Doom956/Robocup-Junior-Theseus/SIM_WORKLIST.md

# Simulator work list for the fast PC (written 2026-10-18)

**How to start:** on the fast PC, `git checkout main`, `git pull`, `git fetch`, open Claude Code in this folder and say
**"work through SIM_WORKLIST.md"** (or name one item). Work top to bottom unless I say otherwise. Tick items off in this
file (`[x]` plus a one-line result) and push, so both PCs see the progress.

## 2026-10-20: regression check, two sim fixes, avoidance in a corridor (P2 / P3, waiting for the user's decision)

All numbers on the current sim (9904879 + 71f1e4f), 600 comp fields, seeds 1-600 / 601-1200, +- = 95% interval.

- [x] **Sim fix: the BNO055 updates at 100 Hz** (9904879). Reads within 10 ms return the same sample; before, every read
  had fresh noise. robot-test score -0.7 +-3.3, home -1 +-4, bench/turn numbers the same.
- [x] **Sim fix: a run starts with the pause switch flipped** (71f1e4f, `startPauseS` 0.5).
  - The robot starts every run from PAUSE (white reference on the start tile, run clock, heading zero). The sim didn't, so
    the code's first PAUSE was a referee restart.
  - Since 68e0c47 that restarted the run clock mid-run. Main's home rate looked 5 pts worse for 68e0c47; with the fix it is
    +1 / +3. Also, the white reference had been taken on a checkpoint.
- [x] **Regression check: robot-test (fa2636b: ramp guard, blue wait, 2p) vs the known-good versions.**
  - vs `known-good-2026-10-19`: score +1.8 +-3.0 / -0.2 +-2.8 / +0.5 +-2.8 (third set: seeds 1201-1800), home -3 +-3 /
    -2 +-3 / 0 +-3, time lost 0 / +1 / -1. No measurable regression.
  - vs `known-good-2026-10-17`: +81.8 / +78.5, home +28 / +24, time lost -25 / -24.
- [x] **main vs its 2026-10-17 build (a04df32): home -6 +-5 / -6 +-5** (score -0.3 / +2.3, time lost -7 / -9). Step by step:
  - 6a9f87e (the 2026-10-17 robot fixes): home -4 +-5 / -8 +-5, time lost -10 / -8.
  - 357f049 (ramp guard): home -6 +-3 / -2 +-3.
  - Others within +-2 (68e0c47 neutral once the sim start was fixed).
  - Both were added after real failures and stay (user, 2026-10-20). Main is lost 56% of the time in the sim; the robot
    runs robot-test.
- [x] **When the ramp cap (3 tiles) fires** (300 runs each):
  - main 123 times, robot-test 37 times. Every time but one, a `climb timeout` happened in the same move: the sim robot was
    stuck on the slope and the wheels counted 13-25 "ramp tiles". The cap only changes which wrong count a stuck robot
    keeps.
  - Main gets stuck on ramps more (no 2l ramp fixes), so its home number moves.
  - The real robot has never logged a `climb timeout` (all logs 2026-10-17/19), and in the lift test the 35 deg check
    alone handled it. robot-test: no home drop on 3 seed sets.
- [x] **Obstacle avoidance in a 280-300 mm corridor (T1 tests 6 and 2): P2 + P3 applied (user yes, 2026-10-20).** P3 on
  main (9c6757f; main alone -0.6 +-3.3 / -0.3 +-3.4, no harm) and robot-test (d55e55d, 2q); P2 on robot-test only (09b5fe7,
  2r). ROBOT_TEST 2q/2r: robot test = TEST_PRIORITY 6, watch the 300 ms lurch. robot-test now has 5 unconfirmed changes:
  no more firmware changes until a maze session confirms some.
  - Why test 6 fails (traced, sim): the drive-around (`obstacleavoidanceSteps()` in Distance.cpp, the same on main and
    robot-test) is: turn away until the far front sensor is clear; full power for 300 ms; line up on the side sensors
    (PARALLEL); then FWD: `parallel()`, read the front sensor, `fwd(TILE_MM - (front before - front now))`.
    - **a. FWD reads the front sensor while the robot is still turned 10-15 deg.** In a corridor there's no room to
      straighten. That ray hits a side wall close by, so "front before - front now" comes out at a tile or more, the
      robot drives 0 mm, and the code counts the tile. From then on the map is one tile ahead (seeds 2 and 3: `[POS]
      20,22` with the robot still in tile 21).
    - **b. PARALLEL has no limit on rotation.** It lines up on whatever the side sensors see. Seed 3 turned 120 deg into
      the next tile before driving on.
    - c. The 300 ms full-power lurch throws the robot 100-200 mm. Not changed.
  - **P3** (logic fix, main and robot-test): in FWD, `absoluteturn(turnNeededDeg(currentDir))` before `parallel()` and
    the front reading. Why it's wrong on any robot: a distance sensor turned by an angle measures along its own ray, not
    along the tile. Even with no wall in the way, that's longer by 1/cos(angle), and in a corridor the ray reaches a side
    wall first. Subtracting two readings taken at different angles doesn't give the distance driven, whatever the motors,
    grip or sensors are like.
  - **P2** (PHYSICS-DEPENDENT, robot-test): in PARALLEL, if the gyro heading is more than 35 deg
    (`PARALLEL_MAX_OFF_DEG`) off the tile direction, `fullstop()`, `absoluteturn()` back to it, and go to FWD.
  - A/B on robot-test fa2636b (score / time lost / home):

    | | seeds 1-600 | seeds 601-1200 |
    |---|---|---|
    | P3 | +1.0 +-2.2 / -0 / +2 +-3 | +2.7 +-2.4 / -1 / -0 +-3 |
    | P2 | +2.7 +-2.1 / -1 / +2 +-3 (restarts 0.63 -> 0.58) | **+4.5 +-2.3** / -1 / +2 +-3 (0.62 -> 0.54) |
    | P2+P3 | **+3.1 +-1.9** / -1 / +3 +-3 (0.63 -> 0.57) | **+4.0 +-2.5** / -1 / +2 +-3 (0.62 -> 0.54) |
    | P2+P3 on main | +1.0 +-3.5 / -0 / +1 +-4 | +2.0 +-3.5 / -3 / -1 +-4 |

  - T1 passes (20 runs per case), before / P3 / P2 / P2+P3:
    - test 6 on 300 mm tiles, 6 cases: 51 / 53 / 65 / 71 of 120. By case (corridor near, open near, corridor middle,
      open middle, corridor far, open far): before 4 8 6 11 7 15, P2+P3 5 12 10 16 13 15.
    - test 6 on 320 mm tiles, 5 cases: 29 / 30 / 34 / 35 of 100. The open-side far-end case on 320 mm tiles is left out:
      it shows 0/20 every time, but the robot drives round through the open side and explores everything; the judging
      wants a "cleared blocked edges" that isn't needed there.
    - test 2: unchanged by all of them (300 mm: 19 / 17 / 14; 320 mm: 16 / 9 / 12, near / middle / far). Its fails are
      detection, not avoidance: the obstacle is at the robot's corner (B3; needs M4 with a box on the robot).
  - Read: P2 carries most of it (clear on both seed sets). P3 alone is not clear in the score (both intervals include
    zero) and adds little to test 6 (+2 / +1). It is still a geometry bug. Also tried: P1, hug the far wall during the
    closing drive: +0.3 / -0.9, nothing on top of P3 in test 6, dropped.
- [x] **Blue wait refinement** (wait only when the robot's middle is past the blue tile's edge): skipped (user, 2026-10-20).
  Test 7 passes 19/20 with the 6 s wait; an extra wait is cheaper than a wrong lack-of-progress call.

## NOW: rehearse the next robot tests in the sim (added 2026-10-19 evening, do these first, in order)

The ramp guard passed on the robot (logs/2026-10-19/lift.txt, robot-test 09fa442). The next maze session runs
TEST_PRIORITY.md tests 2-7: the obstacle strategy and relocalize have never been tested on purpose on the robot. Rehearse
them in the sim first, so robot time isn't spent on a test the code can't pass. Report only: no firmware changes without
telling me first. Scenario code is sim-only (separate commit).

- [ ] **T1. The TEST_PRIORITY tests as sim scenarios** (robot-test, 300 mm and 320 mm tiles, ~20 runs each with placement
  noise). Set up each one exactly as written in TEST_PRIORITY.md:
  - 2: obstacle (5-9 cm, touching a side wall, at most ~9 cm into the path) at the near end, middle and far end of the
    tile ahead;
  - 3: robot 40-50 mm off-centre toward an open side at a wall end, then also turned ~10 deg;
  - 4: after 3-4 tiles, carry the robot back one tile (same heading) and resume;
  - 5: on the way home, carry it one tile away from the start and resume;
  - 6: a dead end whose only way out passes an obstacle;
  - 7: an obstacle touching a side wall in the first half of the tile after a blue tile.
  For each, report: pass/fail by the TEST_PRIORITY criteria, the log lines it prints (so I know what to look for), and for
  any fail the cause from `--trace`.
- [x] **T1 result (2026-10-19, sim only, robot-test 09fa442, 20 runs per case).** Sim commit 917e302 adds
  `--scenario t2/t3/t6/t7` and the hand-carry events; see the README. Pass counts are for 300 / 320 mm tiles.
  **Two tests can't pass as written; the code itself causes this, not the sim:**
  - **Tests 4 and 5 use a pause.** On robot-test, resuming after a pause puts the code's position back on the last
    checkpoint and turns the robot to the gyro's zero (PAUSE state).
    - Test 4 as written (pause, carry back, resume): 0/20 and 0/20.
    - Test 5 as written: 0/17 and 0/19, because comp fields have silver tiles. The code thinks it is on the last checkpoint,
      not near the start.
    - Test 5 with no checkpoint visited (`testNoCheckpoints`): 9/17 and 12/16. Put next to the start on the south side, it
      passes every time (after resuming it faces north, so that tile is "behind"). On the other sides it passes ~60%; otherwise
      it stops on the wrong tile (referee restart).
    - **For the real test:** no silver tile visited yet, and carry it to the tile south of the start.
  - **Relocalize only checks tiles it has visited before** (`checkTileMismatch` skips unvisited tiles). Carried back one
    tile right after reaching a new tile, with no pause: 0/20 and 0/20. The old tile's walls get written onto the new tile.
    - The same carry on a revisited tile: 9/20 and 12/20.
    - The fails: the two tiles differ by fewer than 2 walls, or the correction picks another neighbour.
    - Holding the robot still through one move: no `position corrected`, but the position stays right in 15/20 and 15/20,
      because `[FWD] no progress` catches it.
    - **For the real test:** do it while it drives back through tiles it has already seen. Hold it still for one move (a
      hand on the robot) instead of a pause.
  **Test 2, obstacle touching a side wall of the walled tile ahead** (first approach only: the field lets the robot come back
  into that tile from the far side later, which isn't part of the test):
  - near end: 20/20 and 16/20 (half block at the move start with `obstacle left/right: fl=.. fr=..`, half stop mid-move);
  - middle: 14/20 and 8/20; far end: 14/20 and 11/20.
  - The fails drive past it (2-6 per case) or touch it for 0.1-1.8 s, the obstacle at the robot's corner where neither front
    beam sees it (B3); `[FWD] no progress` catches some.
  - Look for: `obstacle ahead during the move: fl=.. fr=.. at N mm` -> `[FWD] obstacle, backing up to start tile` ->
    `obstacle ahead: blocking edge`.
  **Test 3, wall end, no obstacle:**
  - 45 mm off-centre: 11/20 and 20/20.
  - Also turned 10 deg: 8/20 and 12/20 (`one-sided reading while not square: squaring up and looking again`, then still
    `obstacle left: fl=72-81 fr=600+` -> `blocking edge`).
  - Switched on turned, so the gyro thinks it is square: 3/20 and 6/20.
  - At 45 mm off on 300 mm tiles, the robot's side passes ~4 mm from the wall end, so the front-left sensor really sees it at
    70-80 mm. On the 320 mm practice tiles there is room, which is why that case passes there.
  **Test 6, dead end behind an obstacle:**
  - walled corridor: 0-4/20 per position; open on the obstacle's free side (`testWide`): 0-5/20.
  - It blocks the edge, clears it once nothing is left (`map looks finished early: cleared blocked edges`), then the
    avoidance steps (`obstacle avoidance`, `turn step`, ...).
  - It touches the obstacle and either never gets past it (4-13 per case) or gets past with the position wrong (1-9).
  - So the sim expects test 6 to fail: avoidance in a corridor 280-300 mm wide isn't reliable.
  **Test 7, obstacle on or after a blue tile:**
  - after the blue tile: 18/20 and 15/20 (`[FWD] on blue: waiting 5 s first` before backing up).
  - in the blue tile's first half: 8/20 and 9/20. 15 runs drew a referee call: "left a blue tile before 5 s".
  - Cause: the `[FWD] no progress` back-up path (movement.cpp, `noProgress` branch) has no blue wait; only the obstacle
    back-up path has it. Logic fix candidate, **not made** (needs your OK): the same `blueSeen` 5 s wait in the
    no-progress branch. Note: TEST_PRIORITY 7 says "after a blue tile", ROBOT_TEST 1e says "in its first half"; both were run.
  Per-run Serial lines: scratchpad `t1-out/` (not in the repo).
- [x] **T2 result (2026-10-19).** Sim, robot-test, 600 comp fields per seed set:
  - Seeds 1-600: `position corrected` fired 224 times in 148 runs (0.37 per run).
    - 147 fixed a wrong position, 60 left it wrong, 17 made a right position wrong.
    - Of the 147 fixed, 58 were still right on every tile read in the next 30 s, 28 went wrong again (the rest had no tile
      read in that time: run over, or driving home).
  - Seeds 601-1200: 163 firings in 123 runs (0.27 per run).
    - 103 fixed, 46 left it wrong, 13 broke a right position, 1 changed nothing.
    - Of the 104 fixed, 45 were still right after 30 s and 12 went wrong again.
  - So ~65% help, ~27% don't help, ~8% do harm.
  Real logs (the map rebuilt from the logged `[POS]` + wall reads; the firmware doesn't print mismatches):
  - 2026-10-19 run1 10:48:13 and run2 10:53:42: no later read disagrees with the map. Run1 was home 27 s later.
  - B8 15:21:34 and 15:44:51: no disagreements.
  - B7 15:15:10 and B8 15:32:58 / 15:35:57: 1-3 later reads at the start tile (20,20) disagree with its first record
    (2-3 walls). They came after a stop at the start and a restart, so it can't be told which record was wrong.
  - B2 / B5: that firmware printed no `[POS]` lines, so they can't be checked.
- [x] **T3 result (2026-10-19):** `pitch over 35 deg` fired 0 times on 1200 comp fields (robot-test, seeds 1-1200, ramps up
  to 25 deg).
- [x] **Open from T1/T2:** TEST_PRIORITY tests 4 and 5 changed to the setups above (user, 5471a1f).
- [x] **Blue wait (2026-10-19, robot-test, logic fix, pushed with a ROBOT_TEST entry).**
  - Before, the robot waited on blue only before the obstacle back-up, not before the no-progress back-up.
  - Also, the 5 s started at `fullstop()` while the robot was still braking, so it stood still only 4.9 s.
  - Now both back-ups wait 6 s.
  - Sim, test 7 (obstacle in the blue tile's first half): 300 mm tiles 8/20 -> 19/20; 320 mm tiles 9/20 -> 9/20. On 320 mm,
    the remaining calls are obstacle avoidance on the way home driving through the blue tile without stopping: open, not
    fixed.
  - Sim, 600 comp fields: -0.2 +-0.8 / +0.6 +-0.7. pio builds.
- [x] **Relocalize (2026-10-19, sim, robot-test, B9): nothing to change yet.** Every correction on seeds 1-600, sorted by
  what really happened:
  - fixed: 154 of 215 (72%);
  - was off by 2+ tiles: 24;
  - corrected a right position because a tile was mapped wrong earlier: 13;
  - on the wrong floor: 6;
  - off by one but picked the wrong neighbour: ~16;
  - walls misread: 4.
  Tried: when no neighbour matches, a unique match two moves away. Score +0.8 +-1.0 / +0.3 +-0.6, home +2 +-1 / +1 +-1,
  but it was right in only 31 of 204 of its own corrections (repeated wrong ones in a few runs). Dropped. The bigger gap is
  that mistakes on new tiles can't be seen (T1, test 4).

## NEXT: tasks after the 2026-10-19 maze session (do these first, in order)

The robot passed 2l-2o in the maze (ROBOT_TEST.md on robot-test, logs/2026-10-19); robot-test is now `d5ed8aa`, tagged
`known-good-2026-10-19`, and the "Not yet confirmed" list is empty (room for up to ~5 new robot-test changes).

- [x] **N1 result (2026-10-19, sim, 300 mm tiles):** 9205f12 -> d5ed8aa: +0.0 +-2.5 / -1.1 +-2.2, home -2 / -1 pts, time
  lost +0 / +0: no clear harm in the score. Stop after descents (at the next colour read): median -1/-1/+2 mm -> +1/+2/+10
  mm for 1/2/3-tile ramps, but more than 30 mm past 4/2/1 -> 17/21/26 per ~150-185 descents (1-2% -> 10-18%); climbs
  unchanged. The robot's 31-53 mm "short" was on 320 mm practice tiles (~20 mm of it is the longer tile): on 300 mm
  competition tiles that is ~11-33 mm, so 180 likely over-corrects there (the sim says so). **Corrected (user, 2026-10-19):**
  the robot measured climbs (-10 to -22 mm) and descents (-31 to -53) on the same practice tiles, so the ~25 mm up/down
  difference isn't the tile size; and the sim's slope speed is ~30% off (A4), so its descent stops aren't trustworthy.
  180 stays (ROBOT_TEST.md 2l). Re-check after fitting the sim's slope speed to the A4 timings (below).
  **Re-check with the slope speed fitted (2026-10-19):** `slopeDrag` 0.8 gives the robot's practice-ramp timing (sim 1.78 /
  1.70 s up / down, robot ~1.72 / 1.82). On 320 mm tiles at 14 deg, 1-tile ramps, the first centring from a wall ahead after
  a ramp: 155 mm both ways: up median -68, down -67 (robot: up -10 to -22, down -31 to -53); d5ed8aa (180 down): up -64, down
  -41. The sim still reads ~40 mm more "short" than the robot after ramps and shows no up/down difference: its ramp exit
  isn't modelled well enough to judge the descent setting. 180 stays (robot decides). slopeDrag added as a parameter,
  default 0 until the ramp exit matches (sim-only commit).
- [ ] **N1. Sim-check the down-ramp change** that went straight onto robot-test from the robot (`d5ed8aa`:
  `RAMP_END_TO_MIDDLE_DOWN_MM` 180, up stays 155). Real evidence: 5 descents stopped 31-53 mm short, 4 after the change
  -23 / -16 mm or no centring needed. A/B `9205f12` vs `d5ed8aa` (both seed sets) and the stop position after descents
  (stopcentre.py). Report only: it stays on robot-test unless the sim shows clear harm, and then tell me before changing it
  (real robot beats sim).
- [x] **N2 (2026-10-19):** sim option `--set tileMm=320` (tile pitch; robot still drives 300 mm), sim-only commit.
  robot-test (d5ed8aa) on 320 vs 300 mm tiles: +10.4 +-4.6 / +9.5 +-4.4, ever lost 48% -> 38-39%: the practice maze is
  easier (more room). Centring readings reproduce the robot: from a wall ahead median -40 mm on 320 mm tiles (robot
  2026-10-19: -37), -13 on 300; from a wall behind +25 (robot +22). So the "short" readings are the practice tiles; on
  competition tiles expect ~-13. 300 mm tiles unchanged by the option (default).
- [ ] **N2. Practice maze in the sim (A3).** The practice maze has 320 mm tiles, walls on the joints, ~300 mm path (CLAUDE.md;
  the robot's moves are 300 mm). Add it as a field option and run robot-test on it, so practice-maze logs can be compared
  with the sim: centring readings ("short" ~25-30 mm from a wall ahead), how often it gets lost, how it gets home.
  Also check robot-test on 300 mm tiles stays as before (the competition size).
- [ ] **N3 (in progress, 2026-10-19):** the robot logs: front-left 8190 (looking down the ramp), front-right 58 mm = about
  the distance to the tile edge on a 320 mm tile (160 - 98): it sees the end of the ramp's side wall, which needs the
  robot ~40+ mm off-centre sideways (it arrived going north on a 320 mm tile, ending short; after turning east that is
  sideways). In the sim this exact case is rare (19-43 per 200 runs), but one-sided obstacle alarms in general are false
  more often than real: 439 false vs 294 real per 200 runs on 300 mm tiles (false: 352 at move start, 73% with the robot
  30+ mm off-centre sideways, 62% with its true heading 3+ deg off while the gyro says square). Test: square up on the
  walls (parallel()) before deciding at move start: false at start 352 -> 285, real still caught (start 148 -> 139, mid
  146 -> 159); A/B on robot-test 703472e +1.4 +-2.6 / +0.8 +-2.7, home +2 / +1, time lost -1 / +1: no clear gain, held.
  The ramp-top case itself is mostly the practice maze (320 mm tiles): watch it on 300 mm tiles.
- [ ] **N3. False obstacle beside a ramp top.** Both runs on 2026-10-19 (logs/2026-10-19 run1.txt, run2.txt, run2b.txt):
  at the tile next to the top of a ramp (map 23,18 floor 2), facing the way down, the one-sided obstacle check fired:
  front-left out of range (8190, looking down the ramp), front-right 58 mm (mid-move, 17 mm in) / 84 mm (move start).
  The robot blocked that edge and turned around; it still explored everything and got home. It didn't happen on
  2026-10-17. Suspects: the robot ends that tile a bit south of its middle (it came north from the ramp top, 2m no longer
  centres on a wall one tile behind, the practice maze is 20 mm longer per tile), so the front-right sensor catches the
  end of the wall beside the ramp. Reproduce in the sim (ramp approached from the side; practice-maze tiles too), then
  try: on a one-sided reading at about the distance of the tile edge (40-90 mm), square up / re-centre along before
  deciding, as the start-of-move check already does for turns > 3 deg. Physics-dependent: robot-test with a ROBOT_TEST entry.
- [x] **N4 (2026-10-19):** logic fix on main (357f049) and robot-test (703472e): a pitch over 35 deg isn't a ramp (rules
  3.1.5: ramps <= 25 deg), at most 3 ramp tiles per climb. Sim: robot-test -1.3 +-2.9 / +0.8 +-2.7, main +0.9 +-2.4 /
  +0.8 +-2.3 (main home -4 +-3 on seeds 1-600 / +0 on 601-1200: main is lost in 99% of its sim runs). On the robot-test
  unconfirmed list (test: lift the robot mid-move).
- [ ] **N4. Lifted robot counts dozens of ramp tiles** (logs/2026-10-19 ramp.txt, 11:07:32-35: the robot was picked up
  while running, pitch up to 55 deg, ~60 "1 section of the ramp climbed" in 3 s, the map ran out). Rules 3.1.5: ramps
  are at most 25 deg. Logic fix candidate: in the climb loop, a pitch over ~35 deg is not a ramp (stop counting, or end
  the move), and/or cap the sections per ramp (B10's cap, held before because it changed nothing in the sim: real-robot
  evidence now). Logic bug -> main + robot-test if the A/B shows no harm.
- [x] **N5 (2026-10-19):** held as asked. Numbers (B8, sim): reading every 3rd loop cuts restarts 0.60 -> 0.44 per run, runs
  with a restart 45% -> 38% on both seed sets, score +2.6 / +2.0 (noise). The robot caught 3 of 3 starting from a tile
  middle; the sim's misses also start from tile middles at full speed. Revisit if a robot run ever goes half onto black.
- [ ] **N5. Black tile: colour read cadence (B8) — hold.** Real robot 3 of 3 caught black after 92-98 mm of the move (only
  a little onto the tile): the read every 10th loop lands just after the tile edge when moves start in the tile middle.
  Only test reading more often if the sim shows real cases starting off-centre (after avoidance / short moves) going half
  onto black. Report numbers, no change unless clear.
- [x] **N6 (2026-10-19, sim 3253949+, robot-test 703472e):** known-good-2026-10-19 -> robot-test (+ ramp guard): -1.3 +-2.9 /
  +0.8 +-2.7, home +0 / +0, time lost +1 / -1: no regression. main -> robot-test +91.1 +-4.9 / +93.0 +-5.3, home 28% -> 80%
  / 30% -> 80%. D2 now: score 159.9 of 227.7; blue revisits -28.1, unexplored -25.7, restarts -7.8 (0.67 per run), not
  home -6.2 per run; first wrong position: false obstacle alarm 23%, pushed obstacle 20%, real obstacle 20%, move 15%,
  ramp 11%, scraped wall 5%. Ended home 490, no path 86, time 24 (of 600). PORTFOLIO.md row updated.
  **Question (2026-10-19):** "pushed obstacle 20%": loose obstacles (`obstacleMovableFrac`) are off by default, so which
  settings did this lostcause run use, and what does "pushed" count (an obstacle that moved, or the robot driving into a
  fixed one)? Say so next to the number.
  **Answer:** default settings (`lostcause.py origin/robot-test --runs 600`, no `--set`), so every obstacle is fixed
  (`obstacleMovableFrac` 0). The name is misleading: "move: pushed obstacle" is an ordinary move during which the robot
  touched an obstacle the code hadn't seen (contact next to an obstacle, lostcause.py); the obstacle didn't move, the
  wheels slipped and the encoders counted distance the robot didn't drive. Read it as "drove into an unseen obstacle".
- [ ] **N6. Re-check robot-test vs `known-good-2026-10-19`** after N1-N4 (CLAUDE.md rule), and update D2 (what loses
  points now) and the PORTFOLIO.md results row.
- Still open further down, after N1-N6: A2 (largely explained by the 320 mm practice tiles), A4 (ramp climb timing: the
  new logs have millisecond timestamps), B2 (obstacles between the front beams), B3 (corner obstacles: needs the M4+box
  robot test first), B11 (speed-sensitive settings, only if A1/N2 change the motor model a lot).

---

## Rules for every item (from CLAUDE.md)

- A/B with `tools/sim/physics/ab.py` on **600 comp fields, both seed sets** (`--start 1` and `--start 601`). Report score,
  time lost and back home with their 95% intervals, plus restarts per run and the worst-10% line.
- Label each change. **Logic bug** (wrong on any robot): main, if the A/B shows no harm and `pio run` builds; also merge
  it into robot-test. **Physics-dependent** (gains, powers, thresholds, avoidance behaviour): robot-test only, with a
  ROBOT_TEST.md entry: what changed, why, the numbers, and a short real-robot test (what to run, what to watch in the log).
- **Strategy changes need my yes** after I've seen the 600-field numbers (e.g. when to drive around obstacles, when to
  go home, exploring order). Write them up and hold them.
- Simulator parameters only from CAD, datasheets, the 2026 rules or measurements on the robot; mark anything else
  "assumed" and test a range. Don't push a sim fit that isn't backed by a measurement.
- After any change to the simulator itself, re-run main vs robot-test (both seed sets) and note it in NEXT_STEPS.md.
- The robot runs **robot-test**. Never run main on the robot while the replacement left-back sensor is fitted.
- Rules: `RCJRescueMaze2026-final.pdf` (junior.robocup.org, last updated 2026-03-29). Key ones below are quoted by number.

---

## A. Make the simulator match the robot better (do first: every later result depends on it)

- [x] **A1 result (2026-10-18):** M7 can't be the motor speed fit: fitting it (166 RPM, friction 0.11) breaks M3 (1.4 s
  vs 1.1), M1 (1.7 s vs 0.8-1.0) and bench tests 2/3 (50 / 84 vs 25-30 / 92-97). Free wheels can't be slower than on the
  floor at full power. Correction (user): the first M7 (36-38) was with the battery OFF (USB only); the second had the
  battery on, voltage unknown, so "low battery" is a guess. fw(150) (66/67/89 RPM = 276-373 mm/s) is consistent with a
  1.1 s tile at PWM <= 150: check the fit against fw(150). Wheel spread: most of it is motor A (already modelled by
  motorAExtraFriction); B vs D 4-8% at full power. 12% stacked on top of motor A cost -15.3 +-6.3 but double-counts A:
  0.05 vs 0.03: -2.5 +-3.6 (no clear effect): default 0.05. Speed fit vs fw(150): matching M7 at 150 (145 RPM: 73-80 vs real
  66-89) makes a tile 1.31-1.36 s (real 1.08-1.13) and turns 1.33 s; with 170 RPM the tile matches but M7 at 150 reads
  88-94. One speed can't match both: the sim's fwd() dynamics differ somewhere (motor response, slow-down near the end).
  Kept the tile-time fit (that's what navigation timing depends on); open until M7 is repeated with the voltage. Next robot session: charged battery, note the voltage, redo M7, and swap
  motor A's plug with another motor's (if the weakness moves with the motor, it's the motor). Selftest prints M7.
- **A1 follow-up (2026-10-18, robot, battery 11.98 V measured, firmware 4800419):** M7 repeated with a full battery:
  fw(255) **119 / 140 / 145 RPM** (A/B/D), fw(150) **60 / 93 / 79**: the same as the first battery-on run (118/139/150,
  67/66/89). So it is not a low battery: the free-running wheels are ~10-20% slower than the sim's fit (158 / 90). The
  conflict with the tile time (1.1 s) is real and needs explaining (load model? encoder RPM maths? PWM-to-voltage?), not
  discarding. M8 with a loose (untaped) box: pushed it ~260 mm of a 300 mm move with no false stop (B14 data point).
  M3 move 1: 292 mm, 1.08 s. Log: logs/2026-10-18/move_tests6.txt.
  Checked on the fast PC (2026-10-18): 145 RPM (friction 0.05) matches M7 at both powers (sim 131/146/125 and 74/83/71)
  but makes a tile 1.35 s; a faster motor response (motorTau 0.02 / 0.01, assumed) doesn't help (1.36 / 1.42 s). The
  robot's ~275 mm/s average over a tile needs a cruise close to its free-running speed (~320 mm/s at PWM 150), so it
  loses much less time accelerating/slowing than the sim, or the timing reads differently: needs the speed profile within
  a move. serial_log.py now stamps every line to the millisecond: the next M3 (and maze) log gives it. Fit kept at
  170 RPM until then (it matches the moves the navigation depends on); the conflict is open, not explained away.
- [x] **A1 resolved for navigation (2026-10-19, ms-stamped maze logs run1/run2/run2b):** 84 normal one-tile moves on the
  robot vs the sim (robot-test, default fit 170 RPM): time 1.04 / 1.03 s, cruise (100-200 mm) 339 / 346 mm/s, loop 34 /
  33 ms, start->100 mm 0.42 / 0.41 s, last 50 mm 0.19 / 0.17 s. The fit matches the moves navigation depends on; 150 RPM
  (closer to M7) gives 1.16 s and 305 mm/s (too slow). The M7 numbers (wheels free at fixed PWM 150: 60/93/79 RPM, avg ~324
  mm/s) also agree with the robot's ~339 mm/s cruise; what differs is only the sim's free-wheel speed at a fixed PWM
  (88-94 RPM): the PWM-to-speed curve at constant PWM, which fwd() never runs at (steering varies the power). Left as is.
- [ ] **A1. Motor speed from M7.** Move test M7 (2026-10-18, logs/2026-10-18/move_tests2.txt), wheels in the air:
  fw(255) **118 / 139 / 150 RPM** (wheels A / B / D), fw(150) **67 / 66 / 89**. The sim's fit is ~158 / ~90. Refit the
  motor model to these (per wheel if the model allows: wheel A is the weak one, as in bench test 4), then re-check that
  M3 (one tile ~1.1 s, ~300 mm), M1 (90 deg in 0.75-1.0 s) and bench tests 2-4 still match (`--selftest`).
- [x] **A2 explained (2026-10-19):** the robot's "short" stops in the practice maze are its 320 mm tiles (moves are 300 mm):
  with tileMm=320 the sim reproduces the robot's centring readings (from a wall ahead -40 vs robot -37 mm median, from a wall
  behind +25 vs +22); on 300 mm competition tiles the sim reads -13. See N2. B11 not needed: A1 kept the motor model.
- [ ] **A2. Where moves stop.** The robot was seen stopping short of the tile middle (video 2026-10-17); robot-test 2m
  (back-wall centring only for this tile's wall) should have fixed most of it. When the next maze log comes in, run
  `tools/robot_log.py` ("stops along the tile") and compare with `stopcentre.py` on the sim. Fit if they differ.
- [ ] **A3. Practice maze size.** When I measure it (inner wall faces across a tile, wall thickness), add it as a field
  option and re-run robot-test on it. The robot_log centring numbers suggested walls ~25-30 mm further than RCJ's.
  **Measured 2026-10-19 (user): tiles 320 x 320 mm with the 20 mm walls on the joints: pitch 320 mm, path ~300 mm
  (measured 295 between wall faces)** (RCJ 2026 rule 3.1.2: exactly 30 x 30 cm, 28 cm path; the old
  +-10% tile size allowance was removed). So every 300 mm move comes up ~20 mm short on the practice maze: this is most of
  the "stops near the back of tiles" and the ~25-30 mm "short" centring readings. Not a competition problem. Run robot-test
  in the sim on 320 mm tiles too (practice maze), so practice-maze logs can be compared with the sim.
  **Measured 2026-10-19 (user):** wall thickness **20 mm** (as RCJ), inner wall faces across one tile **295 mm** (RCJ
  280: 15 mm wider, 7.5 mm per side). That explains only part of the ~25-30 mm "short" the centring reads from a wall ahead
  (front sensors also read ~6 mm long at the bench). Model the practice maze (295 mm path) as a field option, check where
  the remaining ~10-20 mm comes from, and confirm robot-test is fine on both 280 and 295 (the competition uses 280).
- [x] **A4 measured (2026-10-19, ms-stamped logs ramp.txt, ramp_down.txt, run1, run2):** practice ramp (13-15 deg, one
  320 mm tile): 17 crossings 1.62-1.91 s on the slope (median ~1.75), 36-43 climb loops (~46 ms each), up (PWM 180) = down
  (PWM 120); one climb 4.73 s / 131 loops (held back?). Sim with tileMm=320, 14 deg: 1.22 s, 20-21 loops (~58 ms each), up
  = down. So the torque fit (up = down) holds, but on the slope the robot is ~30% slower (~190 vs ~270 mm/s) and loops
  faster. Not explained (candidates, none measured: the climb loop's side-wall steering slowing one side, the BNO055 pitch
  lagging/smoothing the start and end of the tilt, rolling resistance on the slope): no fit made. Matters little for
  navigation (crossing time; 2l's stop distances were confirmed on the robot).
- [ ] **A4. Ramp climb timing.** Real ramp climbs take ~38 fwd() loops, the sim's ~23 (NEXT_STEPS 1c). Find out why
  (motor torque on the slope, grip, loop timing) once a log with millisecond timestamps exists.
- [x] **A5 result (2026-10-18):** bumps are modelled (comp fields ~6 bump tiles, 10 mm = the 3.4.1 maximum, never on
  ramps or stairs, 5 points per tile). A 1 cm bump under the 116 mm wheelbase tilts the robot <= ~5 deg in the sim (robot
  ~7 deg measured), under RAMP_PITCH_DEG 12; no bump-caused losses in today's lostcause runs. Dangerous-zone bumps (2 cm,
  also on ramps, 3.5.4/3.5.7) not simulated (dangerous zone left out on purpose). Found while reading 3.4: obstacles "may
  be any shape", "large, heavy items", >= 15 cm tall, NO size limit (3.4.3); the sim's 5-9 cm cylinders are an assumption
  and the hardest case for the front sensors: test a range of sizes under B2.
- [ ] **A5. Speed bumps** (rules 3.4, 5.6.8: 5 points per tile crossed). Model them (height from the rules) and check the
  robot doesn't mistake one for a ramp (RAMP_PITCH_DEG 12; a bump tilts this robot ~7 deg) or lose its position on one.
- [x] **A6 result (2026-10-18, rules PDF of 2026-03-29):** 5.6.6 blue 30, -10 per revisit, never below 0 per tile; 5.6.7
  reliability non-negative, 10 x SBV - 15 x LoP; 5.6.8 bumps 5 per tile; 5.6.9 ramps 10 once per ramp; 5.6.11 checkpoints
  10; 5.6.12 exit +10 per SBV, +5 per ramp; 5.6.13 no duplicates; total never below 0: all as the sim scores them
  (victims, stairs, misidentification not simulated). Exit bonus needs >= 10 s blinking 1 s on / 1 s off with the
  victim LED: the code blinks LEDPIN (51, the victim LED) 1 s on/off at home until paused. 5.5.2: after a LoP the
  robot may be put down facing any direction: the code turns to gyro 0 (the gyro tracks while carried); the sim now
  does that (lopAnyDirection 1, was always the start direction). 5.3.1: the 8 min include calibration, but the code's
  clock starts at power-on (RUN_TIME_S 480) and the sim's at the run start: if the team spends time on the field before
  powering on, lower RUN_TIME_S (team procedure, not changed).
- [ ] **A6. Scoring check against the 2026 rules:** blue tile revisits -10 each (5.6.6), reliability bonus with -15 per
  LoP (5.6.7), exit bonus (5.6.12: +10 per victim and blue tile, +5 per ramp), no duplicate rewards (5.6.13), the 8 min
  including calibration (5.3). Make sure the sim's score does all of these.

## B. Navigation: points still being lost (biggest first)

- [x] **B1 assessed (2026-10-18/19):** on the fitted sim, ~3 blue re-entries per run; only ~0.2 per run had another known
  route (blueavoid.py: EXEC avoidable 0.16, RETURN 0.05 per run): at most ~2 points from routing around visited blue
  tiles. The rest pass back out of areas behind a blue tile (the only way in/out). Earlier tries: routing around all blue
  +0.6 +-0.6, planner weighting 3/6/10 tiles no effect. Not worth a strategy change now; exploring order (B7) is the only
  lever left.
- [ ] **B1. Blue tile revisits.** Rule 5.6.6: every revisit of the same blue tile costs 10 points, and each entry is a
  5 s stop. Real run 2026-10-17: 5 blue stops with 2 blue tiles. Measure how often the sim re-enters blue (scoregap.py)
  and try: (a) the planner prefers routes that avoid visited blue tiles when another way exists (the earlier try routed
  around *all* blue: +0.6; try only visited ones, and on the way home); (b) when exploring, visit a blue dead end last.
  Strategy-ish: report before keeping.
- [x] **B2 (part, 2026-10-18): obstacle size and repeated tries.** Rules 3.4.3 give no obstacle size; the sim's 5-9 cm
  is assumed (now `obstacleRMinMm/RMaxMm`). [Withdrawn, see B13: the big sizes were placed against walls, against rule 3.4.4b.] robot-test with 10-15 cm obstacles -17.1 +-5.2, 15-20 cm -22.6 +-6.2 (ever
  lost 56% -> 74-79%); no obstacles +22.5 +-4.9. Big obstacles: the robot stops (no-progress) correctly, "map looks
  finished early" clears the block at once (B4), and on the 3rd try the 2k guard had switched the check off: it drove in.
  Fixed on robot-test (2o): the check stays on: -0.6 / -0.5, ever lost 55% -> 47%. Tried and dropped: a late one-sided
  stop (front <= 45 mm, other >= 100, after 250 mm): +0.0 / -0.5; driving around on every second try even when the
  obstacle isn't seen at the start: -18.6 / -11.8 (the avoidance manoeuvre gets lost).
- [ ] **B2. Obstacles between the front beams** (lostcause 2026-10-18: obstacles cause ~75% of lost runs; most are
  obstacles in the gap between the two front sensors, pushed by the robot). Ideas to test, in this order:
  (a) the BNO055's accelerometer: a sharp deceleration when the bumper hits something (does the sim model it? needs a
  real measurement first: add a move test that logs acceleration while hitting the box); (b) heading disturbance: a
  robot pushing an off-centre obstacle gets turned (gyro yaw rate while the encoders say straight); (c) encoder speed
  dropping while PWM is unchanged; (d) side sensors' change vs encoders. Each as a no-progress-style check; count false
  stops per 100 runs as well as the score.
- [ ] **B3. Obstacles at the robot's corner.** The simple side-front < 30 mm rule fired at every wall start/end
  (-77, dropped). Needs real readings: move test M4 + box against the wall (robot test, see NEXT_STEPS section 3).
  Then: only when the map says there is no wall on that side at that point along the tile.
- [x] **B4 (2026-10-18):** keep an obstacle block for good once the no-progress check stopped the robot twice at that edge
  (after 2o): -0.3 +-0.5 / -1.2 +-1.1, big obstacles +0.0 +-0.9: no effect, held. (Earlier: keep blocks < 60 s old -20,
  keep while something else is open -1.0 / +2.3.) The case that motivated it is now handled by 2o.
- [ ] **B4. Obstacle blocks cleared too early** ("map looks finished early" clears a block made seconds before). Tried:
  keep blocks made in the last 60 s (-20, explores less) and keep while something else is open (-1.0 / +2.3). Try:
  keep a block until the robot has explored N more tiles, or clear only blocks made more than 2 min ago. **Strategy:
  report, don't keep without my yes.**
- [x] **B5 (2026-10-19):** the loop was mostly the sim's captain: after "no path found" it called a LoP, the robot's turn
  after the restart counted as "carrying on", and it claimed "no path" again from the same spot (~17 restarts per such run,
  2.6 per run overall). A real captain ends the run after one useless restart: sim now does that (captainGivesUp 1,
  assumed; sim-only commit). robot-test +0.9 +-0.3 / +1.1 +-0.3, restarts 2.57 -> 0.60 per run. The 74 of 600 runs that end
  "no path" are lost runs (position wrong); the fix is not getting lost (B2, 2l-2o), not the loop.
- [ ] **B5. "no path found" loop** in badly-lost runs (robot-test: 2.6 restarts per run at one point; worst 10% of
  runs). Tried: drop guard walls when no path (-0.6/-0.7), write the wall only when the tile matches (no effect). Try:
  after "no path found", relocalize from the last checkpoint's map, or head for the last checkpoint and ask for a LoP
  restart deliberately (rules 5.5) instead of sitting still.
- [x] **B6 (2026-10-18):** real way home (logs 2026-10-17 partB8, the one clean trip): 7 tiles in 26 s = 3.7 s per tile,
  cameras off; sim runs home at 3.1 s per tile; the code plans RETURN_SEC_PER_TILE 5.0 + 30 s margin. With the cameras on,
  each move next to a wall can wait up to ~4 s more (victim code, not changed), so 5.0 is about right for a real run:
  kept. Lowering it only makes sense if the camera wait is fixed. 5.3.1 (8 min include calibration): see A6.
- [ ] **B6. Time management.** The 8 minutes include calibration; the exit bonus pays +10 per victim and per blue tile
  and +5 per ramp only if the robot gets home (5.6.12). Re-check `timeToReturn()` on the fitted (faster) sim:
  RETURN_SEC_PER_TILE and the margin were set on the slow sim. Measure real seconds per tile on the way home.
- [x] **B7 (2026-10-19, fitted sim, numbers only):** neighbour order left before right: -0.8 +-3.8 / +3.1 +-3.8; right
  before straight (right-hand wall follower): +1.0 +-3.6 / -2.5 +-3.6. No clear gain on the faster robot either (as on the
  slow sim): exploring order isn't a lever. Nothing to decide.
- [ ] **B7. Exploring order** (which open edge first) on the fitted sim. Earlier tries (left/straight/right,
  side-openings first, time-aware planner) gained nothing on the slow sim; the faster robot changes the trade-offs.
  **Strategy: report first.**
- [x] **B8 (2026-10-19, sim, robot-test 9205f12):** LoPs over 600 comp fields after the captain fix (B5): home on the wrong
  tile 123, drove onto a black tile 87, left a blue tile early 62, stuck 41. The black ones are normal moves with no black
  seen: fwd() reads the colour sensor only every 10th loop (~400 ms, ~120 mm at the robot's ~300 mm/s), and the sensor is
  93 mm ahead of the middle, so a read can come too late (seed 15: sensor over black from 16.92 s, next read 17.14 s).
  Reading every 5th / 3rd loop: +4.1 +-3.9 / +0.1 +-3.7 and +2.6 +-3.6 / +2.0 +-3.8; restarts per run 0.60 -> 0.44-0.54,
  runs with a restart 45% -> 36-38% (3rd: both seed sets, 46% -> 38%). **Candidate for robot-test after the next maze
  session** (frozen now; PHYSICS-DEPENDENT: speed and read time): `(_fwd_tick % 10)` -> `% 3` in fwd(). Robot test: from
  two tiles away, drive straight at a black tile 3-4 times: every time `black` and a stop before half the robot is on it.
  The real logs so far (2026-10-17) show black seen and backed off 8 times in B8, none missed (not counted how close).
- [ ] **B8. Lack of progress costs:** each LoP is -15 in the reliability bonus (5.6.7) plus the restart time. Count LoP
  causes (lostcause) and see which are avoidable: e.g. stopping 5 s on blue before backing off, black tile handling,
  stuck on ramps.
- [x] **B9 measured (2026-10-18, robot-test, 200 comp fields):** relocalize corrected 42 times, 38 right (90%), 4 wrong
  -> wrong. A wall mismatch is a strong "lost" signal: 283 times the position really was wrong, 25 times it was right
  (sensor misread), so 92% precision, but only ~1 in 7 lost moments gets corrected. Where the code was then: 1 tile
  sideways 104, 1 tile ahead/behind 64, diagonal 23, 2 tiles 21, more than 2 tiles 69. The rule only moves one tile and
  only when exactly one neighbour fits. Earlier tries (last 4 tiles, probability-based) gained nothing: needs a careful
  design (e.g. track the few most likely positions over several tiles), not a quick patch.
- [x] **B9 diagnosed (2026-10-18, before designing it):** at 426 wall mismatches with the position really wrong, the true
  tile was a visited tile (within 3) whose recorded walls match what is seen in only 102 (89 of them the unique nearest
  match); in 324 it wasn't among the matches at all (191 had no match): the robot is on an unmapped tile or the map
  around it is already wrong. So any wall-matching relocalize can fix at most ~1 in 4 lost moments, and a looser rule
  would move the robot wrongly at least as often (why the earlier tries failed). A multi-hypothesis tracker from the first
  doubtful move is the only real fix: big, uncertain. Not started; avoiding getting lost (obstacles ~75% of first losses:
  2l-2o) is worth more. Diagnostic patch and script: scratch pdiag_reloc.py / relocdiag.py (session of 2026-10-18).
- [ ] **B9. Relocalize** (robot-test 2): measure how often it fires in the sim and how often it's right; tune or extend
  (e.g. check two tiles back) only if it's often wrong or often missing a real one-tile error.
- [x] **B10 (2026-10-18, sim):** 2l holds for both directions and all lengths (robot-test, 300 comp fields, stop at the next
  colour read): up 1/2/3 tiles median +1/+2/+3 mm, down -1/-1/+2 mm; more than 30 mm off in 1-8% per case, worst coming
  down a 1-tile ramp (12 of 173 more than 30 mm short): that's the practice-maze ramp, watch it in the 2l robot test.
  The stuck-on-the-slope over-count (13-21 ramp tiles, 1.8% of crossings) stays held (those runs are lost already).
- [ ] **B10. Ramps:** a robot stuck tilted on the slope added 13-21 ramp tiles (12 of 674 crossings); the cap was held
  because those runs were lost anyway. Look for what gets it stuck (A4) and whether 2l (drive 155 mm after the ramp)
  holds for both ramp directions and lengths.
- [x] **B11 (partly, 2026-10-18):** steering gain 2 vs 1 on the 5%-spread sim: +3.1 +-3.8 / +1.4 +-4.0, keep 1. Turn
  settings, min PWM 55 were checked on the 2026-10-18 fit (keep); A1 didn't change the motor model.
- [ ] **B11. Speed-sensitive settings** after A1: turn power 45 / gain 8, steering gain 1, minimum drive PWM 55,
  MAX_STEER_DEG 10, the no-progress thresholds (2j/2n): a quick sweep of each on the refitted sim. Keep only clear gains;
  these were checked once on the 2026-10-18 fit (keep all), redo only if A1 changes the motor model a lot.
- [x] **B12 assessed (2026-10-19, no sim change):** rules 3.4.6-3.4.9: stairs as wide as the path, each step at most 2 cm,
  top at least 15 cm long, incline under 25 deg, between walls, may change the floor level like a ramp; 10 points up or
  down (5.6.10), +5 exit bonus each (5.6.12). Modelling them needs how this robot's wheels climb a 2 cm edge, which isn't
  measured (CLAUDE.md 2026-10-16: the angled colour sensor limits front clearance, it can't climb stairs forward; the
  team pushed it up a competition-like step by hand). A sim model now would be a guess. What the code would do: the front
  sensors (106 mm up) don't see a 2 cm step, so fwd() drives into it; if the wheels can't climb, the no-progress check
  (2n/2o) should stop it and block the edge (treated like a wall: no points, no harm). **Robot test first** (bench, no
  maze): a 2 cm board across the path 15 cm ahead (M8 setup, board instead of box): does it stop with `[FWD] no progress`
  and back up cleanly, or climb, or get stuck? Then decide whether stairs are worth a routine (strategy).
  **Robot (user, 2026-10-19): it climbs 2 cm steps.** Put on the floor in front of the stairs, it drove up them by itself.
  Not recorded yet:
  - the firmware;
  - the Serial log: does the code count the stairs as a ramp and change floor?
  - whether the map position stayed right afterwards;
  - going down.
  Next: a run through the stairs with a log, up and down.
- [ ] **B12. Stairs** (rules 3.4 and 5.6.10: 10 points up or down; not simulated). The real robot can be pushed up the competition-like
  step backwards and forwards (2026-10-17). Add stairs to the sim (dimensions from the rules) and see whether the current
  code climbs them, treats them as a wall, or gets lost. Only then think about a stair-climbing routine (strategy).

## B+. Obstacle placement and pushable obstacles (rules 3.4, added 2026-10-18)

- [x] **B13 (2026-10-18):** the generator's "against a wall" branch didn't check the 10 cm reach of rule 3.4.4b (fixed,
  sim-only commit). With the rule enforced, comp fields have no room for obstacles over ~9 cm: 10-15 and 15-20 cm sizes
  give 0 obstacles per field (no open area 20 cm from every wall; against a wall at most 9 cm). So the earlier "bigger
  obstacles -17 / -23" (B2 note) came from placements the rules don't allow: withdrawn. 2o stands (it was confirmed on
  the default 5-9 cm fields). Default fields unchanged by the fix. In corridors, competition obstacles are small and touch
  a wall: the corner-clipping case (B3).
- [ ] **B13. Obstacles as the rules place them.** Rule 3.4.4: an obstacle is either at least 20 cm from every wall, or
  touches a wall and is at least 20 cm from the opposite edge of the tile. In a corridor (28 cm path) that means it touches
  a wall and sticks out at most ~10 cm: the corner-clipping case (B3), not the middle-of-the-path box (M8 setup). Check the
  sim's obstacle generator follows 3.4.4 and re-weight B2/B3 by what the rules actually allow. Obstacles are at least
  15 cm tall (3.4.3a), any shape, may or may not be fixed.
- [x] **B14 (2026-10-18):** first run showed loose = fixed in every run: the push grip was wheelMu, which had become the
  turning drag (0.071) in the fit; split into pushGripMu 0.8 (assumed, sim-only commit). With that, robot-test vs the same
  with loose obstacles (600 comp, seeds 1-600 / 601-1200): half loose +0.7 +-0.9 / +2.5 +-2.0, all loose +2.5 +-1.6 /
  +4.6 +-2.4, ever lost 49% -> 44% / 47% -> 44%: no worse (it pushes some out of the way); no sign of pushing causing
  losses the no-progress checks miss. Sim says, not the robot: pushGripMu is assumed; the robot's M8 with a loose box
  (pushed ~260 mm, no false stop) agrees so far.
- [ ] **B14. Pushable obstacles** (3.4.3c "may be fixed", 3.4.5 moved obstacles stay where they end up). Run robot-test
  with `--set obstacleMovableFrac=0.5` and `=1.0` (both seed sets): does pushing an obstacle cause partial wheel slip that
  the no-progress checks (2n) miss, and does the robot lose position? Real-robot check: M8 with the box NOT taped down.

## C. Victims: not simulated (decided 2026-10-18)

Simulating victims would rest on guesses (camera range, angle, miss rate, false circles), none of them measured. The
code-level facts don't need a sim (a second victim on the same tile is ignored; each `c` with no letter costs up to 4 s).
Instead, measure on the robot in the cameras-on maze runs, from the Serial log: victim stops with no victim (the `c`
waits) per run, victims driven past without a stop, and seconds spent in victim stops per run. Those go to Baichen.

## D. Robustness and reporting

- [x] **D1 (2026-10-19, robot-test 9205f12, sim c139143, 300 comp fields each, vs default 161.2):**

  | Changed | Score | Home | Time lost |
  |---|---|---|---|
  | sensor noise x2 | +1.2 +-5.3 | 82 -> 83% | 10 -> 10% |
  | floor reflection x2 | +0.7 +-5.5 | 82 -> 77% | 10 -> 11% |
  | wheel spread 12% (worst case, double-counts motor A) | -7.7 +-6.4 | 82 -> 76% | 10 -> 13% |
  | gyro drift 0.5 deg/min | +2.1 +-5.0 | 82 -> 84% | 10 -> 9% |
  | walls 6 mm (wider path, like the practice maze) | +12.8 +-6.1 | 82 -> 88% | 10 -> 7% |
  | walls 30 mm (27 cm path: narrower than rule 3.3.3's 28 cm) | -15.9 +-6.1 | 82 -> 78% | 10 -> 11% |
  | all obstacles loose | +2.2 +-2.2 | 82 -> 82% | 10 -> 10% |

  Robust to noise, floor, gyro drift and loose obstacles (2n fixed the noise/floor sensitivity of 2026-10-18). Sensitive to
  uneven wheels (only the worst case tested) and to corridors narrower than the rules allow (not a competition case).
- [x] **D1 result (2026-10-19, sim, robot-test 09fa442+blue fix, 600 comp, seeds 1-600, each paired with the defaults).**
  Fine (within the noise, +-4): distance noise x2, floor reflection x2, turning drag x2 or /2, weak motor A x2, battery
  11.0 / 12.4 V, gyro drift 0.5 deg/min, gyro noise 1 deg, colour noise x2, sloppy placement, half the obstacles loose,
  pitch noise 1 deg (normal ramps).
  Hurts:
  - sensor offset spread x2: **-34.3 +-4.9**. By sensor, +-10 mm on one sensor:
    - right-front (2): -23 both ways; left-front (6) -10 mm: -20; right-back (3): -8 / -10;
    - left-back (5), front (1, 7) and back (4): within +-6.
    - parallel() squares up on the difference within a side pair, the right pair (2, 3) first. A mismatch inside a pair
      leaves the robot crooked after every squaring. The robot's right pair was within 1-4 mm (2026-10-17).
    - So: re-check the side pairs with bench test 11 every session and after a sensor is knocked or replaced. The pair
      difference matters, not the absolute offset.
  - obstacles 2x as common: -23.5; walls 30 mm thick: -16.6 (the rules say 20).
  - sensors all reading true (0 mm long): -9.1 (the code is tuned to the ~8-10 mm long readings); traction 0.9: -7.6;
    motor spread x2: -6.3.
  - **pitch noise 2 deg: home -15 +-4, time lost +8.** Ramp losses go from 11% to 38% of the lost runs: one reading under
    12 deg ends a climb early.
  - **ramps 13-15 deg (like the practice ramp): home -24 +-5, time lost +20**; with pitch noise 1 deg: home -46.
  - **ramps 10-12 deg: time lost +39.** They are under the 12 deg trigger, so the floor never changes.
  Robot logs: the tilt when a climb starts is 13-15 deg on the practice ramp (whole degrees, 1-3 over the trigger), and no
  climb ended early. The robot is fine on that ramp today, but with little margin. Ramp fix candidates: next item.
- [x] **Ramp detection under noise / shallow ramps (2026-10-19, sim, robot-test, PHYSICS-DEPENDENT).** Score / home per
  ramp condition, 600 comp fields, seeds 1-600:

  | Option | normal | 13-15 deg | 10-12 deg | 13-15 deg + 1 deg noise |
  |---|---|---|---|---|
  | A: flat reference averaged over 3 readings; the climb ends only after 3 readings in a row under 12; distance driven since the first of them credited back | +1.7 / +2 | +15.8 / +19 | -0.5 / -3 | +28.4 / +35 |
  | B: trigger 9 deg | -0.6 / 0 | +22.5 / +26 | **-11.7 / -21** | +40.1 / +48 |
  | C: A + B | +3.1 / +3 | +22.6 / +29 | +3.0 / -4 | +42.1 / +51 |
  | **D: like C, but where the ramp ended is still measured from the last drop under 12 deg** | +3.5 / +3 | +22.3 / +30 | -0.4 / -8 | +39.7 / +50 |

  - Why D: C moved the first centring after a ramp 15-30 mm further on, because the 9 deg crossing comes later than 12.
    That would undo 2l, tuned on the robot. D keeps it: 13-15 deg ramps up -40 -> -39 mm, down -19 -> -20.
  - D on seeds 601-1200: normal -1.3 +-3.6, 13-15 deg +17.5 / home +23, with noise +37.0 / +48, 10-12 deg -4.0 / home -7.
  - On 10-12 deg ramps the floor is now right (time lost 51% -> 20%), but home -7 / -8: the pitch hovers 1-3 deg over the
    9 deg trigger (the same thin margin 13-15 deg ramps have with 12), so climbs there sometimes count extra sections or
    time out.
  - D was pushed to robot-test (2p, 39acc1f), then **reworked on 2026-10-20 (fa2636b)**: the climb starts over 12 deg
    again and only the end changed (3 readings in a row under 12, distance since credited back).
    - The 9 deg start made 2 cm bumps start climbs: 100 flat fields with 2 cm bumps, 959 climbs started and 7 false ramp
      tiles, vs 59 and 1 at 12 deg (the same as before 2p).
    - The 3-reading flat reference was dropped: `pitch_heading()` returns 0 under 5 deg, and back-to-back reads get the
      same 100 Hz BNO055 sample.
    - The robot never showed the problem 2p guards against: 0 `short tilt` in ~70 real ramp crossings.
    - fa2636b vs robot-test before 2p (d390f9c), 600 comp, seeds 1-600 / 601-1200: normal ramps +0.8 / +1.9; 13-15 deg
      +14.4 / +16.5, home +16 / +20; 13-15 deg with 1 deg pitch noise +26.2 / +26.2, home +26 / +35; 10-12 deg +0.3 / +0.3.
      pio builds.
    - Robot test (ROBOT_TEST 2p): practice ramp up and down 3x, stops as in 2l; a 2 cm step and a speed bump: no
      `climbing`, nothing added to the map.
- [x] **D2 (2026-10-19, robot-test 9205f12, sim 264ff9c, 600 comp):** score 160.3 of 227.7; losses per run: blue revisits
  -27.9, unexplored -26.3, restarts -8.2 (mostly the captain loop, B5: now ~-2), not home -5.0. First wrong position (289
  of 600 runs): false obstacle alarm 21%, pushed obstacle 19%, real obstacle 18%, move 14%, ramp 12%, scraped wall 7%.
  Ended: home 499, no path 74, time 27.
- [ ] **D2.** `lostcause.py` and `scoregap.py` on robot-test after each kept change: what loses most points now.
- [x] **D3 (2026-10-19):** PORTFOLIO.md section 5: 19 Oct row (main 67.8 -> robot-test 161.2, +93.3 +-5.0), the +10 note
  marked resolved, and what the robot has confirmed vs what's simulator-only.
- [ ] **D3.** Update `docs/PORTFOLIO.md` section 5 (results table) with the newest main vs robot-test numbers.

## Not on this list (decided)

- Camera 4 s wait as a sim option, and victims in the sim: not wanted (user, 2026-10-18): measure on the robot instead (section C).
- A third, middle front distance sensor: no free mux port (user, 2026-10-18).
- Changing ROBOT_WIDTH_MM / the 80 mm one-wall gap: keep as is (CLAUDE.md rule).
