Doom956/Robocup-Junior-Theseus/camera_backups/right_2026-10-21/sample.jpg

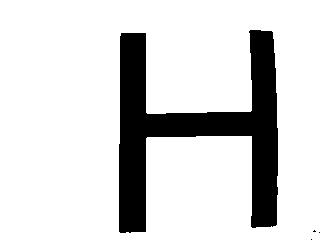
camera_backups/right_2026-10-21/sample.jpg
