Doom956/Robocup-Junior-Theseus/tools/sim/physics/fields/event_check.png

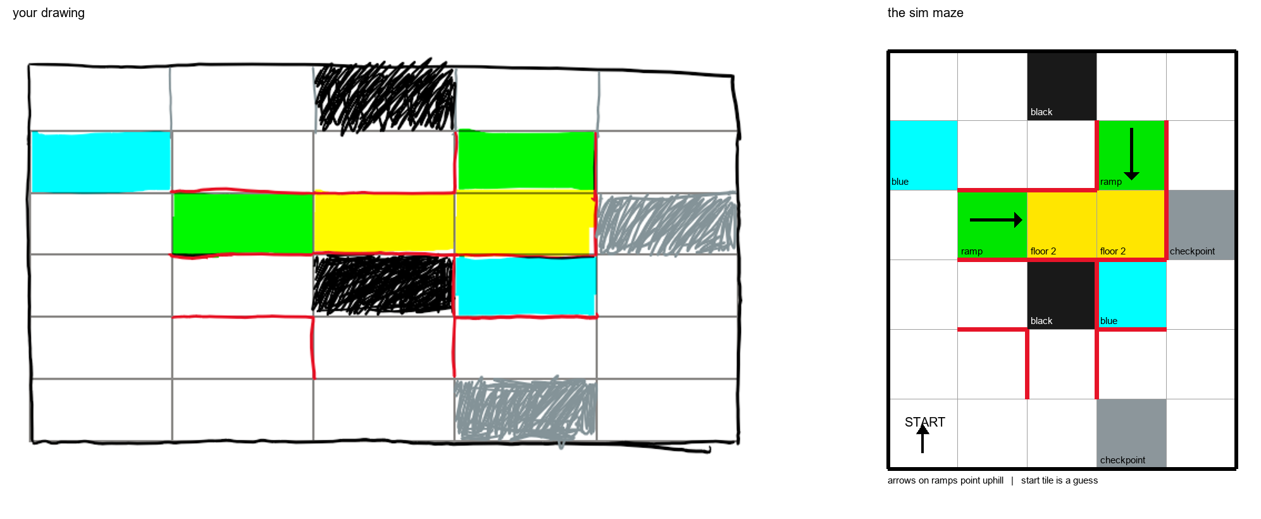
tools/sim/physics/fields/event_check.png
