Doom956/Robocup-Junior-Theseus/cad/display_stand/DisplayStand_flat_sides.stl

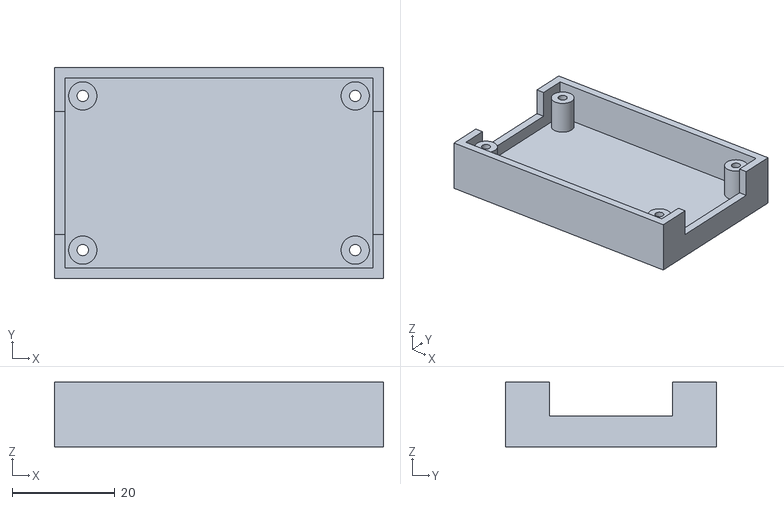
[picture p3: CAD file, 2026-10-21]
cad/display_stand/DisplayStand_flat_sides.stl
64.0 x 41.0 x 12.6
