Doom956/Robocup-Junior-Theseus/cad/rescue_kit/KitCase.stl

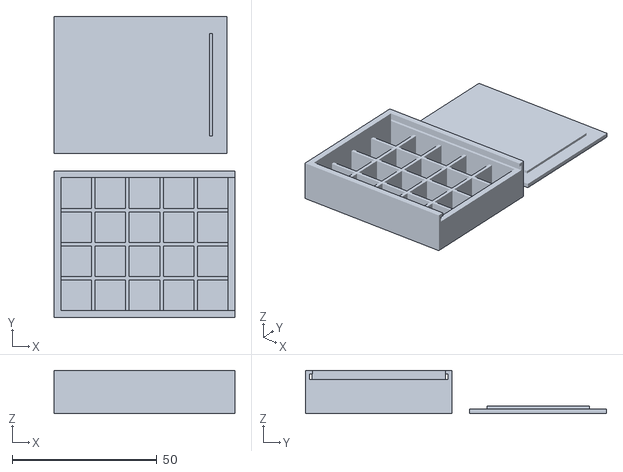
[picture p4: CAD file, 2026-10-21]
cad/rescue_kit/KitCase.stl
62.6 x 104.2 x 15.0
