Doom956/Robocup-Junior-Theseus/cad/rescue_kit/KitCase_lid.stl

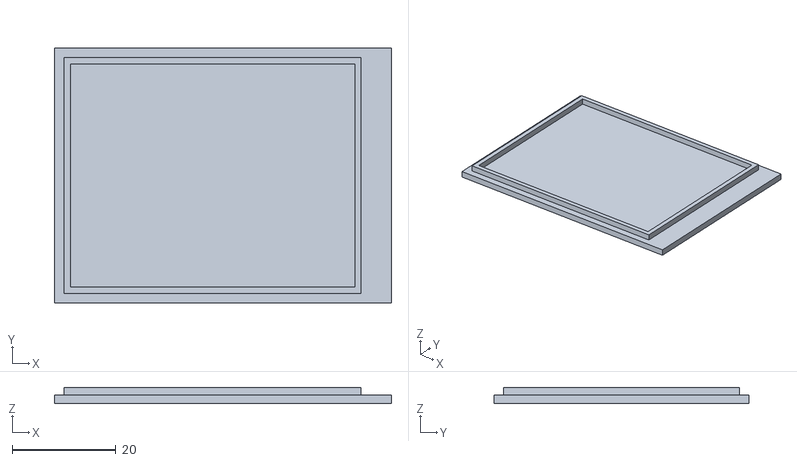
[picture p5: CAD file, 2026-10-21]
cad/rescue_kit/KitCase_lid.stl
65.0 x 49.2 x 3.10
