Doom956/Robocup-Junior-Theseus/cad/display_stand/DisplayStand_tilted.stl

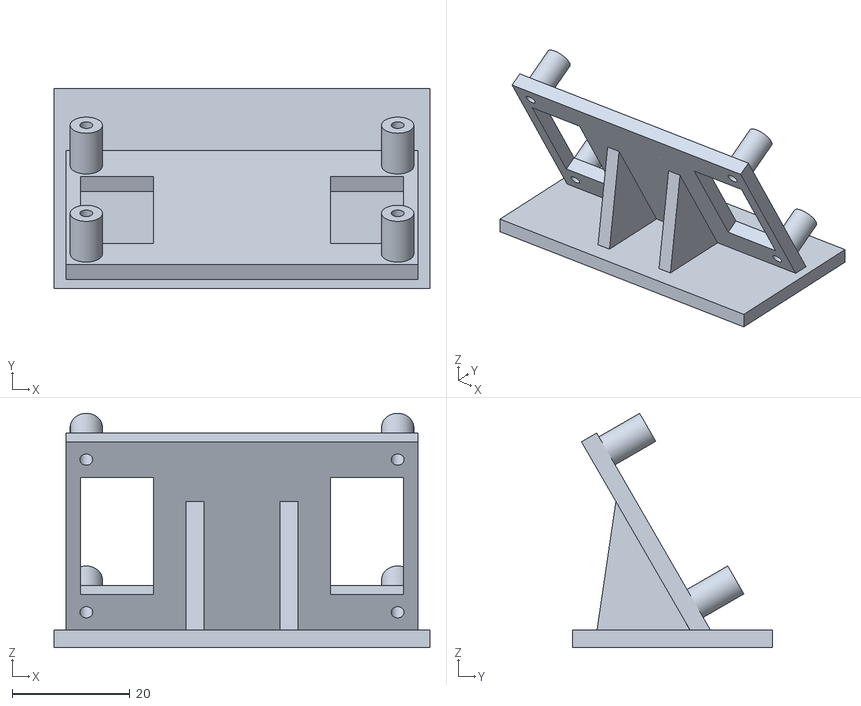
[picture p6: CAD file, 2026-10-20]
cad/display_stand/DisplayStand_tilted.stl
64.0 x 34.0 x 39.9
