Doom956/Robocup-Junior-Theseus/cad/rescue_kit/KitCase_tray.stl

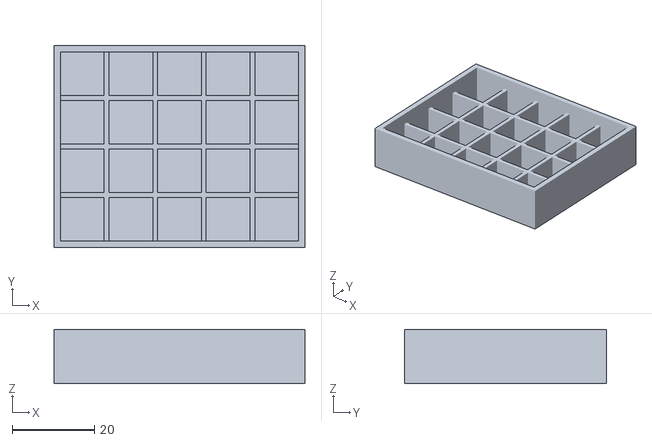
[picture p7: CAD file, 2026-10-21]
cad/rescue_kit/KitCase_tray.stl
61.0 x 49.2 x 13.2
