Doom956/Robocup-Junior-Theseus/cad/rescue_kit/RescueKit_10.0_plate10.stl

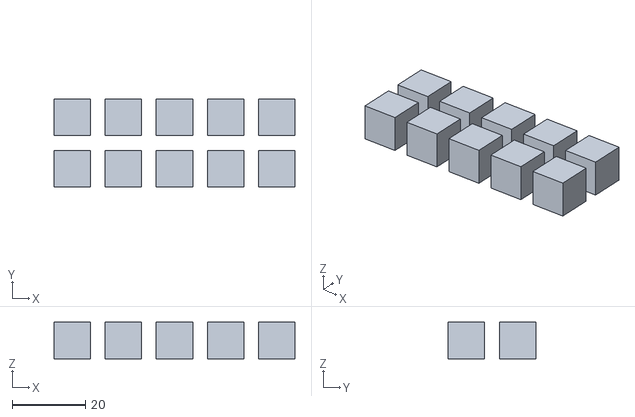
[picture p8: CAD file, 2026-10-21]
cad/rescue_kit/RescueKit_10.0_plate10.stl
66.0 x 24.0 x 10.0
