Doom956/Robocup-Junior-Theseus/cad/rescue_kit/RescueKit_10.0.stl

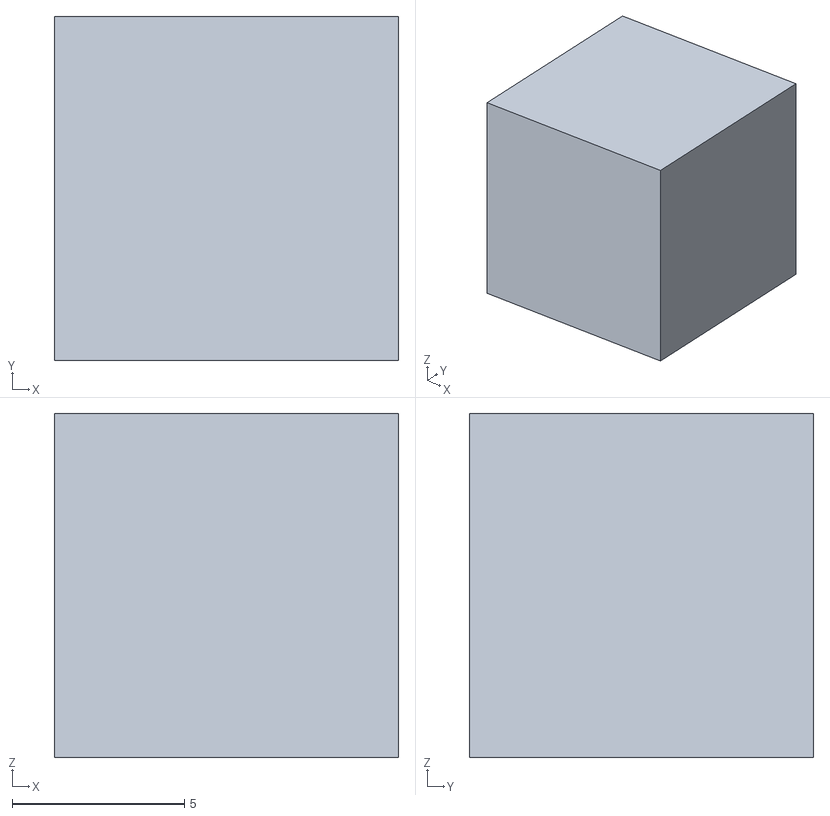
[picture p9: CAD file, 2026-10-21]
cad/rescue_kit/RescueKit_10.0.stl
10.0 x 10.0 x 10.0
