Doom956/Robocup-Junior-Theseus/cad/rescue_kit/RescueKit_10.2.stl

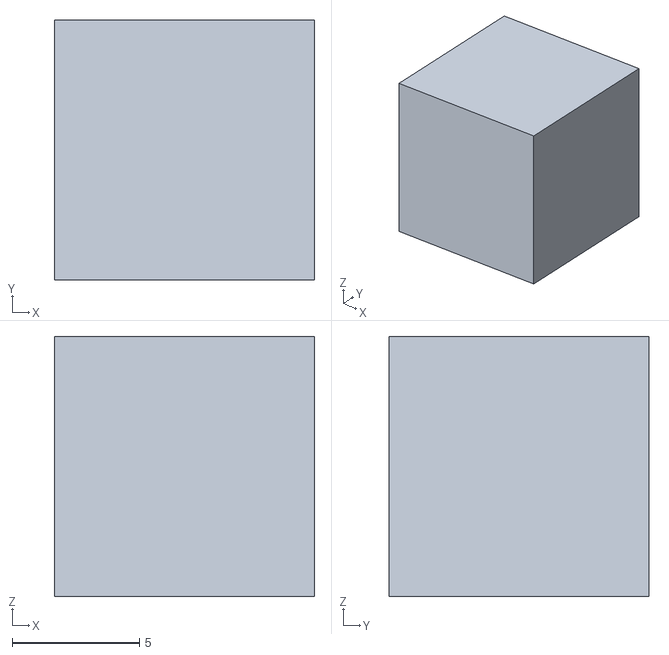
[picture p10: CAD file, 2026-10-21]
cad/rescue_kit/RescueKit_10.2.stl
10.2 x 10.2 x 10.2
