Doom956/Robocup-Junior-Theseus/cad/rescue_kit/RescueKit_10.2_plate10.stl

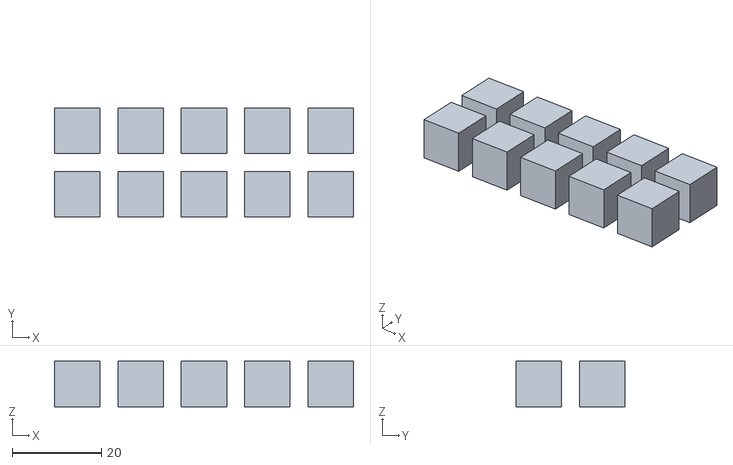
[picture p11: CAD file, 2026-10-21]
cad/rescue_kit/RescueKit_10.2_plate10.stl
67.0 x 24.4 x 10.2
