Doom956/Robocup-Junior-Theseus/cad/rescue_kit/RescueKit.stl

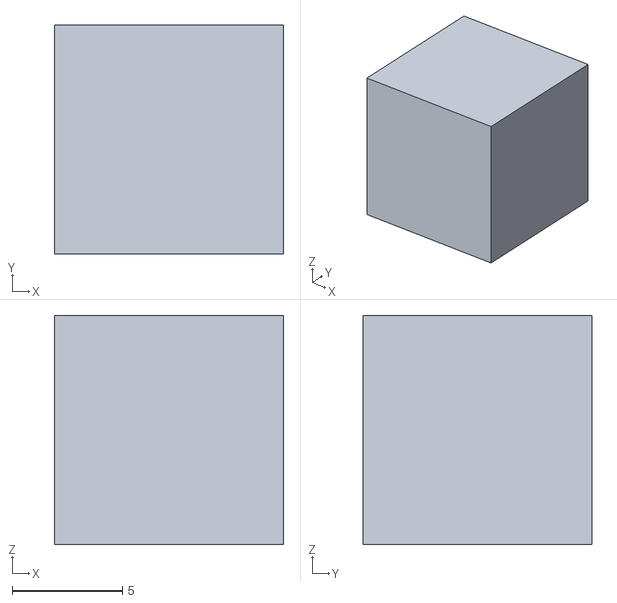
[picture p12: CAD file, 2026-10-21]
cad/rescue_kit/RescueKit.stl
10.4 x 10.4 x 10.4
