Doom956/Robocup-Junior-Theseus/cad/rescue_kit/RescueKit_plate10.stl

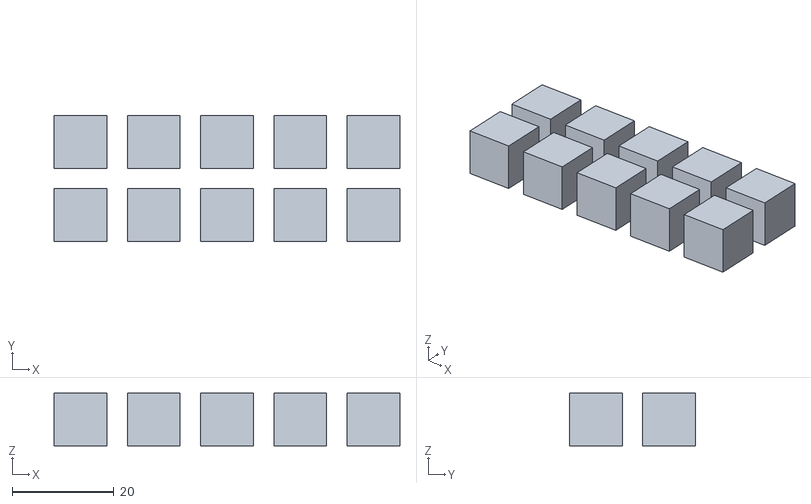
[picture p13: CAD file, 2026-10-21]
cad/rescue_kit/RescueKit_plate10.stl
68.0 x 24.8 x 10.4
