Doom956/Robocup-Junior-Theseus/(list of files, cad)

Other CAD files:
cad/display_stand/DisplayStand_flat.stl
