Doom956/Robocup-Junior-Theseus/tools/sim/physics/physics.cpp

// Physics simulator: runs the robot's real firmware (Main/*.cpp, unchanged) against a
// simulated robot on a random RCJ field.
//
// The Arduino/hardware libraries are replaced (tools/sim/physics/hw) by versions backed by:
//   - a simulated clock: millis/micros/delay, and every hardware call costs roughly its real time
//   - 4 DC motors (dead band, lag, per-motor gain), skid-steer driving, walls that block the robot
//   - encoders counting real wheel rotation (wheel slip shows up as encoder error)
//   - 7 VL53L0X beams cast from the CAD positions (tools/sim/cad/robot_geometry.json)
//   - BNO055 heading (with drift and noise) and pitch from the ramp under the wheels
//   - TCS34725 colour of the tile under its CAD position
//   - a referee: lack-of-progress restart (pause switch) on black or when stuck
//
// Usage: physics.exe --scenario NAME --seed S [--ideal] [--verbose] [--trace FILE] [--live [--live-speed X]]
// Prints one JSON line with the result. --trace writes a recording of the run (one JSON object per
// line) that viewer.html plays back. --live writes the same recording to stdout while the run happens,
// paced to the wall clock, and takes commands on stdin (pause, resume, speed X, lop, nudge, stop).

#include "Globals.h"
#include "world.h"
#include <chrono>
#include <cstdio>
#include <fstream>
#include <iostream>
#include <map>
#include <set>
#include <random>
#include <sstream>
#include <string>

// =====================================================================================
// Assumptions (tune these to the real robot; see README)
// =====================================================================================
struct Params {
  // Motors: Pololu 195.3125:1 Metal Gearmotor 20Dx44L mm 12V (#3493) on a Carobot V3 shield
  // (TB6612FNG + PCA9685, like the Adafruit Motor Shield V2), powered by a 3S LiPo.
  double batteryVoltage = 11.76;  // 3S LiPo, measured before the bench tests (2026-10-06)
  // FITTED 2026-10-18 to the robot's move tests (logs/2026-10-16, 2026-10-17): one tile (fwd(300) from rest) takes
  // 1.08-1.13 s and 27-29 loops of fwd(); with the datasheet's 72 RPM (Pololu #3493) the sim took 2.7 s, so the motors
  // on the robot are a faster gearing than that part. 170 gives 1.16 s and 27-28 loops. Stall torque and no-load current
  // are still the #3493 datasheet values (unknown for the real motor).
  double noLoadRpmAt12V = 170;
  // FITTED 2026-10-18: on the robot's 13-15 deg practice ramp, climbing (PWM 180) takes as long as coming down (PWM 120):
  // 36-43 fwd() climb loops either way (logs/2026-10-17 partB7/B8). That needs gravity to cost ~0.12 of stall torque, so
  // ~4 kg.cm: 4.2 gives 23.4 / 22.5 loops up / down at 14 deg (10, the #3493 datasheet, gave 21 / 26). Fits the faster
  // gearing (10 x 72/170). Real climbs take more loops than the sim's (~38 vs ~23): not explained yet.
  double stallKgcmAt12V = 4.2;
  double frictionFracAt12V = 0.05; // no-load current / stall current = 80 mA / 1.6 A (datasheet)
  double stictionFactor = 1.3;    // extra friction to start from standstill
  // Motor A (left front) only: extra friction at low power, fraction of stall torque, fading to none at
  // PWM 128. FITTED to bench mode on the robot (2026-10-06, 11.76 V): test 4 needed PWM 49-51 before wheel A
  // counted forward, and even then A counted 42-56 against 250-340 for B and D (it feels free by hand, so motor
  // or driver channel); at PWM 150 (test 3) A counted like the others (1010 vs 984-1105). 0.16 gives --selftest
  // tests 2/3/4 = 30 / 93 deg / 51 (robot 25-30 / 92-97 deg / 49-51); 0 = motor A like the others.
  double motorAExtraFriction = 0.16;
  double robotMassKg = 1.955;     // WEIGHED 2026-10-16 (the parts list estimate was 1.15, README "Robot mass")
  double driverOhms = 0.5;        // TB6612FNG output ON resistance, upper + lower, typ (Toshiba datasheet); motor 12 V / 1.6 A = 7.5 ohm
  // wheelMu and skidFactor FITTED to the robot's bench mode (Main/bench.cpp, 3 runs on 2026-10-06): lowest
  // turnright() PWM that turns it 5 deg in 1 s 25/30/25 (sim 25), turnright(150) for 1 s 97/92/95 deg (sim 95).
  // (Before: 0.8 and 1.3, assumed, gave 45 and 70.) wheelMu is the sideways drag when turning on the spot (the grip for
  // pushing a loose obstacle is pushGripMu since 2026-10-18). Refitted to 0.17 for the weighed 1.955 kg (was 0.2
  // with the 1.15 kg estimate): bench tests 2/3/4 in the sim 30 / 91.8 deg / 51.
  // Refitted 2026-10-18 to 0.071 with the 4.2 kg.cm stall torque (same drag as a fraction of it): bench tests 2/3/4 in the
  // sim 30 / 97.6 deg / 51, move test M1 90 deg in 1.1 s.
  double wheelMu = 0.071;
  double motorTau = 0.05;         // motor + gearbox speed time constant, s
  // per-motor speed difference (fraction), assumed. Move test M7 (2026-10-18, wheels in the air): A/B/D 118/139/150 RPM at
  // fw(255), 67/66/89 at fw(150); most of that spread is motor A, which motorAExtraFriction already models, B vs D ~4-8%
  // at full power: 0.05 (motor A's weakness stays in motorAExtraFriction). robot-test: 0.05 vs 0.03 -2.5 +-3.6; 0.12 (which
  // double-counted motor A) -15.3 +-6.3.
  double motorGainSigma = 0.05;
  double trackWidth = 156;        // left-right wheel spacing, mm (CAD)
  // skid steering turns slower than the ideal track predicts. FITTED: bench test 3 (turnright(150) 1 s: 92-97 deg) gives
  // 2.5 with the 170 RPM motor (97.5 deg; move test M1: 90 deg in 1.1 s, robot 0.77-1.01 s). Was 1.1 with 72 RPM.
  double skidFactor = 2.5;
  // wheel grip (ground speed / wheel speed). tractionMean FITTED 2026-10-18: one-tile moves on the robot measured 297-326 mm
  // by the back sensor (median 307, encoders ~296-300), so no slip on flat floor; 1.0 gives 302 in the sim (0.97, assumed,
  // gave 295). Sigma and tau assumed.
  double tractionMean = 1.0, tractionSigma = 0.02, tractionTau = 0.5;
  double wallNudgeMm = 0.3;       // how far a wall can shove a turning robot sideways, mm per ms (0 = it jams)
  double wheelDiameter = 80;
  double encoderCountsPerRev = 5 * 195.3125; // 20 CPR encoder, code counts rising edges of one channel = 5 per motor turn
  // Gyro: "magnetic" = the BNO055 reports heading from magnetic north (team notes: "the heading is
  // always global") instead of from the start direction. Maze-to-north angle, deg; -1 = random per run.
  // -1 = do what the firmware asks for: bno.begin() defaults to NDOF, which the BNO055 datasheet (3.3.3.5)
  // defines as absolute orientation (heading from magnetic north); IMUPLUS is relative to the start.
  // In NDOF the heading only becomes magnetic once the magnetometer is calibrated, which needs the robot
  // turned through many orientations. The real robot explored like a relative heading, so by default the
  // calibration never completes during a run (gyroMagneticAfterS = 1e9). Set it to 0 (calibrated at the
  // start) or e.g. 60 to see what happens if the heading switches to magnetic.
  double gyroMagnetic = -1, gyroMagneticOffsetDeg = -1, gyroMagneticAfterS = 1e9; // switch to magnetic after this many s of the run
  double magErrorDeg = 2.5;       // BNO055 datasheet: magnetometer heading accuracy +-2.5 deg (fully calibrated, ideal)
  double tofMinReliableMm = 30;   // team notes: "can't handle below 30mm"
  // VL53L0X datasheet table 12: standard deviation 4 % at 33 ms (white target, incl. part-to-part); table 14:
  // offset drift < 3 %. Here ~3 % reading-to-reading + a fixed per-sensor offset.
  double tofNoiseMm = 1.5, tofNoisePct = 0.03, tofOffsetSigma = 5, tofMaxRange = 1200, tofConeDeg = 25, tofPeriodUs = 33000;
  // Bench test 1 (3 runs, robot centred by hand): opposite sensors added up read 21/19/20 mm (left + right) and
  // 14/8/17 mm (front + back) more than the CAD says, whatever the centring: about +8 mm per sensor on average.
  // (Measured on the team's practice tile; walls thinner than the 20 mm used here would explain part of it.)
  double tofOffsetMeanMm = 8;
  // The left-back sensor (code sensor 5) was replaced on 2026-10-17; the new one reads 26-30 mm more than left-front
  // between two walls (MEASURED, robot-test sets SENSOR_OFFSET_MM[5] = 30 for it). Added to that sensor's offset so the
  // firmware's correction matches; 0 = the original sensor.
  double tofLeftBackExtraMm = 30;
  // Analysis only: an extra reading offset for one sensor (code numbers 1-7: front-right, right-front, right-back, back,
  // left-back, left-front, front-left), on top of the ones above. Shows which sensors' calibration matters. 0 by default.
  double tofExtraMm[8] = {0, 0, 0, 0, 0, 0, 0, 0};
  // How strongly the floor / a ramp's slope returns light into the cone (0 = sensors only see walls, as before). FITTED
  // 2026-10-18 to move test M0 on open floor: robot back 266-373 mm, front 685-702, sides 669-763; the sim with 3 reads
  // back ~340, front ~770, sides ~750 (selftest "M0 open floor"). The robot's back sensor sometimes reads 8190 instead.
  double tofFloorGain = 3.0;
  // Bench test 6: 0.00 deg in 2 min standing still (BNO055 steps are 1/16 deg), so under 0.03 deg/min at rest.
  // Drift while moving isn't measured. (Before: 0.5, assumed.)
  double gyroNoiseDeg = 0.2, gyroDriftSigmaDegPerMin = 0.03, pitchNoiseDeg = 0.5;
  double colourNoise = 0.04;
  double placeSigmaMm = 8, placeSigmaDeg = 2; // how accurately a person places the robot
  double rampMinDeg = 15, rampMaxDeg = 25;
  // RCJ 2026 field (3.1, 3.3, 3.4): walls ~2 cm thick (280 mm path), obstacles and speed bumps
  // tile pitch (RCJ 3.1.2: 300). The practice maze (measured 2026-10-19): 320 mm tiles, 20 mm walls on the joints, so a
  // ~300 mm path (295 measured). The robot still drives 300 mm per tile (its code doesn't know).
  double tileMm = 300;
  double wallThicknessMm = 20, obstacleRate = 0.03, bumpRate = 0.05, bumpHeightMm = 10;
  double obstacleRMinMm = 25, obstacleRMaxMm = 45; // obstacle radius: 5-9 cm across, assumed (rules 3.4.3: any shape, large heavy items, >= 15 cm tall)
  // RCJ 2026 3.4.3: obstacles are "large, heavy items" and "may be fixed to the floor"; 3.4.5: one that is
  // moved stays where it ends up. ASSUMED (the rules give no mass or material): this share of the obstacles
  // is loose, each with a mass between obstacleMassMinKg and obstacleMassMaxKg and floor friction
  // obstacleMu; the rest are fixed. 0 = all fixed (the default, as before).
  double obstacleMovableFrac = 0, obstacleMassMinKg = 0.5, obstacleMassMaxKg = 2.0, obstacleMu = 0.4;
  // the wheels' grip on the floor when pushing a loose obstacle, assumed (0.8, the value wheelMu had before it was fitted
  // to the turning tests; since 2026-10-18 wheelMu is only the sideways drag when turning, 0.071, far too low for this).
  // Robot 2026-10-18 (M8, box not taped): pushed a loose box ~260 mm of a 300 mm move.
  double pushGripMu = 0.8;
  double runTimeS = 480, stuckTimeoutS = 60, lopPauseS = 3;
  // The run starts as on the robot: the pause switch is on at power-on and flipped to run after this many seconds
  // (PAUSE state: white reference, run clock, heading zero). Before 2026-10-19 the sim started without it, so the code's
  // first PAUSE was a referee restart, which restarted its run clock mid-run (since 68e0c47) and took the white reference
  // on a checkpoint. 0 = the old start.
  double startPauseS = 0.5;
  double lopAnyDirection = 1; // put back after a lack of progress facing a random direction (rules 5.5.2); 0 = start direction
  // The captain gives up on a stuck robot: if it stops away from home again ("no path found" / home on the wrong tile)
  // without having reached any new tile since the restart its last stop caused, the run ends there (that restart isn't
  // called). Assumed (team behaviour); 0 = the captain restarts it every time (before 2026-10-19: ~17 restarts per such run).
  double captainGivesUp = 1;
  // Extra resistance on a slope, same up and down, as a fraction of stall torque per unit sin(pitch). The robot crosses
  // the practice ramp (13-15 deg, one 320 mm tile) in ~1.75 s both ways (logs/2026-10-19, SIM_WORKLIST A4); without it the
  // sim took 1.22 s. Cause unknown (steering between the ramp walls, gyro pitch lag, rolling resistance): fitted, not modelled.
  double slopeDrag = 0;
  // Analysis only, NOT the real robot: 1 = put the code's map position right each time it starts
  // reading a tile (same floor only). Shows how much never getting lost would be worth.
  double oracleTile = 0;
  // Analysis only: 1 = put the robot itself in the middle of its tile (heading untouched) each time
  // the code starts reading a tile. Shows how much being off-centre costs.
  double oracleCentre = 0;
  // Rehearsals of the robot tests in TEST_PRIORITY.md (2026-10-19, SIM_WORKLIST T1): --scenario t2 / t3 / t6 / t7 are small
  // fixed fields (testField()), the others act on any field. All off by default.
  double testPos = 0;      // t2 / t6: obstacle at the near end (0), middle (1) or far end (2) of its tile; t7: in the first half of the blue tile (0) or of the tile after it (1)
  double testOffsetMm = 0, testTurnDeg = 0; // t3: start this far toward the open side, turned this much toward it
  double testGyroZero = 0; // 1 = the gyro reads 0 at the heading the robot was placed at (switched on where it stands, IMUPLUS)
  // test 4: once carryAfterTiles tiles are visited, at the next tile read, move the robot back one tile with the same
  // heading: 1 = pause 3 s first (as TEST_PRIORITY says), 2 = at once, no pause, 3 = hold it still through its next move
  double carryTest = 0, carryAfterTiles = 4;
  double carryOnRevisit = 0; // 1 = only at a tile the code has visited before (relocalize compares with what it recorded)
  double homeCarry = 0;    // test 5: when it sets off home, pause 3 s and put it on a tile next to the start, facing the start
  double testNoCheckpoints = 0; // 1 = silver tiles become white (after a pause the code goes back to its last checkpoint)
  double testWide = 0;     // t6: the obstacle's tile is open on the side away from the obstacle (room to drive around it)
  // 1 = checkpoint tiles are grey, not reflective silver (the 2026-10-22 event field): they read like the team's grey
  // tile (bench test 9, 2026-10-06), which read_color() takes for a plain tile. The referee
  // still restarts the robot on the last one it visited.
  double greyCheckpoints = 0;
} P;

// --set name=value overrides any of the numbers above
static std::map<std::string, double *> paramTable() {
  return {
    {"batteryVoltage", &P.batteryVoltage}, {"noLoadRpmAt12V", &P.noLoadRpmAt12V}, {"stallKgcmAt12V", &P.stallKgcmAt12V},
    {"frictionFracAt12V", &P.frictionFracAt12V}, {"stictionFactor", &P.stictionFactor}, {"motorAExtraFriction", &P.motorAExtraFriction}, {"robotMassKg", &P.robotMassKg},
    {"wheelMu", &P.wheelMu}, {"motorTau", &P.motorTau},
    {"motorGainSigma", &P.motorGainSigma}, {"trackWidth", &P.trackWidth}, {"skidFactor", &P.skidFactor},
    {"tractionMean", &P.tractionMean}, {"tractionSigma", &P.tractionSigma},
    {"gyroMagnetic", &P.gyroMagnetic}, {"magErrorDeg", &P.magErrorDeg}, {"driverOhms", &P.driverOhms}, {"gyroMagneticOffsetDeg", &P.gyroMagneticOffsetDeg}, {"gyroMagneticAfterS", &P.gyroMagneticAfterS},
    {"tofMinReliableMm", &P.tofMinReliableMm},
    {"wallNudgeMm", &P.wallNudgeMm}, {"tofNoiseMm", &P.tofNoiseMm}, {"tofNoisePct", &P.tofNoisePct},
    {"tofOffsetSigma", &P.tofOffsetSigma}, {"tofOffsetMeanMm", &P.tofOffsetMeanMm}, {"tofLeftBackExtraMm", &P.tofLeftBackExtraMm},
    {"tofExtraMm1", &P.tofExtraMm[1]}, {"tofExtraMm2", &P.tofExtraMm[2]}, {"tofExtraMm3", &P.tofExtraMm[3]}, {"tofExtraMm4", &P.tofExtraMm[4]},
    {"tofExtraMm5", &P.tofExtraMm[5]}, {"tofExtraMm6", &P.tofExtraMm[6]}, {"tofExtraMm7", &P.tofExtraMm[7]}, {"tofFloorGain", &P.tofFloorGain}, {"tofMaxRange", &P.tofMaxRange}, {"tofConeDeg", &P.tofConeDeg},
    {"gyroNoiseDeg", &P.gyroNoiseDeg}, {"gyroDriftSigmaDegPerMin", &P.gyroDriftSigmaDegPerMin},
    {"pitchNoiseDeg", &P.pitchNoiseDeg}, {"colourNoise", &P.colourNoise}, {"placeSigmaMm", &P.placeSigmaMm},
    {"placeSigmaDeg", &P.placeSigmaDeg}, {"rampMinDeg", &P.rampMinDeg}, {"rampMaxDeg", &P.rampMaxDeg},
    {"wallThicknessMm", &P.wallThicknessMm}, {"tileMm", &P.tileMm}, {"obstacleRate", &P.obstacleRate},
    {"obstacleMovableFrac", &P.obstacleMovableFrac}, {"obstacleMassMinKg", &P.obstacleMassMinKg}, {"obstacleMassMaxKg", &P.obstacleMassMaxKg}, {"obstacleMu", &P.obstacleMu}, {"pushGripMu", &P.pushGripMu}, {"bumpRate", &P.bumpRate}, {"obstacleRMinMm", &P.obstacleRMinMm}, {"obstacleRMaxMm", &P.obstacleRMaxMm}, {"bumpHeightMm", &P.bumpHeightMm},
    {"runTimeS", &P.runTimeS}, {"lopAnyDirection", &P.lopAnyDirection}, {"captainGivesUp", &P.captainGivesUp}, {"slopeDrag", &P.slopeDrag}, {"startPauseS", &P.startPauseS}, {"stuckTimeoutS", &P.stuckTimeoutS}, {"oracleTile", &P.oracleTile}, {"oracleCentre", &P.oracleCentre},
    {"testPos", &P.testPos}, {"testOffsetMm", &P.testOffsetMm}, {"testTurnDeg", &P.testTurnDeg}, {"testGyroZero", &P.testGyroZero},
    {"carryTest", &P.carryTest}, {"carryAfterTiles", &P.carryAfterTiles}, {"homeCarry", &P.homeCarry},
    {"carryOnRevisit", &P.carryOnRevisit}, {"testNoCheckpoints", &P.testNoCheckpoints}, {"testWide", &P.testWide},
    {"greyCheckpoints", &P.greyCheckpoints}};
}

static bool setParam(const std::string &kv) {
  size_t eq = kv.find('=');
  if (eq == std::string::npos) return false;
  std::string k = kv.substr(0, eq);
  double v = std::atof(kv.c_str() + eq + 1);
  std::map<std::string, double *> m = paramTable();
  auto it = m.find(k);
  if (it == m.end()) return false;
  *it->second = v;
  return true;
}

static void makeIdeal() { // no noise, no drift, identical motors, perfect grip
  P.motorGainSigma = 0; P.motorAExtraFriction = 0; P.tractionMean = 1; P.tractionSigma = 0;
  P.tofNoiseMm = 0; P.tofNoisePct = 0; P.tofOffsetSigma = 0; P.tofOffsetMeanMm = 0; P.magErrorDeg = 0;
  P.gyroNoiseDeg = 0; P.gyroDriftSigmaDegPerMin = 0; P.pitchNoiseDeg = 0; P.colourNoise = 0;
  P.placeSigmaMm = 0; P.placeSigmaDeg = 0;
}

// =====================================================================================
// Simulation state
// =====================================================================================
struct SimEnd { std::string reason; };
bool simSerialEcho = false;
SimSerial Serial, Serial3, Serial4;
TwoWire Wire;

static std::mt19937 rng;
static double gauss(double s) { return s > 0 ? std::normal_distribution<double>(0, s)(rng) : 0; }
static field::World W;
static double tUs = 0;                 // simulated time
static bool runStarted = false;
static double runStartUs = 0;

// robot pose: x east, y north (mm, field corner = 0,0); heading clockwise from north (deg)
static double rx, ry, rhead, rpitch = 0;
static double mapStartHead = 0; // --scenario <file>.txt: the start tile's facing (0 north, 90 east, ...)
struct Motor { int dir = RELEASE; int pwm = 0; double speed = 0, gain = 1, traction = 1, encFrac = 0; };
static Motor mot[5];                   // 1 = A (left), 2 = B (right), 3 = C (left), 4 = D (right, mounted reversed)
static double gyroBiasDegPerUs = 0;

// sensor geometry (robot frame: forward, left), by code sensor number 1..7
struct TofSensor { double fwd = 0, left = 0, height = 106; int facing = 0; double offset = 0; long lastSample = -1; double phaseUs = 0; bool ok = false; };
static TofSensor tof[8];
static int portToSensor[8] = {2, 1, 7, 6, 4, 5, 3, 0}; // inverse of measure()'s portMap; port 7 = colour sensor
static int muxPort = 0;
static double colourFwd = 92.8, colourLeft = 0, colourHeight = 23.7;
static double bodyFront = 99.1, bodyBack = 103.5, bodyHalfWidth = 91.5;
static std::vector<double> outF, outL;   // robot outline seen from above (forward, left), convex, from the CAD
static double outlineRadius = 140;      // furthest outline point from the centre
static double axleOffset = 57.8;

// referee / metrics
static bool switchHigh = false;
static double pauseUntilUs = 0;
static int lastTileX = -1, lastTileY = -1, cpX = 0, cpY = 0;
static double lastProgressUs = 0;
static int lops = 0, rampCrossings = 0, lastLevel = -1;
static std::vector<bool> visited;
// RCJ 2026 scoring (navigation part): per-tile records of what the robot visited
static std::vector<int> blueVisits, blueGood;   // visits of each blue tile; visits where it stopped 5 s
static std::vector<bool> cpVisited;             // checkpoints visited
static std::set<int> rampsDone;                 // ramps navigated (by ramp row), 10 points each once
static std::set<int> bumpsDone;                 // speed-bump tiles crossed, 5 points each once
static int curTile = -1, lastRampRow = -1;                        // tile the robot is "visiting" (more than half of it inside)
static double stillUs = 0, lastStillX = 0, lastStillY = 0; // how long it has stood still on the current tile
static bool blueStopped = false;                // stood still 5 s on the current blue tile
static double contactUs = 0;
static bool inContact = false;
static int syncSamples = 0, lostSamples = 0;
static std::string lopReasons;
// A robot that stopped for good away from home ("no path found", or "back to start" on the wrong
// tile): its captain calls lack of progress, which puts it back on the last checkpoint. If the code
// doesn't respond (it ignores the pause switch), the run ends where it stopped, and that restart isn't
// counted: a captain who saw it wouldn't bother.
static double stopClaimUs = -1, stopLopUs = -1;
static int visitedCount = 0, stopLopVisited = -1; // tiles visited so far; and when the last stop-caused restart came
static std::string stopWhy, stopEnd, stopReasonsBefore;
static int stopLopsBefore = 0;
static double stopX = 0, stopY = 0, stopHead = 0;
static bool movedSinceStopLop = false;

static void stopClaim(const char *why, const char *end) {
  if (stopClaimUs >= 0) return; // already handling this stop
  if (P.captainGivesUp > 0 && stopLopVisited >= 0 && visitedCount == stopLopVisited) throw SimEnd{end}; // same stop again: run over
  stopClaimUs = tUs; stopWhy = why; stopEnd = end;
}
static std::ofstream traceFile;
static std::ostream *traceOut = nullptr; // the recording: traceFile (--trace) or stdout (--live)
static bool live = false;
static double nextTraceUs = 0;
static int tofLast[8] = {0};            // last reading of each distance sensor, for the trace
static double gyroLast = 0;
static std::string lcdText, lcdTraced, serialLine;
static std::vector<uint32_t> mapTraced; // code's map as last written to the trace

static std::string jsonEsc(const std::string &in) {
  std::string o;
  for (char ch : in) {
    if (ch == '"' || ch == '\\') { o += '\\'; o += ch; }
    else if ((unsigned char)ch < 0x20) o += ' ';
    else o += ch;
  }
  return o;
}

static double rad(double d) { return d * M_PI / 180.0; }
static double wrap360(double a) { a = std::fmod(a, 360.0); return a < 0 ? a + 360 : a; }

// =====================================================================================
// Geometry
// =====================================================================================
// sin and cos of an angle in degrees, remembered for the last two angles asked for. The same
// headings come up again and again (every footprint point, every collision test), and the maths
// library's sin/cos were almost half the run time. Same values, so results don't change.
struct SinCos {
  double deg[2] = {1e300, 1e300}, s[2] = {0, 0}, c[2] = {1, 1};
  int next = 0;
  void at(double d, double &sv, double &cv) {
    for (int i = 0; i < 2; i++) if (deg[i] == d) { sv = s[i]; cv = c[i]; return; }
    double h = rad(d);
    deg[next] = d; s[next] = sv = std::sin(h); c[next] = cv = std::cos(h);
    next ^= 1;
  }
};
static SinCos headSC, collideSC, pitchSC;

static void robotToWorld(double fwd, double left, double &wx, double &wy) {
  double sh, ch;
  headSC.at(rhead, sh, ch);
  wx = rx + fwd * sh - left * ch;
  wy = ry + fwd * ch + left * sh;
}

// Walls are P.wallThicknessMm thick, centred on the tile edges, and reach half that past their ends
// (the posts holding them count as wall, RCJ 3.1.4), so two facing walls leave a 280 mm path
// (RCJ 3.3.3). Obstacles are upright cylinders (RCJ 3.4.3).
static std::vector<std::vector<int>> obstaclesInCell; // obstacle indices overlapping each tile
static std::vector<double> obstacleMass;              // per obstacle: kg if loose, 0 if fixed (empty = all fixed)
static double pushedMm = 0;                           // how far the robot pushed obstacles in this run
static void indexObstacles() {
  obstaclesInCell.assign(W.W * W.H, {});
  for (size_t k = 0; k < W.obstacles.size(); k++) {
    const field::Obstacle &o = W.obstacles[k];
    for (int y = (int)std::floor((o.y - o.r) / field::TILE); y <= (int)std::floor((o.y + o.r) / field::TILE); y++)
      for (int x = (int)std::floor((o.x - o.r) / field::TILE); x <= (int)std::floor((o.x + o.r) / field::TILE); x++)
        if (W.in(x, y)) obstaclesInCell[W.id(x, y)].push_back((int)k);
  }
}
// box of the wall on a tile edge: horizontal edge from grid point (gx, gy) to (gx + 1, gy), or vertical to (gx, gy + 1)
static void edgeBox(int gx, int gy, bool horizontal, double b[4]) {
  const double S = field::TILE, h = P.wallThicknessMm / 2;
  if (horizontal) { b[0] = gx * S - h; b[1] = gy * S - h; b[2] = (gx + 1) * S + h; b[3] = gy * S + h; }
  else            { b[0] = gx * S - h; b[1] = gy * S - h; b[2] = gx * S + h; b[3] = (gy + 1) * S + h; }
}
// every wall that can reach into tile (cx, cy): the walls touching one of its four corners
template <class Fn> static void wallsNearCell(int cx, int cy, Fn f) {
  double b[4];
  for (int gy = cy; gy <= cy + 1; gy++)
    for (int gx = cx; gx <= cx + 1; gx++) {
      for (int a = gx - 1; a <= gx; a++) if (W.hasWall(a, gy, 2)) { edgeBox(a, gy, true, b); f(b); }  // along y = gy
      for (int a = gy - 1; a <= gy; a++) if (W.hasWall(gx, a, 3)) { edgeBox(gx, a, false, b); f(b); } // along x = gx
    }
}
static bool rayBox(double ox, double oy, double dx, double dy, const double *b, double &t, double &facing) {
  double tmin = -1e18, tmax = 1e18; int axis = 0;
  if (std::fabs(dx) < 1e-12) { if (ox < b[0] || ox > b[2]) return false; }
  else { double p = (b[0] - ox) / dx, q = (b[2] - ox) / dx; if (p > q) std::swap(p, q); if (p > tmin) { tmin = p; axis = 0; } tmax = std::min(tmax, q); }
  if (std::fabs(dy) < 1e-12) { if (oy < b[1] || oy > b[3]) return false; }
  else { double p = (b[1] - oy) / dy, q = (b[3] - oy) / dy; if (p > q) std::swap(p, q); if (p > tmin) { tmin = p; axis = 1; } tmax = std::min(tmax, q); }
  if (tmax < std::max(tmin, 0.0)) return false;
  if (tmin < 0) { t = 0; facing = 1; return true; } // starts inside the wall
  t = tmin; facing = axis == 0 ? std::fabs(dx) : std::fabs(dy);
  return true;
}
static bool rayCircle(double ox, double oy, double dx, double dy, const field::Obstacle &o, double &t, double &facing) {
  double px = ox - o.x, py = oy - o.y, b = px * dx + py * dy, c = px * px + py * py - o.r * o.r, disc = b * b - c;
  if (disc < 0) return false;
  t = -b - std::sqrt(disc);
  if (t < 0) { if (c > 0) return false; t = 0; facing = 1; return true; }
  double nx = (px + t * dx) / o.r, ny = (py + t * dy) / o.r;
  facing = std::fabs(nx * dx + ny * dy);
  return true;
}

// distance from (ox,oy) along (dx,dy) to the first wall or obstacle, walking the tile grid.
// *facing = how square-on the surface is to the ray (1 = head-on).
static double raycast(double ox, double oy, double dx, double dy, double maxd, double *facing = nullptr) {
  const double S = field::TILE, INF = 1e9;
  int ix = (int)std::floor(ox / S), iy = (int)std::floor(oy / S);
  int stepX = dx > 0 ? 1 : -1, stepY = dy > 0 ? 1 : -1;
  double tMaxX = std::fabs(dx) < 1e-12 ? INF : ((dx > 0 ? (ix + 1) * S - ox : ox - ix * S) / std::fabs(dx));
  double tMaxY = std::fabs(dy) < 1e-12 ? INF : ((dy > 0 ? (iy + 1) * S - oy : oy - iy * S) / std::fabs(dy));
  double tDX = std::fabs(dx) < 1e-12 ? INF : S / std::fabs(dx), tDY = std::fabs(dy) < 1e-12 ? INF : S / std::fabs(dy);
  for (int guard = 0; guard < 64; guard++) {
    double tExit = std::min(tMaxX, tMaxY), best = INF, bestFacing = 1;
    wallsNearCell(ix, iy, [&](const double *b) {
      double t, fc;
      if (rayBox(ox, oy, dx, dy, b, t, fc) && t < best) { best = t; bestFacing = fc; }
    });
    if (W.in(ix, iy))
      for (int k : obstaclesInCell[W.id(ix, iy)]) {
        double t, fc;
        if (rayCircle(ox, oy, dx, dy, W.obstacles[k], t, fc) && t < best) { best = t; bestFacing = fc; }
      }
    if (best <= tExit + 1e-9) {
      if (best > maxd) return INF;
      if (facing) *facing = bestFacing;
      return best;
    }
    if (tExit > maxd) return INF;
    if (tMaxX < tMaxY) { ix += stepX; tMaxX += tDX; } else { iy += stepY; tMaxY += tDY; }
  }
  return INF;
}

// does the robot body at pose (x,y,head) touch any wall or obstacle? The body is the outline from
// the CAD (convex); walls are boxes (thickness + posts), obstacles circles.
// wallsOnly: ignore obstacles. hit: if not null, set to the obstacle touched (or -1 for a wall).
static bool collides(double x, double y, double head, bool wallsOnly = false, int *hit = nullptr) {
  if (hit) *hit = -1;
  const int n = (int)outF.size();
  double sh, ch, px[32], py[32];
  collideSC.at(head, sh, ch);
  for (int k = 0; k < n; k++) { px[k] = x + outF[k] * sh - outL[k] * ch; py[k] = y + outF[k] * ch + outL[k] * sh; }
  // separating-axis test against an axis-aligned box b = x0, y0, x1, y1
  auto hitsBox = [&](const double *b) {
    // quick reject: box further than the outline's radius
    double qx = std::max(b[0], std::min(x, b[2])), qy = std::max(b[1], std::min(y, b[3]));
    if ((qx - x) * (qx - x) + (qy - y) * (qy - y) > outlineRadius * outlineRadius) return false;
    double mnx = 1e18, mxx = -1e18, mny = 1e18, mxy = -1e18;
    for (int k = 0; k < n; k++) { mnx = std::min(mnx, px[k]); mxx = std::max(mxx, px[k]); mny = std::min(mny, py[k]); mxy = std::max(mxy, py[k]); }
    if (mxx < b[0] || mnx > b[2] || mxy < b[1] || mny > b[3]) return false;
    for (int k = 0; k < n; k++) {
      int j = (k + 1) % n;
      double ax = -(py[j] - py[k]), ay = px[j] - px[k];
      double pmin = 1e18, pmax = -1e18;
      for (int m = 0; m < n; m++) { double d = px[m] * ax + py[m] * ay; pmin = std::min(pmin, d); pmax = std::max(pmax, d); }
      double c[4] = {b[0] * ax + b[1] * ay, b[2] * ax + b[1] * ay, b[0] * ax + b[3] * ay, b[2] * ax + b[3] * ay};
      double bmin = std::min(std::min(c[0], c[1]), std::min(c[2], c[3])), bmax = std::max(std::max(c[0], c[1]), std::max(c[2], c[3]));
      if (pmax < bmin || pmin > bmax) return false;
    }
    return true;
  };
  int cx = (int)std::floor(x / field::TILE), cy = (int)std::floor(y / field::TILE);
  double b[4];
  for (int gy = cy - 1; gy <= cy + 2; gy++)       // walls along y = gy
    for (int gx = cx - 2; gx <= cx + 1; gx++)
      if (W.hasWall(gx, gy, 2)) { edgeBox(gx, gy, true, b); if (hitsBox(b)) return true; }
  for (int gx = cx - 1; gx <= cx + 2; gx++)       // walls along x = gx
    for (int gy = cy - 2; gy <= cy + 1; gy++)
      if (W.hasWall(gx, gy, 3)) { edgeBox(gx, gy, false, b); if (hitsBox(b)) return true; }
  if (wallsOnly) return false;
  for (int ty = cy - 1; ty <= cy + 1; ty++)
    for (int tx = cx - 1; tx <= cx + 1; tx++) {
      if (!W.in(tx, ty)) continue;
      for (int k : obstaclesInCell[W.id(tx, ty)]) {
        const field::Obstacle &o = W.obstacles[k];
        if (std::hypot(o.x - x, o.y - y) > outlineRadius + o.r) continue;
        // inside the outline, or closer than r to one of its edges
        bool inside = true;
        double best = 1e18;
        for (int m = 0; m < n; m++) {
          int j = (m + 1) % n;
          double ex = px[j] - px[m], ey = py[j] - py[m], wx = o.x - px[m], wy = o.y - py[m];
          if (ex * wy - ey * wx < 0) inside = false; // outline is counter-clockwise
          double t = std::max(0.0, std::min(1.0, (wx * ex + wy * ey) / (ex * ex + ey * ey)));
          double dx = wx - t * ex, dy = wy - t * ey;
          best = std::min(best, dx * dx + dy * dy);
        }
        if (inside || best < o.r * o.r) { if (hit) *hit = k; return true; }
      }
    }
  return false;
}

// =====================================================================================
// Physics + referee, advanced by every hardware call
// =====================================================================================
static void lackOfProgress(const char *why);

// Does obstacle k (a circle) overlap a wall or another obstacle?
static bool obstacleBlocked(int k) {
  const field::Obstacle &o = W.obstacles[k];
  int cx = (int)std::floor(o.x / field::TILE), cy = (int)std::floor(o.y / field::TILE);
  bool hit = false;
  for (int ty = cy - 1; ty <= cy + 1 && !hit; ty++)
    for (int tx = cx - 1; tx <= cx + 1 && !hit; tx++)
      wallsNearCell(tx, ty, [&](const double *b) {
        double qx = std::max(b[0], std::min(o.x, b[2])), qy = std::max(b[1], std::min(o.y, b[3]));
        if (std::hypot(o.x - qx, o.y - qy) < o.r) hit = true;
      });
  for (size_t j = 0; j < W.obstacles.size() && !hit; j++)
    if ((int)j != k && std::hypot(W.obstacles[j].x - o.x, W.obstacles[j].y - o.y) < W.obstacles[j].r + o.r) hit = true;
  return hit;
}

// The robot's next pose (nx, ny, nh) runs into a loose obstacle: push it along if the wheels' grip can
// overcome its floor friction (the robot slows down by the share of its push the friction takes), unless
// that would shove it into a wall or another obstacle. On success nx, ny are the robot's pose after the push.
static bool pushObstacle(double &nx, double &ny, double nh) {
  if (obstacleMass.empty() || collides(nx, ny, nh, true)) return false; // no loose obstacles, or a wall in the way
  int k;
  collides(nx, ny, nh, false, &k);
  if (k < 0 || obstacleMass[k] <= 0) return false;                     // a fixed obstacle
  double need = P.obstacleMu * obstacleMass[k] * 9.81, can = P.pushGripMu * P.robotMassKg * 9.81;
  if (need >= can) return false;                                        // too heavy for the wheels' grip
  double f = 1 - need / can, px = rx + (nx - rx) * f, py = ry + (ny - ry) * f;
  field::Obstacle before = W.obstacles[k];
  W.obstacles[k].x += px - rx; W.obstacles[k].y += py - ry;             // moves with the robot
  indexObstacles();
  for (int it = 0, j; it < 40 && collides(px, py, nh, false, &j) && j == k; it++) { // still overlapping (turning): out of the way
    double d = std::max(1e-6, std::hypot(W.obstacles[k].x - px, W.obstacles[k].y - py));
    W.obstacles[k].x += (W.obstacles[k].x - px) / d; W.obstacles[k].y += (W.obstacles[k].y - py) / d;
    indexObstacles();
  }
  if (obstacleBlocked(k) || collides(px, py, nh)) { W.obstacles[k] = before; indexObstacles(); return false; }
  pushedMm += std::hypot(W.obstacles[k].x - before.x, W.obstacles[k].y - before.y);
  nx = px; ny = py;
  return true;
}

static double motorOhms() { return 12.0 / 1.6; } // Pololu #3493: 12 V, 1.6 A stall

static void physicsStep(double dt) {
  // motors -> wheel surface speeds. DC motor: steady speed = no-load speed x (duty - load torque /
  // stall torque), all scaled to the battery voltage. Load = gearbox friction (more from standstill)
  // + sideways wheel drag when turning (skid steering) + gravity on a ramp.
  double V = P.batteryVoltage;
  double vNoLoad = P.noLoadRpmAt12V * V / 12.0 / 60.0 * M_PI * P.wheelDiameter; // mm/s at full PWM
  double stallNm = P.stallKgcmAt12V * V / 12.0 * 0.0980665 * motorOhms() / (motorOhms() + P.driverOhms);
  double rM = P.wheelDiameter / 2000.0, wheelLoadN = P.robotMassKg * 9.81 / 4;
  double friction = P.frictionFracAt12V * 12.0 / V;                                       // fraction of stall torque
  double skidSpin = P.wheelMu * wheelLoadN * (axleOffset / (P.trackWidth / 2)) * rM / stallNm; // turning on the spot
  double sinPitch, cosPitch;
  pitchSC.at(rpitch, sinPitch, cosPitch);
  double gravity = wheelLoadN * sinPitch * rM / stallNm;                                 // nose up = positive
  double duty[5] = {0, 0, 0, 0, 0};
  for (int i = 1; i <= 4; i++) {
    duty[i] = (mot[i].dir == FORWARD ? 1 : mot[i].dir == BACKWARD ? -1 : 0) * mot[i].pwm / 255.0;
    if (i == 4) duty[i] = -duty[i]; // D is mounted reversed
  }
  double dL = (duty[1] + duty[3]) / 2, dR = (duty[2] + duty[4]) / 2;
  double turning = std::min(1.0, std::fabs(dL - dR) / std::max(1e-9, std::fabs(dL) + std::fabs(dR))); // 0 straight .. 1 spin
  for (int i = 1; i <= 4; i++) {
    Motor &m = mot[i];
    double d = duty[i];
    double extraA = i == 1 ? P.motorAExtraFriction * std::max(0.0, 1 - std::fabs(d) / (128 / 255.0)) : 0;
    double resist = friction + extraA + skidSpin * turning + P.slopeDrag * std::fabs(sinPitch); // slopeDrag: see Params
    if (std::fabs(m.speed) < 1) resist *= P.stictionFactor;
    double eff = std::fabs(d) - resist - gravity * (d >= 0 ? 1 : -1); // driving uphill costs, downhill helps
    double target = eff > 0 ? (d > 0 ? 1 : -1) * eff * vNoLoad * m.gain : 0;
    static double lastDt = -1, lastTau = -1, lag = 0; // same step length almost every time: don't redo exp()
    if (dt != lastDt || P.motorTau != lastTau) { lastDt = dt; lastTau = P.motorTau; lag = 1 - std::exp(-dt / P.motorTau); }
    m.speed += (target - m.speed) * lag;
    // grip wanders slowly (Ornstein-Uhlenbeck)
    m.traction += (P.tractionMean - m.traction) * dt / P.tractionTau + gauss(P.tractionSigma * std::sqrt(2 * dt / P.tractionTau));
    m.traction = std::min(1.0, std::max(0.5, m.traction));
  }
  // encoders count wheel rotation, whether or not the robot actually moves
  auto encode = [&](int i, volatile int &count) {
    Motor &m = mot[i];
    m.encFrac += m.speed * dt / (M_PI * P.wheelDiameter) * P.encoderCountsPerRev;
    int whole = (int)m.encFrac;
    count += whole; m.encFrac -= whole;
  };
  encode(1, drivetrain.encoderCountA);
  encode(2, drivetrain.encoderCountB);
  encode(4, drivetrain.encoderCountD);
  // skid-steer body motion
  double vL = (mot[1].speed * mot[1].traction + mot[3].speed * mot[3].traction) / 2;
  double vR = (mot[2].speed * mot[2].traction + mot[4].speed * mot[4].traction) / 2;
  double v = (vL + vR) / 2 * cosPitch;
  double turnDeg = (vL - vR) / (P.trackWidth * P.skidFactor) * dt * 180 / M_PI; // left faster -> clockwise
  double nh = rhead + turnDeg, mid = rad(rhead + turnDeg / 2);
  double nx = rx + v * dt * std::sin(mid), ny = ry + v * dt * std::cos(mid);
  inContact = false;
  if (!collides(nx, ny, nh)) { rx = nx; ry = ny; rhead = nh; }
  else if (pushObstacle(nx, ny, nh)) { rx = nx; ry = ny; rhead = nh; contactUs += dt * 1e6; inContact = true; }
  else {
    contactUs += dt * 1e6;
    inContact = true;
    bool turned = false;
    if (std::fabs(turnDeg) > 1e-9) {
      if (!collides(rx, ry, nh)) { rhead = nh; turned = true; } // can still turn on the spot
      else {
        // turning with a corner on a wall: the wall shoves the robot sideways as it scrapes round
        // (up to P.wallNudgeMm per ms), instead of locking it in place
        double step = P.wallNudgeMm * dt * 1000;
        const double dirs[8][2] = {{1, 0}, {-1, 0}, {0, 1}, {0, -1}, {0.7, 0.7}, {0.7, -0.7}, {-0.7, 0.7}, {-0.7, -0.7}};
        for (const auto &d : dirs)
          if (step > 0 && !collides(rx + d[0] * step, ry + d[1] * step, nh)) { rx += d[0] * step; ry += d[1] * step; rhead = nh; turned = true; break; }
      }
    }
    if (!turned && !collides(nx, ny, rhead)) { rx = nx; ry = ny; } // or slide along without turning
  }
  rhead = wrap360(rhead);
  // pitch from the floor under the two axles
  double fx, fy, bx, by;
  robotToWorld(axleOffset, 0, fx, fy);
  robotToWorld(-axleOffset, 0, bx, by);
  rpitch = std::atan2(W.height(fx, fy) - W.height(bx, by), 2 * axleOffset) * 180 / M_PI;
}

// one frame of the recording: true pose, what the code believes, sensors, motors, and the tiles of
// the code's map that changed since the last frame
static int tileCode(Tile &t) {
  int c = 0;
  for (int d = 0; d < 4; d++) c |= t.getWall(d) << d;
  c |= t.getVisited() << 4 | (int)t.getType() << 5 | t.getElevate() << 7 | t.getDescend() << 8 | t.getDiscovered() << 13;
  for (int d = 0; d < 4; d++) c |= t.getObstacle(d) << (9 + d); // edges blocked by blockEdge() (or a real obstacle)
  return c;
}
static void traceFrame(double runS) {
  nextTraceUs = tUs + 50000;
  char b[320];
  auto signedPwm = [](int i) { return mot[i].pwm * (mot[i].dir == BACKWARD ? -1 : mot[i].dir == FORWARD ? 1 : 0); };
  std::snprintf(b, sizeof b, "{\"t\":%d,\"x\":%.1f,\"y\":%.1f,\"h\":%.1f,\"p\":%.1f,\"g\":%.1f,\"mx\":%d,\"my\":%d,\"f\":%d,\"d\":%d,\"s\":%d,\"c\":%d,\"pw\":[%d,%d,%d,%d],\"tof\":[",
                (int)(runS * 1000), rx, ry, rhead, rpitch, gyroLast, x_pos, y_pos, currentFloor, (int)currentDir, (int)state, (int)inContact,
                signedPwm(1), signedPwm(2), signedPwm(3), -signedPwm(4));
  *traceOut << b;
  for (int i = 1; i <= 7; i++) *traceOut << (i > 1 ? "," : "") << tofLast[i];
  *traceOut << "]";
  if (lcdText != lcdTraced) { lcdTraced = lcdText; *traceOut << ",\"lcd\":\"" << jsonEsc(lcdText) << "\""; }
  if (mapTraced.empty()) mapTraced.assign(NUM_FLOORS * MAP_SIZE * MAP_SIZE, 0);
  bool first = true;
  for (int f = 0; f < NUM_FLOORS; f++) {
    Grid &g = f == currentFloor ? mapGrid : floorGrid(f); // mapGrid is the working copy of the current floor
    for (int x = 0; x < MAP_SIZE; x++)
      for (int y = 0; y < MAP_SIZE; y++) {
        uint32_t c = tileCode(g[x][y]), &prev = mapTraced[(f * MAP_SIZE + x) * MAP_SIZE + y];
        if (c == prev) continue;
        prev = c;
        *traceOut << (first ? ",\"m\":[" : ",") << "[" << f << "," << x << "," << y << "," << c << "]";
        first = false;
      }
  }
  if (!first) *traceOut << "]";
  // obstacles the robot pushed since the last frame: "ob":[[index, x, y], ...]
  static std::vector<std::array<int, 2>> obTraced;
  if (obTraced.size() != W.obstacles.size()) { obTraced.clear(); for (const field::Obstacle &o : W.obstacles) obTraced.push_back({(int)o.x, (int)o.y}); }
  bool firstOb = true;
  for (size_t k = 0; k < W.obstacles.size(); k++) {
    int x = (int)W.obstacles[k].x, y = (int)W.obstacles[k].y;
    if (x == obTraced[k][0] && y == obTraced[k][1]) continue;
    obTraced[k] = {x, y};
    *traceOut << (firstOb ? ",\"ob\":[" : ",") << "[" << k << "," << x << "," << y << "]";
    firstOb = false;
  }
  if (!firstOb) *traceOut << "]";
  *traceOut << "}\n";
  if (live) traceOut->flush();
}

void simSerialOut(const char *text) {
  if (simSerialEcho) std::fputs(text, stdout);
  if (!traceOut) return;
  for (const char *c = text; *c; c++) {
    if (*c != '\n') { serialLine += *c; continue; }
    *traceOut << "{\"log\":\"" << jsonEsc(serialLine) << "\",\"t\":" << (runStarted ? (int)((tUs - runStartUs) / 1000) : 0) << "}\n";
    serialLine.clear();
  }
}

// RCJ 2026, 5.4.4: a tile is "visited" when more than half of the robot is inside it (seen from
// above). Returns that tile's id, or -1 while the robot straddles tiles.
static double nextFootprintUs = 0;
// floor() for the footprint test (a library call there was 14% of the run time); exact for any
// value an int can hold
static inline int floorInt(double v) { int i = (int)v; return (v < i) ? i - 1 : i; }

static int majorityTile() {
  const int N = 12; // N x N sample points over the footprint (CAD outline)
  int ids[8], counts[8], n = 0;
  for (int i = 0; i < N; i++)
    for (int j = 0; j < N; j++) {
      double fwd = -bodyBack + (bodyFront + bodyBack) * (i + 0.5) / N;
      double left = -bodyHalfWidth + 2 * bodyHalfWidth * (j + 0.5) / N;
      double wx, wy;
      robotToWorld(fwd, left, wx, wy);
      int x = floorInt(wx / field::TILE), y = floorInt(wy / field::TILE);
      if (!W.in(x, y)) continue;
      int id = W.id(x, y), k = 0;
      while (k < n && ids[k] != id) k++;
      if (k == n) { if (n == 8) continue; ids[n] = id; counts[n++] = 0; }
      counts[k]++;
    }
  for (int k = 0; k < n; k++)
    if (counts[k] * 2 > N * N) return ids[k];
  return -1;
}

// carryTest / homeCarry (see Params): a person moves the robot by hand, as in TEST_PRIORITY.md tests 4 and 5
static bool carryDone = false, homeCarryDone = false, holdSet = false;
static int holdPhase = 0; // carryTest 3: 1 = waiting for the next move, 2 = done
static double holdX = 0, holdY = 0;
static void testEvent(const std::string &what) {
  if (traceOut) *traceOut << "{\"event\":\"carry\",\"why\":\"" << jsonEsc(what) << "\",\"t\":" << (int)((tUs - runStartUs) / 1000) << "}\n";
}
// put the robot in the middle of tile (x, y) facing `head`; false (nothing changed) if it wouldn't fit there
static bool carryTo(int x, int y, double head, bool pause) {
  double ox = rx, oy = ry, oh = rhead;
  rx = (x + 0.5) * field::TILE + gauss(P.placeSigmaMm); ry = (y + 0.5) * field::TILE + gauss(P.placeSigmaMm);
  rhead = wrap360(head + gauss(P.placeSigmaDeg));
  if (collides(rx, ry, rhead)) { rx = ox; ry = oy; rhead = oh; return false; }
  for (int i = 1; i <= 4; i++) mot[i].speed = 0;
  if (pause) { switchHigh = true; pauseUntilUs = tUs + P.lopPauseS * 1e6; }
  lastProgressUs = tUs + (pause ? P.lopPauseS * 1e6 : 0);
  return true;
}
static void testEvents(bool enteredSense) {
  const double T = field::TILE;
  int tx = (int)std::floor(rx / T), ty = (int)std::floor(ry / T);
  if (P.carryTest > 0 && !carryDone && enteredSense && !switchHigh && visitedCount >= P.carryAfterTiles && W.in(tx, ty) &&
      (P.carryOnRevisit <= 0 || mapGrid[x_pos][y_pos].getVisited())) {
    int k = (int)std::lround(rhead / 90.0) % 4, back = (k + 2) % 4, bx = tx + field::DX[back], by = ty + field::DY[back];
    if (W.in(bx, by) && !W.hasWall(tx, ty, back) && W.type[W.id(bx, by)] == field::FLOOR && W.level[W.id(bx, by)] == W.level[W.id(tx, ty)]) {
      if (P.carryTest == 3) { holdPhase = 1; carryDone = true; testEvent("hold the robot through its next move"); }
      else if (carryTo(bx, by, rhead, P.carryTest == 1)) {
        carryDone = true;
        testEvent(P.carryTest == 1 ? "pause, carried back one tile, resume" : "carried back one tile (no pause)");
      }
    }
  }
  if (holdPhase == 1) {
    if (state == EXECUTE_MOVE) { if (!holdSet) { holdX = rx; holdY = ry; holdSet = true; } rx = holdX; ry = holdY; }
    else if (holdSet) { holdPhase = 2; testEvent("let go"); }
  }
  if (P.homeCarry > 0 && !homeCarryDone && state == RETURN && !switchHigh) {
    homeCarryDone = true;
    if (std::abs(tx - W.sx) + std::abs(ty - W.sy) < 2) { testEvent("home carry skipped: already next to the start"); return; }
    std::vector<int> ds;
    for (int d = 0; d < 4; d++) {
      int nx = W.sx + field::DX[d], ny = W.sy + field::DY[d];
      if (W.in(nx, ny) && !W.hasWall(W.sx, W.sy, d) && W.type[W.id(nx, ny)] == field::FLOOR && W.level[W.id(nx, ny)] == W.level[W.id(W.sx, W.sy)]) ds.push_back(d);
    }
    std::shuffle(ds.begin(), ds.end(), rng);
    for (int d : ds)
      if (carryTo(W.sx + field::DX[d], W.sy + field::DY[d], ((d + 2) % 4) * 90.0, true)) {
        testEvent(std::string("pause, carried to the tile next to the start (") + "NESW"[d] + " of it, facing it), resume" +
                  (cpX == W.sx && cpY == W.sy ? "" : "; last checkpoint is not the start"));
        return;
      }
    testEvent("home carry skipped: no free tile next to the start");
  }
}

static void refereeTick() {
  Pausemaze = switchHigh; // what pauseTask() does every 10 ms
  if (!runStarted) return;
  if (switchHigh && tUs >= pauseUntilUs) switchHigh = false;
  double runS = (tUs - runStartUs) / 1e6;
  if (stopClaimUs >= 0) {
    if (stopLopUs < 0) {
      if (runS >= P.runTimeS) throw SimEnd{stopEnd};
      if (tUs - stopClaimUs >= 2e6) { // the captain sees it standing still
        stopLopsBefore = lops; stopReasonsBefore = lopReasons; stopX = rx; stopY = ry; stopHead = rhead;
        lackOfProgress(stopWhy.c_str());
        stopLopUs = tUs; movedSinceStopLop = false; stopLopVisited = visitedCount;
      }
    } else {
      if (!switchHigh)
        for (int i = 1; i <= 4; i++)
          if (mot[i].pwm > 0 && (mot[i].dir == FORWARD || mot[i].dir == BACKWARD)) movedSinceStopLop = true;
      if (movedSinceStopLop) stopClaimUs = stopLopUs = -1; // it carried on: the restart counts
      else if (tUs - stopLopUs > (P.lopPauseS + 15) * 1e6 || runS >= P.runTimeS) {
        lops = stopLopsBefore; lopReasons = stopReasonsBefore; rx = stopX; ry = stopY; rhead = stopHead;
        throw SimEnd{stopEnd};
      }
    }
  }
  if (runS >= P.runTimeS) throw SimEnd{"time"};
  int tx = (int)std::floor(rx / field::TILE), ty = (int)std::floor(ry / field::TILE);
  if (!switchHigh && tUs >= nextFootprintUs) {
    nextFootprintUs = tUs + 5000;
    // standing still on the current tile (needed on blue tiles: 5 s)
    if (std::hypot(rx - lastStillX, ry - lastStillY) < 0.5) stillUs += 5000; else stillUs = 0;
    lastStillX = rx; lastStillY = ry;
    if (curTile >= 0 && W.type[curTile] == field::BLUE_T && stillUs >= 5e6 && !blueStopped) { blueStopped = true; blueGood[curTile]++; }
    int m = majorityTile();
    if (m >= 0 && m != curTile) {
      // RCJ 5.5.1c: visiting another tile without first stopping 5 s on a blue tile
      bool leftBlueEarly = curTile >= 0 && W.type[curTile] == field::BLUE_T && !blueStopped;
      int from = curTile;
      if (from >= 0 && !W.bump.empty() && W.bump[from]) bumpsDone.insert(from); // left a speed-bump tile: crossed
      curTile = m; stillUs = 0; blueStopped = false;
      lastTileX = m % W.W; lastTileY = m / W.W; lastProgressUs = tUs;
      int t = W.type[m];
      if (t != field::RAMP_T) {
        if (!visited[m]) visitedCount++;
        visited[m] = true;
        if (lastLevel >= 0 && W.level[m] != lastLevel) {
          rampCrossings++;
          rampsDone.insert(lastRampRow); // up or down: 10 points per ramp, once
        }
        lastLevel = W.level[m];
      } else lastRampRow = m / W.W;
      if (t == field::SILVER_T) { cpX = m % W.W; cpY = m / W.W; cpVisited[m] = true; }
      if (t == field::BLUE_T) blueVisits[m]++;
      if (t == field::BLACK_T) lackOfProgress("drove onto a black tile");          // RCJ 5.5.1b
      else if (leftBlueEarly) { (void)from; lackOfProgress("left a blue tile before stopping 5 s"); }
    }
  }
  if (!switchHigh && (tUs - lastProgressUs) / 1e6 > P.stuckTimeoutS) lackOfProgress("stuck");
  // is the code's map position right? (checked while it reads the walls of a tile)
  static int prevState = -1;
  bool enteredSense = state == SENSE_TILE && prevState != SENSE_TILE;
  prevState = state;
  testEvents(enteredSense);
  if (state == SENSE_TILE && !switchHigh && W.in(tx, ty) && W.type[W.id(tx, ty)] != field::RAMP_T) {
    int ef = START_FLOOR + W.level[W.id(tx, ty)] - W.level[W.id(W.sx, W.sy)];
    if (P.oracleTile > 0 && enteredSense && currentFloor == ef) { x_pos = tx - W.sx + MAP_SIZE / 2; y_pos = ty - W.sy + MAP_SIZE / 2; }
    if (P.oracleCentre > 0 && enteredSense && W.level[W.id(tx, ty)] == W.level[curTile >= 0 ? curTile : W.id(tx, ty)]) {
      double ox = rx, oy = ry, cx = (tx + 0.5) * field::TILE, cy = (ty + 0.5) * field::TILE;
      // 1 = both directions, 2 = only along the way it faces, 3 = only sideways
      bool facesY = ((int)std::lround(rhead / 90.0) % 2) == 0;
      if (P.oracleCentre != 3) { if (facesY) ry = cy; else rx = cx; }
      if (P.oracleCentre != 2) { if (facesY) rx = cx; else ry = cy; }
      if (collides(rx, ry, rhead)) { rx = ox; ry = oy; }
    }
    syncSamples++;
    if (x_pos != tx - W.sx + MAP_SIZE / 2 || y_pos != ty - W.sy + MAP_SIZE / 2 || currentFloor != ef) lostSamples++;
  }
  if (traceOut && tUs >= nextTraceUs) traceFrame(runS);
}

static void lackOfProgress(const char *why) {
  // referee restart: a teammate flips the pause switch and puts the robot on the last checkpoint
  lops++;
  if (!lopReasons.empty()) lopReasons += "; ";
  lopReasons += why;
  switchHigh = true;
  pauseUntilUs = tUs + P.lopPauseS * 1e6;
  rx = (cpX + 0.5) * field::TILE + gauss(P.placeSigmaMm);
  ry = (cpY + 0.5) * field::TILE + gauss(P.placeSigmaMm);
  // RCJ 2026 5.5.2: after a lack of progress "the robot can be installed in any direction"
  rhead = wrap360((P.lopAnyDirection > 0 ? 90.0 * std::uniform_int_distribution<int>(0, 3)(rng) : mapStartHead) + gauss(P.placeSigmaDeg));
  for (int i = 1; i <= 4; i++) mot[i].speed = 0;
  lastTileX = cpX; lastTileY = cpY; lastProgressUs = tUs + P.lopPauseS * 1e6;
  curTile = W.id(cpX, cpY); stillUs = 0; blueStopped = false; lastStillX = rx; lastStillY = ry;
  if (traceOut) *traceOut << "{\"event\":\"lop\",\"why\":\"" << why << "\",\"t\":" << (int)((tUs - runStartUs) / 1000)
                             << ",\"cx\":" << cpX << ",\"cy\":" << cpY << "}\n";
}

// ---- live mode: run at wall-clock speed (x liveSpeed) and obey commands from the server ----
double liveWallMs();
void liveSleepMs(double ms);
std::string liveReadInput();
static bool livePaused = false;
static double liveSpeed = 1, liveSimAnchorUs = 0, liveWallAnchorMs = 0, liveNextUs = 0;
static std::string liveInbox;

static void liveRebase() { liveSimAnchorUs = tUs; liveWallAnchorMs = liveWallMs(); }
static void liveEvent(const char *what) {
  *traceOut << "{\"event\":\"" << what << "\",\"t\":" << (int)((tUs - runStartUs) / 1000) << "}\n";
  traceOut->flush();
}
static void liveCommand(const std::string &c) {
  if (c == "pause" && !livePaused) { livePaused = true; liveEvent("paused"); }
  else if (c == "resume" && livePaused) { livePaused = false; liveRebase(); liveEvent("resumed"); }
  else if (c.compare(0, 6, "speed ") == 0) { liveSpeed = std::atof(c.c_str() + 6); liveRebase(); } // 0 = as fast as possible
  else if (c == "lop" && !switchHigh) lackOfProgress("restart button");
  else if (c == "nudge") { // someone bumps the robot: up to 40 mm and 15 degrees, never into a wall
    std::uniform_real_distribution<double> u(-1, 1);
    for (int k = 0; k < 30; k++) {
      double nx = rx + 40 * u(rng), ny = ry + 40 * u(rng), nh = wrap360(rhead + 15 * u(rng));
      if (!collides(nx, ny, nh)) { rx = nx; ry = ny; rhead = nh; break; }
    }
    liveEvent("nudge");
  }
  else if (c == "stop") throw SimEnd{"stopped"};
}
static void livePace() {
  liveInbox += liveReadInput();
  for (size_t nl; (nl = liveInbox.find('\n')) != std::string::npos;) {
    std::string c = liveInbox.substr(0, nl);
    liveInbox.erase(0, nl + 1);
    while (!c.empty() && (c.back() == '\r' || c.back() == ' ')) c.pop_back();
    liveCommand(c);
  }
  while (livePaused) {
    liveSleepMs(40);
    liveInbox += liveReadInput();
    for (size_t nl; (nl = liveInbox.find('\n')) != std::string::npos;) {
      std::string c = liveInbox.substr(0, nl);
      liveInbox.erase(0, nl + 1);
      while (!c.empty() && (c.back() == '\r' || c.back() == ' ')) c.pop_back();
      liveCommand(c);
    }
  }
  if (liveSpeed > 0) {
    double ahead = (tUs - liveSimAnchorUs) / 1000.0 / liveSpeed - (liveWallMs() - liveWallAnchorMs);
    if (ahead > 2) liveSleepMs(ahead);
    else if (ahead < -500) liveRebase(); // a slow PC fell behind: carry on from here instead of rushing
  }
}

static bool simReady = false; // false while global objects are being constructed (before main)

static void simAdvance(double us) {
  if (!simReady) { tUs += us; return; } // firmware globals (timers, PIDs) call micros() before main runs
  double end = tUs + us;
  while (tUs < end) {
    double h = std::min(1000.0, end - tUs);
    // a leftover below a nanosecond: the 32-bit build keeps `end` at higher precision than tUs, so
    // tUs += h can round back to the same value and this loop would never finish
    if (h < 1e-3) { tUs = end; break; }
    physicsStep(h / 1e6);
    tUs += h;
    refereeTick();
    if (live && runStarted && tUs >= liveNextUs) { liveNextUs = tUs + 10000; livePace(); }
  }
}

// =====================================================================================
// Simulated Arduino core and libraries
// =====================================================================================
unsigned long millis() { simAdvance(1); return (unsigned long)(tUs / 1000); }
unsigned long micros() { simAdvance(1); return (unsigned long)tUs; }
void delay(unsigned long ms) { simAdvance(ms * 1000.0); }
void delayMicroseconds(unsigned int us) { simAdvance(us); }
namespace rtos { namespace ThisThread { void sleep_for(std::chrono::milliseconds ms) { simAdvance(ms.count() * 1000.0); } } }
void pinMode(int, int) {}
int digitalRead(int pin) { return pin == 22 && switchHigh ? HIGH : LOW; } // 22 = logic (pause) switch
void digitalWrite(int, int) {}
void attachInterrupt(int, void (*)(), int) {}
void detachInterrupt(int) {}

void TwoWire::begin() {}
void TwoWire::beginTransmission(uint8_t) {}
size_t TwoWire::write(uint8_t) { return 1; }
uint8_t TwoWire::endTransmission(bool) { simAdvance(150); return 2; } // nothing answers a raw scan
uint8_t TwoWire::requestFrom(uint8_t, uint8_t) { simAdvance(150); return 0; }
int TwoWire::available() { return 0; }
int TwoWire::read() { return -1; }

bool QWIICMUX::begin(uint8_t, TwoWire &) { return true; }
bool QWIICMUX::setPort(uint8_t p) { muxPort = p; simAdvance(150); return true; }

bool VL53L0X::init(bool) { simAdvance(2000); return true; }
uint16_t VL53L0X::readRangeContinuousMillimeters() {
  int code = portToSensor[muxPort & 7];
  if (code < 1 || code > 7 || !tof[code].ok) { simAdvance(500); return 65535; }
  TofSensor &s = tof[code];
  // continuous mode: wait for a sample newer than the last one read
  long k = (long)std::floor((tUs - s.phaseUs) / P.tofPeriodUs);
  if (k <= s.lastSample) { k = s.lastSample + 1; simAdvance(s.phaseUs + k * P.tofPeriodUs - tUs); }
  s.lastSample = k;
  simAdvance(400); // I2C read
  double ox, oy;
  robotToWorld(s.fwd, s.left, ox, oy);
  double base = rhead + (s.facing == 0 ? 0 : s.facing == 1 ? 90 : s.facing == 2 ? 180 : -90); // forward/right/back/left
  // The beam is a ~25 degree cone, strongest in the middle. With several surfaces in view the
  // sensor reports roughly the signal-weighted distance: weight = beam strength x how square-on
  // the surface is / distance^2 (nearer, face-on walls return far more light).
  const int RAYS = 11;
  double sigma = P.tofConeDeg / 2.355, half = P.tofConeDeg * 0.6;
  double sumW = 0, sumWD = 0, sumProfile = 0;
  for (int r = 0; r < RAYS; r++) {
    double off = -half + 2 * half * r / (RAYS - 1), prof = std::exp(-off * off / (2 * sigma * sigma)), facing = 1;
    sumProfile += prof;
    double a = rad(base + off);
    double d = raycast(ox, oy, std::sin(a), std::cos(a), P.tofMaxRange * 1.5, &facing);
    if (d > P.tofMaxRange * 1.5) continue;
    double w = prof * std::max(0.05, facing) / std::max(d * d, 100.0);
    sumW += w; sumWD += w * d;
  }
  // The cone also spreads up and down: its lower part reaches the floor, or a ramp's slope ahead. MEASURED on the
  // robot: the back sensor (43 mm up) reads 170-540 mm with nothing behind it, the front ones ~690 on open floor and
  // ~360-390 facing a ramp from the tile before it (logs/2026-10-16, 2026-10-17 sensor_check / ramp_sensors).
  if (P.tofFloorGain > 0) {
    double gz = W.height(rx, ry), hz = gz + s.height;
    double axisElev = s.facing == 0 ? rpitch : s.facing == 2 ? -rpitch : 0; // nose up tilts the front beams up
    double rx0 = W.rampX0 * field::TILE, rx1 = (W.rampX0 + W.rampLen) * field::TILE;
    for (double hOff : {-half / 2, 0.0, half / 2}) {
      double a = rad(base + hOff), dx = std::sin(a), dy = std::cos(a);
      double dWall = raycast(ox, oy, dx, dy, P.tofMaxRange * 1.5);
      double profH = std::exp(-hOff * hOff / (2 * sigma * sigma));
      for (double vOff : {0.0, half / 3, 2 * half / 3, half}) {         // degrees below the beam axis
        double elev = rad(axisElev - vOff), tz = std::tan(elev);
        double sHit = -1, slope = 0;
        bool nearRamp = !W.rampUp.empty() ||  // a drawn field's ramps can run any way: always march (small fields)
                        (W.rampLen > 0 && std::max(ox, ox + dx * dWall) > rx0 && std::min(ox, ox + dx * dWall) < rx1);
        if (nearRamp) {                                                  // march: the ground isn't flat
          for (double t = 20; t < std::min(dWall, P.tofMaxRange); t += 20) {
            double g = W.height(ox + dx * t, oy + dy * t);
            if (hz + t * tz <= g) { sHit = t; slope = std::atan((g - W.height(ox + dx * (t - 20), oy + dy * (t - 20))) / 20); break; }
          }
        } else if (tz < -1e-6) {                                          // flat floor at this level
          double t = (hz - gz) / -tz;
          if (t < dWall && t < P.tofMaxRange) sHit = t;
        }
        if (sHit < 0) continue;
        double d3 = sHit / std::cos(elev), graze = std::fabs(std::sin(slope - elev));
        double w = P.tofFloorGain * profH * std::exp(-vOff * vOff / (2 * sigma * sigma)) * graze / std::max(d3 * d3, 100.0);
        sumW += w; sumWD += w * d3;
      }
    }
  }
  // too little light back (only far or grazing surfaces) = out of range
  if (sumW < sumProfile / (P.tofMaxRange * P.tofMaxRange)) return tofLast[code] = 8190;
  double dist = sumWD / sumW;
  // below ~30 mm the VL53L0X can't measure properly (team notes); it reads about its minimum, never less
  if (dist < P.tofMinReliableMm) dist = P.tofMinReliableMm + std::fabs(gauss(5));
  double d = dist + s.offset + gauss(P.tofNoiseMm + P.tofNoisePct * dist);
  return tofLast[code] = (uint16_t)std::max(0.0, std::round(d));
}

bool Adafruit_TCS34725::begin() { simAdvance(3000); return true; }
void Adafruit_TCS34725::getRawData(uint16_t *r, uint16_t *g, uint16_t *b, uint16_t *c) {
  simAdvance((256 - (int)it_) * 2400.0 + 500); // integration time, like the real library
  double wx, wy;
  robotToWorld(colourFwd, colourLeft, wx, wy);
  int t = W.typeAt((int)std::floor(wx / field::TILE), (int)std::floor(wy / field::TILE));
  // raw counts at 24 ms / 1x gain (assumed; red > 800 is the code's silver test, clear ratio < 0.1 is black)
  double R = 600, G = 650, B = 600, C = 2000;              // white
  if (t == field::BLACK_T) { R = 40; G = 45; B = 40; C = 120; }
  if (t == field::BLUE_T) { R = 150; G = 220; B = 520; C = 900; }
  if (t == field::SILVER_T) { R = 1100; G = 1150; B = 1100; C = 3500; }
  // the grey tile on the robot (bench test 9, 2026-10-06, 3 runs): r 281 g 413 b 492 c 1181 against white c 2610, here
  // scaled to this model's white (C 2000): clear 0.45 of white, blue/red 1.75
  if (t == field::SILVER_T && P.greyCheckpoints > 0) { R = 215; G = 316; B = 377; C = 905; }
  double maxCount = std::min(65535.0, (256 - (int)it_) * 1024.0); // AMS datasheet: max RGBC count
  auto noisy = [maxCount](double v) { return (uint16_t)std::min(maxCount, std::max(0.0, std::round(v * (1 + gauss(P.colourNoise))))); };
  *r = noisy(R); *g = noisy(G); *b = noisy(B); *c = noisy(C);
}

void Adafruit_DCMotor::run(uint8_t cmd) { mot[num].dir = cmd; simAdvance(250); }
void Adafruit_DCMotor::setSpeed(uint8_t s) { mot[num].pwm = s; simAdvance(250); }
bool Adafruit_MotorShield::begin(uint16_t, TwoWire *) { return true; }
Adafruit_DCMotor *Adafruit_MotorShield::getMotor(uint8_t n) {
  static Adafruit_DCMotor m[5];
  m[n].num = n;
  return &m[n];
}

static int bnoMode = OPERATION_MODE_NDOF;
bool Adafruit_BNO055::begin(adafruit_bno055_opmode_t mode) { bnoMode = mode; simAdvance(20000); return true; }
void Adafruit_BNO055::setMode(adafruit_bno055_opmode_t mode) { bnoMode = mode; }
static double magOffsetDeg = 0;                // maze "north" vs magnetic north
static double gyroZeroDeg = 0;                // testGyroZero: heading the robot was switched on at (IMUPLUS reads 0 there)
static double magPhase[4] = {0, 0, 0, 0};      // where the heading error from local magnetic distortion peaks
static bool magneticMode() {                   // NDOF, NDOF_FMC_OFF, COMPASS, M4G use the magnetometer for heading
  if (P.gyroMagnetic >= 0) return P.gyroMagnetic > 0;
  return bnoMode == OPERATION_MODE_NDOF || bnoMode == OPERATION_MODE_NDOF_FMC_OFF || bnoMode == OPERATION_MODE_COMPASS || bnoMode == OPERATION_MODE_M4G;
}
// The BNO055's fusion output updates at 100 Hz (datasheet, "Fusion" output data rate): reads within one 10 ms period
// return the same sample, so averaging back-to-back reads averages one value. Before 2026-10-19 each read here was a
// fresh sample with fresh noise.
static double bnoSampleUs = -1e18, bnoHeading = 0, bnoPitch = 0;
bool Adafruit_BNO055::getEvent(sensors_event_t *e) {
  simAdvance(900);
  if (tUs - bnoSampleUs >= 10000) {
    bnoSampleUs = std::floor(tUs / 10000) * 10000;
    bool magnetic = magneticMode() && (runStarted ? (tUs - runStartUs) / 1e6 >= P.gyroMagneticAfterS : P.gyroMagneticAfterS <= 0);
    // magnetic heading: no gyro drift, but the frame is magnetic north and local distortion bends it a little
    double magErr = P.magErrorDeg * std::sin(2 * M_PI * rx / 900 + magPhase[0]) * std::cos(2 * M_PI * ry / 1100 + magPhase[1]);
    bnoHeading = wrap360(rhead + (magnetic ? magOffsetDeg + magErr : gyroBiasDegPerUs * tUs - gyroZeroDeg) + gauss(P.gyroNoiseDeg));
    bnoPitch = rpitch + gauss(P.pitchNoiseDeg);
  }
  e->orientation.x = (float)bnoHeading;
  gyroLast = e->orientation.x;
  e->orientation.y = 0;
  e->orientation.z = (float)bnoPitch;
  return true;
}

size_t LiquidCrystal::print(const char *text) {
  simAdvance(2000);
  std::string s = text;
  if (stopClaimUs >= 0) {} // already handling a stop: repeats of its message change nothing
  else if (s.find("back to start") != std::string::npos) {
    if ((int)std::floor(rx / field::TILE) == W.sx && (int)std::floor(ry / field::TILE) == W.sy) throw SimEnd{"home"};
    stopClaim("stopped on the wrong tile", "home");
  }
  else if (s.find("no path found") != std::string::npos) stopClaim("no path home in its map", "no path");
  if (!s.empty() && s.find_first_not_of(' ') != std::string::npos) lcdText = s;
  return s.size();
}

// =====================================================================================
// Setup + run
// =====================================================================================
void setup();
void loop();

static bool loadGeometry(const std::string &path) {
  std::ifstream f(path);
  if (!f) return false;
  std::stringstream ss; ss << f.rdbuf();
  std::string js = ss.str();
  auto num = [&](const std::string &obj, const char *key) {
    size_t p = obj.find(std::string("\"") + key + "\"");
    return p == std::string::npos ? 0.0 : std::atof(obj.c_str() + obj.find(':', p) + 1);
  };
  size_t pos = js.find("\"sensors\"");
  int found = 0;
  while (true) {
    size_t a = js.find('{', pos), b = js.find('}', a);
    if (a == std::string::npos || a > js.find(']', pos)) break;
    std::string obj = js.substr(a, b - a);
    int code = (int)num(obj, "code_sensor");
    if (code >= 1 && code <= 7) {
      TofSensor &s = tof[code];
      s.fwd = num(obj, "forward_mm"); s.left = num(obj, "left_mm"); s.height = num(obj, "height_mm"); s.ok = true;
      s.facing = obj.find("\"forward\"") != std::string::npos ? 0 : obj.find("\"right\"") != std::string::npos ? 1
               : obj.find("\"backward\"") != std::string::npos ? 2 : 3;
      found++;
    }
    pos = b;
  }
  size_t c = js.find("\"colour_sensor\"");
  if (c != std::string::npos) { std::string obj = js.substr(c, js.find('}', c) - c); colourFwd = num(obj, "forward_mm"); colourLeft = num(obj, "left_mm"); colourHeight = num(obj, "height_mm"); }
  size_t ax = js.find("\"axles_forward_mm\"");
  if (ax != std::string::npos) axleOffset = std::fabs(std::atof(js.c_str() + js.find('[', ax) + 1));
  // body outline = the outer faces of the distance sensors (boards are 1.3 mm thick)
  bodyFront = bodyBack = bodyHalfWidth = 0;
  for (int i = 1; i <= 7; i++) {
    bodyFront = std::max(bodyFront, tof[i].fwd + 0.7);
    bodyBack = std::max(bodyBack, -tof[i].fwd + 0.7);
    bodyHalfWidth = std::max(bodyHalfWidth, std::fabs(tof[i].left) + 0.7);
  }
  // the real outline (all parts that can touch a wall), if the geometry file has it
  outF.clear(); outL.clear();
  size_t o = js.find("\"outline_mm\"");
  if (o != std::string::npos) {
    size_t a = js.find('[', o), b = a;
    for (int depth = 0; b < js.size(); b++) { // the matching ']' (the list spans many lines)
      if (js[b] == '[') depth++;
      else if (js[b] == ']' && --depth == 0) break;
    }
    std::string arr = js.substr(a, b - a + 1);
    std::vector<double> v;
    for (size_t i = 0; i < arr.size();) {
      if (arr[i] == '-' || (arr[i] >= '0' && arr[i] <= '9')) { char *e; v.push_back(std::strtod(arr.c_str() + i, &e)); i = e - arr.c_str(); }
      else i++;
    }
    for (size_t i = 0; i + 1 < v.size(); i += 2) { outF.push_back(v[i]); outL.push_back(v[i + 1]); }
  }
  if (outF.size() < 3) { // no outline: the box around the sensors
    outF = {bodyFront, bodyFront, -bodyBack, -bodyBack};
    outL = {-bodyHalfWidth, bodyHalfWidth, bodyHalfWidth, -bodyHalfWidth};
  }
  outlineRadius = 0;
  bodyFront = bodyBack = bodyHalfWidth = 0;
  for (size_t i = 0; i < outF.size(); i++) {
    outlineRadius = std::max(outlineRadius, std::hypot(outF[i], outL[i]));
    bodyFront = std::max(bodyFront, outF[i]); bodyBack = std::max(bodyBack, -outF[i]);
    bodyHalfWidth = std::max(bodyHalfWidth, std::fabs(outL[i]));
  }
  return found == 7;
}

// --selftest: fixed experiments with the simulated hardware, through the robot's own functions.
// The same tests on the real robot (see README) show which assumptions in Params need changing.
int measure(int sensor);
void fwd(double dist);
static int selfTest() {
  // 3 x 3 field; middle tile walled on N, E and W, open to the south
  W = field::World();
  W.W = 3; W.H = 3;
  W.wall.assign(9, {{false, false, false, false}});
  W.type.assign(9, field::FLOOR); W.level.assign(9, 0);
  for (int y = 0; y < 3; y++) for (int x = 0; x < 3; x++) for (int d = 0; d < 4; d++) {
    int nx = x + field::DX[d], ny = y + field::DY[d];
    if (!W.in(nx, ny)) W.wall[W.id(x, y)][d] = true;
  }
  for (int d : {0, 1, 3}) { int nx = 1 + field::DX[d], ny = 1 + field::DY[d]; W.wall[W.id(1, 1)][d] = true; W.wall[W.id(nx, ny)][(d + 2) % 4] = true; }
  W.sx = 1; W.sy = 1;
  indexObstacles();
  simReady = true;
  auto place = [](double x, double y, double h) { rx = x; ry = y; rhead = h; for (int i = 1; i <= 4; i++) mot[i].speed = 0; };
  place(450, 450, 0);
  std::printf("SENSORS (robot centred in a tile, walls front/left/right, open behind)\n");
  const char *where[8] = {"", "front-right", "right-front", "right-back", "back", "left-back", "left-front", "front-left"};
  for (int i = 1; i <= 7; i++) {
    double sum = 0; int n = 20;
    for (int k = 0; k < n; k++) sum += measure(i);
    std::printf("  measure(%d) %-11s %6.1f mm\n", i, where[i], sum / n);
  }
  std::printf("  code expects (centred): side %.0f mm, front %.0f mm\n", (300.0 - 140) / 2, (300.0 - 170) / 2);

  std::printf("DRIVE drivetrain.fw(150) for 2 s from rest, then fullstop (open floor)\n");
  W.wall.assign(9, {{false, false, false, false}});
  for (int y = 0; y < 3; y++) for (int x = 0; x < 3; x++) for (int d = 0; d < 4; d++)
    if (!W.in(x + field::DX[d], y + field::DY[d])) W.wall[W.id(x, y)][d] = true;
  W.H = 3; place(450, 120, 0);
  drivetrain.reset_encoderCount(true, true, true);
  double y0 = ry;
  drivetrain.fw(150); delay(2000); drivetrain.fullstop(); delay(500);
  int enc = (drivetrain.encoderCountA + drivetrain.encoderCountB + drivetrain.encoderCountD) / 3;
  std::printf("  moved %.0f mm, encoders A/B/D %d/%d/%d, %.4f mm per count (code assumes %.4f = 5 x 195 counts per wheel turn)\n", ry - y0,
              (int)drivetrain.encoderCountA, (int)drivetrain.encoderCountB, (int)drivetrain.encoderCountD, (ry - y0) / std::max(1, enc),
              M_PI * wheel_diameter / (wheel_cpr * gear_ratio));
  for (int pwm : {20, 30, 60, 90, 120, 150}) {
    place(450, 120, 0); drivetrain.fw(pwm); delay(1500); double a = ry; delay(1000); double v = ry - a; drivetrain.fullstop(); delay(500);
    std::printf("  fw(%3d): %5.0f mm/s\n", pwm, v);
  }
  std::printf("TURN drivetrain.turnright(pwm), turn rate after 1 s, centred in a tile\n");
  for (int pwm : {20, 30, 40, 60, 90, 150}) {
    place(450, 450, 0);
    double unwrapped = 0, last = rhead;
    drivetrain.turnright(pwm);
    for (int k = 0; k < 200; k++) {
      delay(10); double d = rhead - last; if (d < -180) d += 360; if (d > 180) d -= 360;
      if (k >= 100) unwrapped += d;
      last = rhead;
    }
    drivetrain.fullstop(); delay(500);
    std::printf("  turnright(%3d): %5.0f deg/s\n", pwm, unwrapped);
  }
  // The robot's bench mode (Main/bench.cpp) tests 2-4, with the same steps and the same pass rules, so the
  // numbers compare one to one with the [BENCH] lines from the real robot.
  std::printf("BENCH (as Main/bench.cpp)\n");
  {
    place(450, 450, 0);
    int found = -1;
    for (int pwm = 20; pwm <= 150 && found < 0; pwm += 5) {
      double h0 = rhead;
      drivetrain.turnright(pwm); delay(1000); drivetrain.fullstop(); delay(300);
      double moved = rhead - h0; if (moved > 180) moved -= 360; if (moved < -180) moved += 360;
      if (std::fabs(moved) > 5.0) found = pwm;
    }
    std::printf("  2 lowest PWM that turns it on the spot: %d\n", found);
    place(450, 450, 0);
    double total = 0, last = rhead;
    drivetrain.turnright(150);
    for (int k = 0; k < 100; k++) { delay(10); double d = rhead - last; if (d < -180) d += 360; if (d > 180) d -= 360; total += d; last = rhead; }
    drivetrain.fullstop(); delay(500);
    std::printf("  3 turnright(150) for 1 s: %.1f deg\n", total);
    found = -1;
    for (int pwm = 5; pwm <= 150 && found < 0; pwm += (pwm < 60 ? 2 : 10)) {
      place(450, 120, 0);
      drivetrain.reset_encoderCount(true, true, true);
      drivetrain.fw(pwm); delay(1000); drivetrain.fullstop(); delay(300);
      if (drivetrain.encoderCountA > 10 && drivetrain.encoderCountB > 10 && drivetrain.encoderCountD > 10) found = pwm;
    }
    std::printf("  4 lowest PWM that drives all three encoder wheels forward: %d\n", found);
  }
  {
    double V = P.batteryVoltage, stallNm = P.stallKgcmAt12V * V / 12.0 * 0.0980665 * motorOhms() / (motorOhms() + P.driverOhms), rM = P.wheelDiameter / 2000.0;
    double fr = P.frictionFracAt12V * 12.0 / V, spin = P.wheelMu * P.robotMassKg * 9.81 / 4 * (axleOffset / (P.trackWidth / 2)) * rM / stallNm;
    std::printf("MODEL at %.1f V: top speed %.0f mm/s; lowest PWM that moves it straight %.0f (from standstill %.0f); "
                "lowest PWM that turns it on the spot %.0f\n", V, P.noLoadRpmAt12V * V / 12 / 60 * M_PI * P.wheelDiameter,
                255 * fr, 255 * fr * P.stictionFactor, 255 * (fr + spin) * P.stictionFactor);
  }
  {
    // Move test M3 (Main/bench.cpp, robot-test): fwd(300) three times from rest on open floor, a wall right behind;
    // the real distance driven each time and what the back sensor says (robot 2026-10-16/17, first move: 297-326 mm).
    W = field::World();
    W.W = 3; W.H = 6;
    W.wall.assign(18, {{false, false, false, false}});
    W.type.assign(18, field::FLOOR); W.level.assign(18, 0);
    for (int y = 0; y < 6; y++) for (int x = 0; x < 3; x++) for (int d = 0; d < 4; d++)
      if (!W.in(x + field::DX[d], y + field::DY[d])) W.wall[W.id(x, y)][d] = true;
    W.sx = 1; W.sy = 0;
    indexObstacles();
    auto back = []() { double s = 0; int n = 0; for (int k = 0; k < 5; k++) { int v = measure(4); if (v > 0 && v < 1500) { s += v; n++; } } return n ? s / n : -1.0; };
    for (int run = 0; run < 3; run++) {
      place(450, 150 + 4 * (run - 1), 0); delay(500);
      double y0 = ry, b0 = back();
      std::printf("  M3 run %d start: back sensor %.0f mm\n", run + 1, b0);
      for (int i = 1; i <= 3; i++) {
        double ys = ry, bs = back();
        unsigned long t0 = millis();
        fwd(300);
        double secs = (millis() - t0) / 1000.0;
        delay(300);
        double b = back();
        std::printf("  M3 move %d: %.2f s, really moved %.0f mm, back sensor says %.0f mm (encoder target 300)\n", i, secs, ry - ys, b - bs);
        delay(2000);
      }
      (void)y0;
    }
    // Move test M7: wheel speeds from the encoders, as Main/bench.cpp does it (robot 2026-10-18, wheels in the air:
    // fw(150) A/B/D 67/66/89 RPM, fw(255) 118/139/150). The sim has no rolling load, so driving on the floor is the same.
    {
      W = field::World();
      W.W = 7; W.H = 7;
      W.wall.assign(49, {{false, false, false, false}});
      W.type.assign(49, field::FLOOR); W.level.assign(49, 0);
      for (int y = 0; y < 7; y++) for (int x = 0; x < 7; x++) for (int d = 0; d < 4; d++)
        if (!W.in(x + field::DX[d], y + field::DY[d])) W.wall[W.id(x, y)][d] = true;
      indexObstacles();
      for (int pwm : {150, 255}) {
        place(1050, 200, 0);
        drivetrain.fw(pwm); delay(700);
        drivetrain.reset_encoderCount(true, true, true);
        delay(1000);
        double a = drivetrain.encoderCountA, b = drivetrain.encoderCountB, d = drivetrain.encoderCountD;
        drivetrain.fullstop(); delay(500);
        std::printf("  M7 fw(%d): RPM A/B/D %.0f/%.0f/%.0f (robot %s)\n", pwm, a / 975 * 60, b / 975 * 60, d / 975 * 60,
                    pwm == 150 ? "67/66/89" : "118/139/150");
      }
    }
    // Move test M0 on open floor: what each sensor reads with no wall near (robot: back 170-540 or 8190, front ~690
    // or 8190, sides ~470-760; logs/2026-10-16 move_tests2, 2026-10-17 sensor_check, ramp_sensors).
    {
      W = field::World();
      W.W = 7; W.H = 7;
      W.wall.assign(49, {{false, false, false, false}});
      W.type.assign(49, field::FLOOR); W.level.assign(49, 0);
      for (int y = 0; y < 7; y++) for (int x = 0; x < 7; x++) for (int d = 0; d < 4; d++)
        if (!W.in(x + field::DX[d], y + field::DY[d])) W.wall[W.id(x, y)][d] = true;
      indexObstacles();
      place(1050, 1050, 0); delay(300);
      const char *nm[8] = {"", "front-right", "right-front", "right-back", "back", "left-back", "left-front", "front-left"};
      std::printf("  M0 open floor (walls 900+ mm away):");
      for (int i = 1; i <= 7; i++) { std::printf(" %s", nm[i]); for (int k = 0; k < 3; k++) std::printf(" %d", measure(i)); std::printf(";"); }
      std::printf("\n");
      place(450, 1050, 0); delay(300); // west wall 450 mm from the middle: one tile out for the left sensors (CAD 359)
      int lf1 = measure(6), lf2 = measure(6), lb1 = measure(5), lb2 = measure(5);
      std::printf("  M0 wall one tile out on the left: left-front %d %d, left-back %d %d (CAD 359 + offset; robot's right side peaks at 375-400)\n", lf1, lf2, lb1, lb2);
    }
    // Move tests M6 / M8: a box (fixed, 9 cm across) in the middle of the path, its front D mm ahead of the robot, a wall at
    // the far end of the next tile. The no-progress check must stop the move and back up (the box sits between the front
    // sensors' beams). With --verbose the firmware's own lines show what happened.
    for (double gap : {100.0, 150.0, 200.0, 250.0}) {
      W = field::World();
      W.W = 3; W.H = 4;
      W.wall.assign(12, {{false, false, false, false}});
      W.type.assign(12, field::FLOOR); W.level.assign(12, 0);
      for (int y = 0; y < 4; y++) for (int x = 0; x < 3; x++) for (int d = 0; d < 4; d++)
        if (!W.in(x + field::DX[d], y + field::DY[d])) W.wall[W.id(x, y)][d] = true;
      W.wall[W.id(1, 1)][0] = true; W.wall[W.id(1, 2)][2] = true;      // wall at the far end of the next tile (y = 600)
      double front = 150 + bodyFront;
      W.obstacles = {{450, front + gap + 45, 45}};
      indexObstacles();
      place(450, 150, 0); delay(300);
      std::printf("  M8 box %.0f mm ahead: start\n", gap);
      fwd(300);
      delay(300);
      std::printf("  M8 box %.0f mm ahead: ended %.0f mm from the start (box front at %.0f)\n", gap, ry - 150, gap);
    }
    W.obstacles.clear(); indexObstacles();
    // Move test M1: absoluteturn() 90 deg right, then left, from rest in the middle of a tile (robot 2026-10-16:
    // right 0.97-1.01 s, left 0.76-0.80 s, all within 2 deg).
    for (int k = 0; k < 2; k++) {
      place(450, 450, 0); delay(500);
      double h0 = myGyro.heading();
      unsigned long t0 = millis();
      absoluteturn(std::fmod(h0 + (k == 0 ? 90 : 270), 360));
      double secs = (millis() - t0) / 1000.0;
      delay(500);
      double turned = myGyro.heading() - h0; if (turned > 180) turned -= 360; if (turned < -180) turned += 360;
      std::printf("  M1 %s 90: %.2f s, turned %.1f deg\n", k == 0 ? "right" : "left", secs, turned);
    }
  }
  std::printf("COLOUR raw r g b c over each tile type\n");
  const char *names[] = {"white", "black", "blue", "silver"};
  int types[] = {field::FLOOR, field::BLACK_T, field::BLUE_T, field::SILVER_T};
  for (int k = 0; k < 4; k++) {
    W.type.assign(9, types[k]); uint16_t r, g, b, c; tcs.getRawData(&r, &g, &b, &c);
    std::printf("  %-6s %5u %5u %5u %5u\n", names[k], r, g, b, c);
  }
  return 0;
}

// --scenario t2 / t3 / t6 / t7: the maze tests of TEST_PRIORITY.md (2026-10-19) on small fixed fields, set up as written
// there (details: ROBOT_TEST.md 1 a-e on robot-test). The robot starts on (1, 0) facing north; the seed varies the obstacle's
// size (obstacleRMinMm..obstacleRMaxMm, 5-9 cm) and side, and the placement (placeSigmaMm / placeSigmaDeg).
static const field::Scenario TEST_FIELDS[] = {{"t2", 3, 3, 3, 3, 0, 0, 0, 0, 0}, {"t3", 3, 3, 3, 3, 0, 0, 0, 0, 0},
                                              {"t6", 3, 3, 3, 3, 0, 0, 0, 0, 0}, {"t7", 3, 3, 4, 4, 0, 0, 0, 0, 0}};
static void testField(const std::string &name, std::mt19937 &frng) {
  const double T = field::TILE;
  int w = 3, h = name == "t7" ? 4 : 3;
  W = field::World();
  W.W = w; W.H = h; W.sx = 1; W.sy = 0;
  W.wall.assign(w * h, {{false, false, false, false}});
  W.type.assign(w * h, field::FLOOR); W.level.assign(w * h, 0); W.bump.assign(w * h, 0);
  for (int y = 0; y < h; y++) for (int x = 0; x < w; x++) for (int d = 0; d < 4; d++)
    if (!W.in(x + field::DX[d], y + field::DY[d])) W.wall[W.id(x, y)][d] = true;
  auto wall = [](int x, int y, int d) {
    W.wall[W.id(x, y)][d] = true;
    int nx = x + field::DX[d], ny = y + field::DY[d];
    if (W.in(nx, ny)) W.wall[W.id(nx, ny)][(d + 2) % 4] = true;
  };
  std::uniform_real_distribution<double> u(0, 1);
  double r = P.obstacleRMinMm + (P.obstacleRMaxMm - P.obstacleRMinMm) * u(frng);
  int side = u(frng) < 0.5 || P.testWide > 0 ? 1 : -1; // touching the east (1) or west (-1) wall
  // an obstacle touching the side wall of tile (x, y), its centre `along` mm into the tile from its south edge (RCJ 3.4.4:
  // at most 10 cm into the path)
  auto obstacle = [&](int x, int y, double along) {
    double face = side > 0 ? (x + 1) * T - P.wallThicknessMm / 2 : x * T + P.wallThicknessMm / 2;
    W.obstacles.push_back({face - side * r, y * T + along, r});
  };
  auto alongFor = [&](int pos) { return pos == 0 ? r + 10 : pos == 1 ? T / 2 : T - r - 10; };
  if (name == "t2") {        // 1 b: obstacle in the walled tile ahead; the start is open to the east, so there is somewhere else to go
    wall(1, 0, 3); wall(1, 1, 1); wall(1, 1, 3);
    obstacle(1, 1, alongFor((int)P.testPos));
  } else if (name == "t3") { // 1 a: start open on its left (west), the tile ahead walled on its left; no obstacle
    wall(1, 0, 1); wall(1, 1, 3);
  } else if (name == "t6") { // 1 c: start in a dead end; the only way out passes the obstacle
    wall(1, 0, 1); wall(1, 0, 3); wall(1, 1, 1); if (P.testWide <= 0) wall(1, 1, 3);
    obstacle(1, 1, alongFor((int)P.testPos));
  } else if (name == "t7") { // 1 e: blue tile ahead, obstacle in the first half of it (testPos 0) or of the tile after it (1)
    wall(1, 0, 3); wall(1, 1, 1); wall(1, 1, 3); wall(1, 2, 1); wall(1, 2, 3);
    W.type[W.id(1, 1)] = field::BLUE_T;
    obstacle(1, P.testPos > 0 ? 2 : 1, r + 10 + (T / 2 - r - 10) * u(frng));
  }
}

// --scenario <file>.txt: a real field drawn as text (tools/sim/physics/fields/README.md has the format). The file is looked
// for as given, then in fields/ next to the simulator. Returns "" or what is wrong with the file.
static double mapRampDeg = -1; // from a "ramp_deg" line; otherwise drawn from rampMinDeg..rampMaxDeg
static std::string mapField(const std::string &path, const std::string &exeDir, std::mt19937 &frng, double &startHead) {
  std::ifstream f(path);
  for (const std::string &dir : {exeDir + "/", exeDir + "/fields/", exeDir + "/../", exeDir + "/../fields/"})
    if (!f) { f.clear(); f.open(dir + path); }
  if (!f) return "cannot open " + path;
  std::vector<std::string> g;
  std::string line;
  bool drawn = false; // the drawing ends at the first blank line after it
  while (std::getline(f, line)) {
    if (!line.empty() && line.back() == '\r') line.pop_back();
    std::istringstream ls(line);
    std::string key;
    ls >> key;
    if (key.empty()) { drawn = drawn || !g.empty(); continue; }
    if (key[0] == '#') continue;
    if (key == "ramp_deg") { ls >> mapRampDeg; continue; }
    if (key == "tile_mm") { ls >> field::TILE; continue; } // the field's tile pitch (a --set tileMm= on the command line is overridden)
    if (!drawn && (line[0] == '+' || !g.empty())) g.push_back(line);
  }
  if (g.size() < 3 || g.size() % 2 == 0 || g[0][0] != '+') return "the drawing must start and end with a +---+ line";
  int w = (int)(g[0].size() - 1) / 4, h = (int)(g.size() - 1) / 2;
  for (std::string &s : g) s.resize(4 * w + 1, ' ');
  W = field::World();
  W.W = w; W.H = h;
  W.wall.assign(w * h, {{false, false, false, false}});
  W.type.assign(w * h, field::FLOOR); W.level.assign(w * h, 0); W.bump.assign(w * h, 0);
  bool start = false;
  int rx0 = w, rx1 = -1;
  std::uniform_real_distribution<double> u(0, 1);
  for (int r = 0; r < h; r++) {
    int y = h - 1 - r; // first drawn row is the north edge
    const std::string &north = g[2 * r], &cells = g[2 * r + 1], &south = g[2 * r + 2];
    for (int x = 0; x < w; x++) {
      int i = W.id(x, y);
      W.wall[i][0] = north[4 * x + 2] == '-';
      W.wall[i][2] = south[4 * x + 2] == '-';
      W.wall[i][3] = cells[4 * x] == '|';
      W.wall[i][1] = cells[4 * x + 4] == '|';
      char c0 = cells[4 * x + 1], c1 = cells[4 * x + 2], c2 = cells[4 * x + 3];
      switch (c0) {
        case ' ': case '.': break;
        case 'S': start = true; W.sx = x; W.sy = y;
                  startHead = c2 == '>' ? 90 : c2 == 'v' ? 180 : c2 == '<' ? 270 : 0; break;
        case 'B': W.type[i] = field::BLUE_T; break;
        case 'K': W.type[i] = field::BLACK_T; break;
        case 'C': W.type[i] = field::SILVER_T; break;
        case 'R': W.type[i] = field::RAMP_T; rx0 = std::min(rx0, x); rx1 = std::max(rx1, x); break;
        case 'X': W.type[i] = field::SOLID_T; break;
        default: return std::string("unknown tile '") + c0 + "' in row " + std::to_string(r + 1);
      }
      if (c1 == '1') W.level[i] = 1;
      if (c0 != 'S' && c2 == '=') W.bump[i] = 1;      // strip running east-west (crossed going north or south)
      if (c0 != 'S' && c2 == 'I') W.bump[i] = 2;      // strip running north-south
      if (c0 != 'S' && c2 == 'o') {                   // obstacle in the open, size and exact place from the seed
        double rr = P.obstacleRMinMm + (P.obstacleRMaxMm - P.obstacleRMinMm) * u(frng);
        W.obstacles.push_back({(x + 0.4 + 0.2 * u(frng)) * field::TILE, (y + 0.4 + 0.2 * u(frng)) * field::TILE, rr});
      }
    }
  }
  if (!start) return "no start tile (S)";
  for (int i = 0; i < w * h; i++) if (W.type[i] == field::SOLID_T) // outside the field: closed on every side
    for (int d = 0; d < 4; d++) {
      W.wall[i][d] = true;
      int nx = i % w + field::DX[d], ny = i / w + field::DY[d];
      if (W.in(nx, ny)) W.wall[W.id(nx, ny)][(d + 2) % 4] = true;
    }
  for (int i = 0; i < w * h; i++) for (int d = 0; d < 4; d++) { // a wall drawn on one side is on both
    int nx = i % w + field::DX[d], ny = i / w + field::DY[d];
    if (W.wall[i][d] && W.in(nx, ny)) W.wall[W.id(nx, ny)][(d + 2) % 4] = true;
  }
  if (rx1 >= 0) { // one-tile ramps, any way round: a level-0 tile at one end, a level-1 tile at the other
    W.rampUp.assign(w * h, -1);
    for (int i = 0; i < w * h; i++) {
      if (W.type[i] != field::RAMP_T) continue;
      int x = i % w, y = i / w;
      for (int d = 0; d < 4; d++) {
        int ux = x + field::DX[d], uy = y + field::DY[d], lx = x - field::DX[d], ly = y - field::DY[d];
        if (W.in(ux, uy) && W.in(lx, ly) && W.type[W.id(ux, uy)] != field::RAMP_T && W.type[W.id(lx, ly)] != field::RAMP_T &&
            W.level[W.id(ux, uy)] == 1 && W.level[W.id(lx, ly)] == 0) W.rampUp[i] = d;
      }
      if (W.rampUp[i] < 0)
        return "the ramp at row " + std::to_string(h - y) + " column " + std::to_string(x + 1) + " needs a level-0 tile at one end and a level-1 tile at the other";
    }
    W.rampX0 = rx0; W.rampLen = 1; // only for the replay viewer's colours
    W.rampDeg = mapRampDeg > 0 ? mapRampDeg : P.rampMinDeg + (P.rampMaxDeg - P.rampMinDeg) * u(frng);
    W.levelHeight[1] = field::TILE * std::tan(W.rampDeg * M_PI / 180.0);
  }
  W.bumpH = P.bumpHeightMm;
  return "";
}

int main(int argc, char **argv) {
  std::string scenario = "loops", tracePath, geomPath;
  long seed = 1;
  bool ideal = false, selftest = false;
  std::vector<std::string> sets;
  for (int i = 1; i < argc; i++) {
    std::string a = argv[i];
    if (a == "--scenario" && i + 1 < argc) scenario = argv[++i];
    else if (a == "--seed" && i + 1 < argc) seed = std::atol(argv[++i]);
    else if (a == "--ideal") ideal = true;
    else if (a == "--verbose") { simSerialEcho = true; std::setvbuf(stdout, nullptr, _IONBF, 0); } // unbuffered: nothing lost if the firmware crashes
    else if (a == "--trace" && i + 1 < argc) tracePath = argv[++i];
    else if (a == "--live") live = true;
    else if (a == "--live-speed" && i + 1 < argc) liveSpeed = std::atof(argv[++i]);
    else if (a == "--geometry" && i + 1 < argc) geomPath = argv[++i];
    else if (a == "--set" && i + 1 < argc) sets.push_back(argv[++i]);
    else if (a == "--selftest") selftest = true;
    else if (a == "--params") {
      std::printf("{");
      bool first = true;
      for (const auto &kv : paramTable()) { std::printf("%s\"%s\":%g", first ? "" : ",", kv.first.c_str(), *kv.second); first = false; }
      std::printf("}\n");
      return 0;
    }
    else { std::printf("usage: physics --scenario flat|loops|big|ramp|bigramp|comp --seed S [--ideal] [--set name=value]... [--verbose] [--trace FILE] [--geometry robot_geometry.json]\n"); return 2; }
  }
  if (geomPath.empty()) {
    std::string exe = argv[0];
    size_t slash = exe.find_last_of("/\\");
    geomPath = (slash == std::string::npos ? std::string(".") : exe.substr(0, slash)) + "/../cad/robot_geometry.json";
  }
  if (!loadGeometry(geomPath)) { std::printf("{\"error\":\"could not read 7 sensors from %s\"}\n", geomPath.c_str()); return 2; }
  if (ideal) makeIdeal();
  if (scenario == "comp") P.bumpRate = 0.12; // the 2025 international fields had 2-13 speed-bump tiles (about 6 in 48)
  for (const std::string &s : sets)
    if (!setParam(s)) { std::printf("{\"error\":\"unknown --set %s\"}\n", s.c_str()); return 2; }
  if (selftest) {
    rng.seed(1);
    for (int i = 1; i <= 4; i++) { mot[i].gain = 1 + gauss(P.motorGainSigma); mot[i].traction = P.tractionMean; }
    for (int i = 1; i <= 7; i++) tof[i].offset = P.tofOffsetMeanMm + gauss(P.tofOffsetSigma);
    tof[5].offset += P.tofLeftBackExtraMm;
    for (int i = 1; i <= 7; i++) tof[i].offset += P.tofExtraMm[i];
    return selfTest();
  }

  const field::Scenario *sc = nullptr;
  for (const auto &s : field::SCENARIOS) if (scenario == s.name) sc = &s;
  bool isTest = false;
  for (const auto &s : TEST_FIELDS) if (scenario == s.name) { sc = &s; isTest = true; }
  bool isMap = scenario.size() > 4 && scenario.compare(scenario.size() - 4, 4, ".txt") == 0;
  static std::string mapName;
  static field::Scenario mapSc = {"", 0, 0, 0, 0, 0, 0, 0, 0, 0};
  if (isMap) { // the result and trace name the field by its file name
    size_t s = scenario.find_last_of("/\\");
    mapName = scenario.substr(s == std::string::npos ? 0 : s + 1);
    mapName.resize(mapName.size() - 4);
    mapSc.name = mapName.c_str();
    sc = &mapSc;
  }
  if (!sc) { std::printf("{\"error\":\"unknown scenario %s\"}\n", scenario.c_str()); return 2; }
  std::mt19937 fieldRng((unsigned)seed * 2654435761u + (unsigned)(isTest ? 100 + (sc - TEST_FIELDS) : sc - field::SCENARIOS));
  field::Extras ex;
  field::TILE = P.tileMm;
  ex.wallT = P.wallThicknessMm; ex.obstacleRate = P.obstacleRate; ex.obstacleRMin = P.obstacleRMinMm; ex.obstacleRMax = P.obstacleRMaxMm; ex.bumpRate = P.bumpRate; ex.bumpH = P.bumpHeightMm;
  if (isMap) {
    std::string exe = argv[0];
    size_t slash = exe.find_last_of("/\\");
    std::string err = mapField(scenario, slash == std::string::npos ? "." : exe.substr(0, slash), fieldRng, mapStartHead);
    if (!err.empty()) { std::printf("{\"error\":\"%s: %s\"}\n", scenario.c_str(), err.c_str()); return 2; }
  }
  else if (isTest) testField(scenario, fieldRng);
  else W = field::generate(*sc, fieldRng, P.rampMinDeg, P.rampMaxDeg, ex);
  if (P.testNoCheckpoints > 0) for (int &t : W.type) if (t == field::SILVER_T) t = field::FLOOR;
  indexObstacles();
  rng.seed((unsigned)seed * 7919u + 4242u);
  if (P.obstacleMovableFrac > 0) { // which obstacles are loose and how heavy: own generator, the rest of the run is unchanged
    std::mt19937 orng((unsigned)seed * 104729u + 17u);
    std::uniform_real_distribution<double> u(0, 1);
    obstacleMass.assign(W.obstacles.size(), 0);
    for (double &m : obstacleMass)
      if (u(orng) < P.obstacleMovableFrac) m = P.obstacleMassMinKg + (P.obstacleMassMaxKg - P.obstacleMassMinKg) * u(orng);
  }

  for (int i = 1; i <= 4; i++) { mot[i].gain = 1 + gauss(P.motorGainSigma); mot[i].traction = P.tractionMean; }
  for (int i = 1; i <= 7; i++) { tof[i].offset = P.tofOffsetMeanMm + gauss(P.tofOffsetSigma); tof[i].phaseUs = std::uniform_real_distribution<double>(0, P.tofPeriodUs)(rng); }
  tof[5].offset += P.tofLeftBackExtraMm;
  for (int i = 1; i <= 7; i++) tof[i].offset += P.tofExtraMm[i];
  gyroBiasDegPerUs = gauss(P.gyroDriftSigmaDegPerMin) / 60e6;
  magOffsetDeg = P.gyroMagneticOffsetDeg >= 0 ? P.gyroMagneticOffsetDeg : std::uniform_real_distribution<double>(0, 360)(rng);
  for (double &ph : magPhase) ph = std::uniform_real_distribution<double>(0, 2 * M_PI)(rng);
  rx = (W.sx + 0.5) * field::TILE + gauss(P.placeSigmaMm);
  ry = (W.sy + 0.5) * field::TILE + gauss(P.placeSigmaMm);
  rhead = wrap360(mapStartHead + gauss(P.placeSigmaDeg));
  if (scenario == "t3") { rx -= P.testOffsetMm; rhead = wrap360(rhead - P.testTurnDeg); } // toward the open west side
  gyroZeroDeg = mapStartHead; // a map's start facing east, south or west: the gyro reads 0 along the start tile's grid
  if (P.testGyroZero > 0) gyroZeroDeg = rhead;
  cpX = W.sx; cpY = W.sy;
  visited.assign(W.W * W.H, false);
  blueVisits.assign(W.W * W.H, 0); blueGood.assign(W.W * W.H, 0); cpVisited.assign(W.W * W.H, false);
  if (!tracePath.empty() || live) {
    if (live) traceOut = &std::cout;
    else { traceFile.open(tracePath); traceOut = &traceFile; }
    *traceOut << "{\"scenario\":\"" << sc->name << "\",\"seed\":" << seed << ",\"ideal\":" << (ideal ? "true" : "false") << ",\"sets\":\"";
    for (const std::string &x : sets) *traceOut << jsonEsc(x) << " ";
    *traceOut << "\",\"robot\":{\"front\":" << bodyFront << ",\"back\":" << bodyBack << ",\"half\":" << bodyHalfWidth << ",\"axle\":" << axleOffset
          << ",\"track\":" << P.trackWidth << ",\"wheel\":" << P.wheelDiameter << ",\"colour\":[" << colourFwd << "," << colourLeft << "," << colourHeight << "],\"tof\":[";
    for (int i = 1; i <= 7; i++) *traceOut << (i > 1 ? "," : "") << "[" << tof[i].fwd << "," << tof[i].left << "," << tof[i].facing << "," << tof[i].height << "]";
    *traceOut << "],\"cone\":" << P.tofConeDeg << ",\"outline\":[";
    for (size_t k = 0; k < outF.size(); k++) *traceOut << (k ? "," : "") << "[" << outF[k] << "," << outL[k] << "]";
    *traceOut << "]},\"map\":{\"size\":" << MAP_SIZE << ",\"floors\":" << NUM_FLOORS << ",\"start\":" << START_FLOOR << "}";
    *traceOut << ",\"field\":{\"tile\":" << field::TILE << ",\"W\":" << W.W << ",\"H\":" << W.H << ",\"sx\":" << W.sx << ",\"sy\":" << W.sy << ",\"rampDeg\":" << W.rampDeg
          << ",\"rampX0\":" << W.rampX0 << ",\"rampLen\":" << W.rampLen << ",\"levelHeight\":[" << W.levelHeight[0] << "," << W.levelHeight[1] << "]"
          << ",\"wallT\":" << P.wallThicknessMm << ",\"bumpH\":" << W.bumpH << ",\"bumpW\":" << W.bumpW << ",\"obstacles\":[";
    for (size_t k = 0; k < W.obstacles.size(); k++) *traceOut << (k ? "," : "") << "[" << (int)W.obstacles[k].x << "," << (int)W.obstacles[k].y << "," << (int)W.obstacles[k].r << "]";
    *traceOut << "],\"obstacleKg\":[";
    for (size_t k = 0; k < obstacleMass.size(); k++) *traceOut << (k ? "," : "") << obstacleMass[k];
    *traceOut << "],\"bumps\":[";
    bool firstBump = true;
    for (int i = 0; i < W.W * W.H; i++) if (W.bump[i]) { *traceOut << (firstBump ? "" : ",") << "[" << i << "," << W.bump[i] << "]"; firstBump = false; }
    *traceOut << "],\"rampUp\":[";
    for (size_t k = 0; k < W.rampUp.size(); k++) *traceOut << (k ? "," : "") << W.rampUp[k];
    *traceOut << "],\"tiles\":[";
    for (int i = 0; i < W.W * W.H; i++) {
      int walls = 0;
      for (int d = 0; d < 4; d++) walls |= W.wall[i][d] << d;
      *traceOut << (i ? "," : "") << "[" << W.type[i] << "," << W.level[i] << "," << walls << "]";
    }
    *traceOut << "]}}\n";
  }

  std::string reason;
  simReady = true;
  try {
    setup();
    if (P.startPauseS > 0) { switchHigh = true; pauseUntilUs = tUs + P.startPauseS * 1e6; }
    runStarted = true;
    runStartUs = tUs;
    if (live) liveRebase();
    lastProgressUs = tUs;
    lastTileX = W.sx; lastTileY = W.sy;
    visited[W.id(W.sx, W.sy)] = true;
    curTile = W.id(W.sx, W.sy); lastStillX = rx; lastStillY = ry;
    lastLevel = W.level[W.id(W.sx, W.sy)];
    while (true) loop();
  } catch (const SimEnd &e) { reason = e.reason; }

  // ---- results ----
  int tx = (int)std::floor(rx / field::TILE), ty = (int)std::floor(ry / field::TILE);
  bool home = reason == "home" && tx == W.sx && ty == W.sy;
  std::vector<bool> reach = W.reach();
  int total = 0, covered = 0, wallsOk = 0, wallsAll = 0;
  syncActiveFloor();
  for (int i = 0; i < W.W * W.H; i++) {
    if (!reach[i] || W.type[i] == field::RAMP_T) continue;
    total++;
    if (!visited[i]) continue;
    covered++;
    int x = i % W.W, y = i / W.W, f = START_FLOOR + W.level[i] - W.level[W.id(W.sx, W.sy)];
    if (f < 0 || f >= NUM_FLOORS) continue;
    Tile &t = floorGrid(f)[x - W.sx + MAP_SIZE / 2][y - W.sy + MAP_SIZE / 2];
    for (int d = 0; d < 4; d++) { wallsAll++; if (t.getVisited() && t.getWall(d) == W.hasWall(x, y, d)) wallsOk++; }
  }
  double runS = runStarted ? (tUs - runStartUs) / 1e6 : 0;
  // RCJ 2026 scoring, navigation part (no victims or rescue kits in the simulator)
  int sbv = 0, bluePts = 0, checkpoints = 0;
  for (int i = 0; i < W.W * W.H; i++) {
    if (blueGood[i] > 0) { sbv++; bluePts += std::max(0, 30 - 10 * (blueVisits[i] - 1)); } // 5.6.6: revisits cost 10 each
    if (cpVisited[i]) checkpoints++;
  }
  int srn = (int)rampsDone.size(), bumpsCrossed = (int)bumpsDone.size();
  int reliability = std::max(0, sbv * 10 - lops * 15);          // 5.6.7
  int exitBonus = home ? sbv * 10 + srn * 5 : 0;                // 5.6.12
  int score = bluePts + checkpoints * 10 + srn * 10 + bumpsCrossed * 5 + reliability + exitBonus; // 5.6.8: 5 per speed-bump tile
  std::vector<char> resultBuf(1024 + lopReasons.size() + 2 * lcdText.size()); // a run with many restarts has a long list of reasons
  char *result = resultBuf.data();
  std::snprintf(result, resultBuf.size(), "{\"scenario\":\"%s\",\"seed\":%ld,\"ideal\":%s,\"end\":\"%s\",\"home\":%s,\"time_s\":%.1f,\"coverage\":%.3f,"
              "\"tiles\":%d,\"reachable\":%d,\"map_walls\":%.3f,\"lops\":%d,\"lop_reasons\":\"%s\",\"wall_contact_s\":%.1f,"
              "\"score\":%d,\"score_parts\":\"blue %d (%d tiles), checkpoints %d, ramps %d, speed bumps %d, reliability %d, exit %d\","
              "\"lost_fraction\":%.3f,\"ramp_crossings\":%d,\"ramp_deg\":%.1f,\"obstacle_pushed_mm\":%.0f,\"last_lcd\":\"%s\"}\n",
              sc->name, seed, ideal ? "true" : "false", reason.c_str(), home ? "true" : "false", runS, total ? (double)covered / total : 1.0,
              covered, total, wallsAll ? (double)wallsOk / wallsAll : 1.0, lops, lopReasons.c_str(), contactUs / 1e6,
              score, bluePts, sbv, checkpoints * 10, srn * 10, bumpsCrossed * 5, reliability, exitBonus,
              syncSamples ? (double)lostSamples / syncSamples : 0.0, rampCrossings, W.rampDeg, pushedMm, jsonEsc(lcdText).c_str());
  if (traceOut) {
    if (runStarted) traceFrame(runS);
    *traceOut << "{\"result\":" << std::string(result, std::strlen(result) - 1) << ",\"t\":" << (int)(runS * 1000) << "}\n";
  }
  if (live) traceOut->flush();
  else std::fputs(result, stdout);
  return 0;
}
