Doom956/Robocup-Junior-Theseus/(commit log)

2026-10-01 Port to PlatformIO (C++) and fix maze exploration, black tiles and ramps
    Replaces the .ino sketch in Main/ with the C++/PlatformIO version and adds
    platformio.ini (src_dir = Main) so it builds in VS Code for the Giga R1 M7.
    Navigation / run completion:
    - Frontier-BFS exploration planner replaces the greedy pickNextDirection();
    returns home when the maze is fully explored or time is running out
    (removes the 25-move cap)
    - Black tiles: fwd() now sets blacktoggle so the position isn't advanced
    - Short/blocked moves back up and don't advance; repeated failures block the edge
    - Timeouts for fwd(), ramp climbing, backing up and obstacle avoidance
    - Checkpoints recorded on the tile actually en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
    [Color.h, Distance.cpp, Distance.h, Globals.h, MazeTile.h, Movement.h, PID.cpp, color.cpp]
2026-10-01 Simulator: fault model, large two-ramp fields, explorable generator; fix two navigation bugs it found
    Simulator (tools/sim):
    - --robot perfect|realistic|harsh adds wall misreads, stalls, wheel slip,
    miscounted ramps and missed black tiles, each routed through the robot's own
    recovery code (short move -> handleShortMove/blockEdge, checkTileMismatch,
    lack-of-progress restart at the last checkpoint), plus an 8-minute clock
    driving timeToReturn()
    - new bigramp field: two large areas on different levels joined by two ramps
    - black tiles are only placed where they don't wall off part of the field
    - reports pass rate, home-in-time, coverage, map accuracy, lost rate, restarts
    - web page: rea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
    [main.cpp, navigation.cpp, sim.cpp]
2026-10-01 Simulator: new random fields per batch by default (--random in C++), explain tile-level model
    Batches used seeds 1..N every time, so repeating a batch gave identical results.
    The web page now picks a fresh random block of seeds per batch (checkbox keeps
    fixed seeds for before/after comparisons) and shows the expected batch-to-batch
    spread. run_sim.bat keeps fixed seeds by default and gains --random / --start.
    std::random_device is deterministic on this MinGW, so --random seeds from the clock.
    [sim.cpp]
2026-10-01 Simulator: perfect-robot logic test also runs every field with no clock
    With the 8-minute clock on, runs that head home early for time passed whatever
    their coverage, so a planner bug that skipped tiles passed 98-99% of fields.
    Perfect mode now runs each field twice: no clock (must explore everything, map
    it exactly, get home) and with the clock (must get home in time). Same check
    added to the web page's perfect batch. Verified against deliberate bugs: limited
    planner search (2091/5000 fail), old ramp bug (all ramp fields fail), old
    return-time estimate (3 fail).
    [sim.cpp]
2026-10-01 Add robot sensor geometry from the CAD (tools/sim/cad)
    robot_geometry.md/.json: positions and facing of the 7 VL53L0X sensors and the
    colour sensor, in mm from the centre of the wheelbase, mapped to the code's
    measure() numbers. extract_sensors.py regenerates them from a Fusion 360 STEP
    export (plain Python). Notes the centring constants to check on the real robot.
2026-10-02 PID: start error/prevError/delta/cumError at 0
    PIDs are created fresh inside fwd(), absoluteturn() and obstacleavoidance(), and
    these members were never initialised, so the first getPID() used leftover memory.
    A large leftover prevError made fwd()'s speed scale tiny or negative and it quit
    before moving ("short move"); results changed with unrelated code such as Serial
    prints. Found by the physics simulator.
    [PID.h]
2026-10-02 Add physics simulator: real firmware against a simulated robot (tools/sim/physics)
    Compiles all of Main/ unchanged; hw/ replaces the Arduino core and libraries with
    simulated hardware on a simulated clock: motors (dead band, lag, per-motor gain),
    skid-steer driving with wall collisions, encoders, 7 VL53L0X beams from the CAD
    positions (signal-weighted 25 degree cone), BNO055 heading/pitch, TCS34725 colour,
    real ramp slopes, and a referee doing lack-of-progress restarts via the pause
    switch. run_physics.py builds and runs many fields in parallel; --selftest gives
    calibration experiments to repeat on the real robot; --fw/--patch try code
    changes on a temporary copy of Main/.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
    [physics.cpp, run_physics.py, world.h]
2026-10-02 Physics sim: datasheet motor model, magnetic-heading gyro option, VL53L0X minimum range
    Motors now follow the Pololu #3493 datasheet (72 RPM no-load at 12 V, 10 kg.cm
    stall, 80 mA / 1.6 A friction) on a Carobot V3 (TB6612FNG + PCA9685) and a 3S
    LiPo: speed = no-load speed x (duty - load/stall), load = gearbox friction +
    stiction + skid-steer drag when turning + ramp gravity. Replaces the guessed
    dead band and top speed. Encoders use the exact 195.3125 ratio.
    gyroMagnetic option models the BNO055 reporting magnetic north (team notes);
    readings under 30 mm are clamped as the team notes describe. Selftest reports
    turn rates and the derived minimum PWMs; README lists the source of each number.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
    [physics.cpp]
2026-10-02 Simulators: batch dashboard, 2D/3D replay viewer, plainer UI, instructions
    Physics simulator:
    - --trace now records everything needed to replay a run: true pose, the code's
    position and map, motor PWM, distance readings, gyro, LCD, Serial output,
    restarts and the result (results are unchanged)
    - viewer.html replays a run in 2D or 3D (three.js): robot to CAD scale, sensor
    beams, the tile the code thinks it is on, the robot's map, Serial monitor,
    timeline with lost-position stretches and restarts
    - run_physics.py --view records one field and opens its replay
    - run_physics.py --serve starts a local batch dashboard (server.py +
    dashboard.html): run batches on all cores, results per fie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
2026-10-02 Physics simulator: live view with many robots running at once
    - physics.exe --live: writes the recording to stdout as the run happens,
    paced to the wall clock (--live-speed X, 0 = as fast as possible), and
    takes commands on stdin: pause, resume, speed X, lop, nudge, stop.
    Identical to a batch run of the same seed until a command changes it.
    - live_io.cpp: wall clock, sleep and non-blocking stdin (kept apart from the
    Arduino stand-in headers)
    - run_physics.py --live: opens live.html in an app window (Edge/Chrome);
    1 to 16 robots on random fields, speed 1x to max, pause, keep going with
    new fields and a running tally, per-robot detail (beams, map, Serial),
    bump / restart at check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
2026-10-02 Physics sim: datasheet values; BNO055 follows the firmware's mode
    - BNO055: the stand-in records the mode passed to begin()/setMode(). NDOF
    (the Adafruit library default, used by gyro.cpp) gives heading from
    magnetic north as the datasheet (3.3.3.5) says, with +-2.5 deg error
    (datasheet heading accuracy); IMUPLUS gives heading from the start.
    gyroMagnetic now defaults to -1 = follow the firmware.
    - VL53L0X noise 3 % per reading (datasheet: 4 % std dev at 33 ms incl.
    part-to-part)
    - TB6612FNG 0.5 ohm in series with each motor (datasheet ON resistance)
    - TCS34725 counts clip at (256 - ATIME) x 1024 (datasheet)
    - robot mass 1.15 kg, estimated from the parts' datasheets (README table)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
    [physics.cpp]
2026-10-02 Physics sim: fix runs that never finished; time limit per run
    - simAdvance: the 32-bit build keeps the target time at higher precision
    than the clock, so a sub-nanosecond leftover could never be stepped off and
    the run spun forever (ramp seeds 135 and 180 hung a 200-run batch).
    Leftovers under 1 ns now finish the step.
    - run_one: a run with no result after 2 minutes is reported as crashed
    ("simulator stuck") instead of holding up the batch.
    200 ramp fields: 44 s instead of 16+ minutes.
    [physics.cpp, run_physics.py]
2026-10-02 Physics sim: RCJ black-tile rule; long result lines
    - Referee: lack of progress when more than half of the robot's footprint
    (CAD outline, 12 x 12 sample points, checked every 5 ms) is over one black
    tile, instead of when the robot's centre is on it.
    - The result line grows to fit; a run with many restarts overflowed the
    1024-byte buffer, the line was cut off and the batch reported "crashed".
    [physics.cpp]
2026-10-02 Physics sim: NDOF heading stays relative until the magnetometer calibrates
    The real robot explored like a relative heading, so the BNO055 in NDOF
    mode (bno.begin() default) most likely never finished magnetometer
    calibration during a run. gyroMagneticAfterS now defaults to never:
    the heading is relative to the start, with drift. Set it to 0 or e.g. 60
    to test the heading switching to magnetic north.
    Exploration back to ~49% on small fields (was 5-20%); stuck restarts
    ~1 per run (was 1.5-2).
    [physics.cpp]
2026-10-02 Physics sim: RCJ 2026 field, referee and scoring; real robot outline
    Field (rules 3.1, 3.3, 3.4):
    - walls 20 mm thick with posts at their ends (280 mm path); distance
    sensors see the wall faces and ends
    - obstacles: upright cylinders 5-9 cm across, in the open (>= 20 cm from
    every wall) or touching a wall and reaching at most 10 cm in
    - speed bumps: 1 cm, across the middle of a tile, not on ramps
    - settings: wallThicknessMm, obstacleRate, bumpRate, bumpHeightMm
    Referee (5.4, 5.5): a tile is visited when more than half of the robot is
    on it; lack of progress on a black tile or when leaving a blue tile
    without standing still 5 s.
    Score (5.6, navigation part): blue tiles, checkpoints, ram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
2026-10-02 Navigation fixes found with the physics simulator
    - centerLeft(): the distance term had the wrong sign, so following a left wall
    steered the robot toward it instead of away (center() for the right wall was
    already correct; both feed the same PID and motor mix).
    - PLAN_NEXT: when the map looks finished with more than 150 s to spare, clear
    the edges blocked after failed moves and look again (max 3 times per run);
    put them back if that opens nothing new.
    - absoluteturn(): one loop for both directions that stops within 2 deg of the
    target and turns back on overshoot; at least 1 s for small corrections.
    - fwd(): no new obstacle avoidance from the fwd() that avoidance itself runs
    (unbo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
    [Distance.cpp, Movement.h, main.cpp, movement.cpp, sim.cpp]
2026-10-02 Centre between two side walls by balancing the gaps
    With walls on both sides, fwd() now centres on the difference between the left
    and right gaps instead of holding TARGET_SIDE_GAP_MM from the right wall. That
    needs no robot-width constant, so it centres correctly even while
    ROBOT_WIDTH_MM (140) doesn't match the real robot. With one wall it behaves as
    before (center() / centerLeft()); with none it holds the gyro heading.
    Physics sim, 200 fields per type, same fields: score 33.4 -> 36.9 (+3.6 +-1.9),
    explored 35% -> 39%. Between two walls, tiles where the robot is more than
    35 mm off centre: 14% -> 5%; false obstacle triggers per run 4.9 -> 4.2.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
    [Distance.cpp, Movement.h, movement.cpp]
2026-10-02 Let a restart recover a robot that stopped on the way home
    RETURN had two endless loops: "no path found" (while(true) fullstop) and
    "back to start" (while(true) blink). Neither checked the pause switch, so a
    lack-of-progress restart couldn't revive the robot; only a power cycle could,
    and that loses the map. Both now stop exactly as before but leave on the pause
    switch, so the restart puts the robot on its last checkpoint and it heads home
    again. Untouched, the behaviour is unchanged.
    Physics sim: a captain now calls lack of progress 2 s after the robot stops
    for good away from home; if the code doesn't respond, the run ends there and
    that restart isn't counted (identical results for the ol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
    [main.cpp, physics.cpp]
2026-10-02 Physics sim: 1.7x faster, same results; oracleTile analysis switch
    - sin/cos of the robot heading, pitch and collision headings are remembered for
    the last angles asked for (they were almost half the run time), floor() in the
    footprint test is an inline integer version, and the motor lag exp() is only
    recomputed when the step length changes. Results and recordings are
    byte-for-byte the same as before (checked on 60 runs and a full trace).
    - --set oracleTile=1 (analysis only): puts the code's map position right each
    time it starts reading a tile, to measure what getting lost costs.
    [physics.cpp]
2026-10-02 Stop each move in the middle of the tile, from the wall ahead or behind
    Moves were ending a median 30 mm short of the tile centre (encoder slip, the
    speed ramp quitting early), and a turn then turns that into a sideways offset
    that scrapes walls and makes the robot lose its place. The old front-wall
    centring only ran with a wall directly ahead and aimed for a 65 mm gap
    (TARGET_GAP_MM from ROBOT_LENGTH_MM 170), while a centred robot reads ~42 mm.
    centreAlong() squares up, then uses the nearer wall in view, ahead (both front
    sensors agreeing) or behind, up to about one tile past this one. With 300 mm
    tiles and 20 mm walls, a centred robot reads (280/2 - sensor offset) + 300 mm
    per tile; the C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
    [Distance.cpp, Movement.h, main.cpp]
2026-10-02 Physics sim: oracleCentre analysis switch (robot put in the tile centre when it reads a tile)
2026-10-03 Distance sensors: 100 ms read timeout so one dead sensor can't freeze the robot
    The Pololu VL53L0X library has no read timeout unless setTimeout() is called,
    so readRangeContinuousMillimeters() waits forever if a sensor stops answering
    (loose cable, I2C glitch) and the whole robot stops for the rest of the run.
    init_dist() now sets 100 ms (a reading normally takes 33 ms); a timed-out read
    returns 65535, which measure() and calibrateSensor() now treat as no reading.
    Found by the simulator on the team repo (sim/FINDINGS.md finding 1). Normal runs
    in the physics sim are unchanged.
    [Distance.cpp]
2026-10-03 Wall follower: ignore a side whose two sensors disagree by more than 60 mm
    Where a side wall ends beside the robot, one sensor of that side already sees
    past the wall's end (or into the gap before the next wall, still under the 200 mm
    "wall present" limit) while the other still sees the wall. sideCentringError()
    read that as one wall at a steep angle (errors of -100 to -170) and steered
    hard enough to swing the heading 30-50 deg, and the robot lost its place. The
    two sensors of a side are 176 mm apart (CAD), so a real wall only reads more
    than 60 mm differently when the robot is already turned ~19 deg; such a side is
    now not used (the other wall, or the gyro heading, steers instead).
    Seen i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
    [Distance.cpp]
2026-10-03 Take gyro drift out of the heading whenever the robot squares up on a wall
    Walls run along the tile grid, so after parallel() has squared the robot to a
    wall (its two side sensors, 176 mm apart, within 3 mm: within ~1 deg) the true
    heading is 0, 90, 180 or 270 deg. gyro::resyncToNearestCardinal() shifts a
    heading offset by whatever the BNO055 reads beyond that, if it is at most 10 deg
    (a bigger difference means the squaring-up went wrong, so it is left alone).
    Turns, fwd()'s heading hold and the cardinal snaps all use the corrected heading.
    The real drift of the BNO055's fused heading isn't in its datasheet and hasn't
    been measured on the robot yet, so this was tested at several drift level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
    [Distance.cpp, gyro.cpp, gyro.h]
2026-10-03 Ramps: steer between the side walls while climbing, not only by gyro
    The climb loop held the gyro heading only. A robot that reached the ramp a bit
    off-centre or angled scraped a side wall all the way up; the wheels slipped,
    the encoders over-counted and the ramp came out a tile or two too long (in the
    physics sim about half of all ramp crossings left the position wrong, and
    climbs that stuck for the 15 s limit counted 6-9 tiles). It now uses
    sideCentringError() (two-wall balance, wall-end check) like fwd() on the flat,
    and falls back to the gyro when the walls aren't both in view. Walls are
    vertical, so tilting along the slope doesn't change the side readings.
    Physics sim, same fields, 200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
    [movement.cpp]
2026-10-03 CLAUDE.md: add the note on unmeasured gyro drift
2026-10-03 ab.py: 95% intervals for time lost and back home; CLAUDE.md working rules; ignore .claude/
    ab.py now prints the paired change in time spent lost and in runs back home, each with its 95%
    interval, next to the score: the sim has no victims, so staying on track and getting home matter
    more in a real run than the score shows. CLAUDE.md: git pull first, 600-field decisions, LOGIC BUG
    vs PHYSICS-DEPENDENT labels and the robot-test branch.
    [ab.py]
2026-10-03 fwd(): steer for the whole tile, not just the last 60 mm (LOGIC BUG)
    The wheel commands were constrain(Scale*(120 -+ adjustment), 20, 150). Scale starts around 5, so
    both sides were clipped to 150 and the gyro / side-wall correction did nothing until the last
    ~60 mm of each tile: a robot that finished a turn a few degrees off drove the whole tile at that
    angle and scraped the side wall. Now the base speed comes down while correcting, so base +-
    adjustment always fits under 150 and the whole correction is applied.
    With the follower acting all the way through the tile, a side whose two sensors differ by 30-60 mm
    (the front one already past the end of the wall) made it weave, so the wall-end c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
    [Distance.cpp, movement.cpp]
2026-10-03 Physics sim: lostcause.py, where and why the robot first gets lost
    Records many runs and sorts each by what happened just before the code's map position first went
    wrong (false obstacle alarm, real obstacle, pushed an unseen obstacle, scraped a wall, ramp, ...).
    Also counts run endings, referee restarts, and whether the position stayed right while driving home.
    [lostcause.py]
2026-10-03 Ramps: decide up or down from the same pitch reading that found the ramp (LOGIC BUG)
    fwd() read the gyro once to see the ramp (|pitch| > 12 deg) and again to decide whether it goes up.
    With the pitch just past the threshold (noise, whole degrees), the second reading could miss it, so an
    up-ramp was taken as a down-ramp: descend() instead of elevation() (map on the wrong floor) and the
    downhill power on the way up. That was most of the ramp first-losses in the physics sim (code's floor
    1-2 below the real one).
    Physics sim, 600 comp fields vs main: score +1.4 +-2.8, time lost -3 +-2 pts, back home +5 +-4 pts.
    ramp / bigramp fields (300 each): no change. pio run builds; logic sim ALL PASSED.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
    [movement.cpp]
2026-10-03 Bench mode (BENCH_MODE in main.cpp, off by default): measure on the robot what the simulator guesses
    Distance sensors in a closed tile vs the CAD, lowest turning and driving PWM, turn rate at 150, encoder
    distance and heading change over a 2 s straight drive, gyro drift standing still. The pause switch starts
    each test. With BENCH_MODE 0 nothing changes: physics sim identical on 100 comp fields, pio run builds.
    [bench.cpp, main.cpp]
2026-10-03 Backing up into a blue tile after leaving it: stop 5 s again (LOGIC BUG, RCJ rules)
    A move that got more than half the robot onto the next tile and then backed up (short move, front
    blocked) re-visits the start tile (RCJ 5.4.4). If that tile is blue, the robot must stand still 5 s
    again before moving on (5.5.1c), or the referee calls lack of progress. backUpToStart() now does.
    Physics sim, 600 comp fields vs overnight-fixes: score +0.2 +-0.3 (no harm); on robot-test, where the
    obstacle back-off makes it more common: +0.7 +-0.8, restarts 0.64 -> 0.58. pio run, logic sim pass.
    [movement.cpp]
2026-10-03 lostcause.py: sort what went wrong on the way home too; check the position at the start of each RETURN move
    Standing still inside a move doesn't count any more: on a ramp the code's position lags one tile until
    the move ends, which looked like a lost position.
    [lostcause.py]
2026-10-03 tools/robot_log.py: read a real robot's Serial log and list where it struggled
    Counts how moves ended, obstacle checks and avoidance, turns that missed, walls that didn't match the
    map, position corrections, ramps (tilt when detected), steering swings (weaving), and collects the
    [BENCH] lines. The physics simulator prints the same lines (--verbose), so the two can be compared.
    [robot_log.py]
2026-10-03 parallel(): turn back if it squared up off the grid (LOGIC BUG)
    parallel() turns until the two side sensors read the same. In a corner each can see a different wall
    and read the same with the robot turned ~45 deg; it stopped there ("paralleled"), and the walls were
    then read at that angle (wrong map, wrong relocalize). Walls only run along the grid, so a result more
    than 10 deg from every compass direction can't be squared: it now turns back to where it started.
    Physics sim, 600 comp fields: vs main +2.8 +-4.3, restarts 1.21 -> 1.05 per run; vs robot-test +1.1 +-3.8,
    restarts 0.52 -> 0.34. pio run, logic sim pass.
    [Distance.cpp]
2026-10-03 Steering in open areas: a side wall one tile further out also gives the sideways position
    sideCentringError() only used side walls within 200 mm, so in open areas fwd() had nothing to centre
    on and the robot drifted 100-150 mm off-centre (then scraped corners and false obstacle alarms). A side
    reading of 260-440 mm is the wall one tile further (a centred robot reads 49 mm to its own tile's wall,
    349 mm to the next; tiles are 300 mm) and now counts as that reading less 300. 200-260 mm stays unused
    (can't tell which wall); the 30 mm front/back agreement check still applies.
    Physics sim, 600 comp fields vs main: seeds 1-600 +1.0 +-4.5, seeds 601-1200 +5.9 +-4.4; time lost
    -5 +-3 pts and back h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
    [Distance.cpp]
2026-10-03 Physics sim: obstacles that move when pushed (RCJ 3.4.3 / 3.4.5), off by default
    With --set obstacleMovableFrac=F that share of the obstacles is loose (mass obstacleMassMinKg..MaxKg,
    floor friction obstacleMu; ASSUMED, the rules only say "large, heavy items" that may be fixed). The robot
    pushes a loose one along when its wheels' grip beats the obstacle's friction, slowing down by the share
    the friction takes; a wall or another obstacle stops it, and it stays where it ends up (3.4.5). The
    distance sensors see it in its new place, the replay viewer shows it moving (2D and 3D), and the result
    line has obstacle_pushed_mm. Default 0: results identical to before (checked on 20 fields).
    robot-test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
    [physics.cpp]
2026-10-04 CLAUDE.md: what was tested today and held, the open camera-thread question
2026-10-04 Bench mode: heading at power-on, floor colour readings
    Prints heading() before the tests (should be about 0 whichever way the robot faced at power-on;
    otherwise the BNO055 is in magnetic-north mode), and adds test 7: what read_color() says on white,
    blue, silver and black tiles vs the thresholds. Bench mode is off by default (BENCH_MODE 0).
2026-10-04 Obstacle avoidance: don't move the map on when the closing drive came up short
    handleAvoidanceResult() cleared fwdShort after every completed avoidance, so when the fwd() at the end
    of obstacleavoidance() didn't get halfway and backed up, the map still moved the robot one tile on.
    LOGIC BUG. Sim, 600 comp fields: seeds 1-600 +4.4 +-2.0, time lost -4 +-1 pts, home +2 +-2;
    seeds 601-1200 +5.1 +-2.0, time lost -4 +-2 pts, home +2 +-3.
    [movement.cpp]
2026-10-04 CLAUDE.md: gyro mode, colour thresholds, avoidance fwdShort fix
2026-10-04 CLAUDE.md: camera thread stays as it is (user's decision)
2026-10-04 Obstacle avoidance: measure the distance left with the same front sensor
    The closing drive's length came from the clear-side front reading before the manoeuvre minus the
    front-right reading after it. With the obstacle on the right those are two different sensors, so the
    "distance travelled" was often more than a tile and the robot drove 0 mm while the map moved a tile.
    Also count only readings under 2 m: VL53L0X out of range is 8190, which measure() passes through.
    LOGIC BUG. Sim, 600 comp fields: seeds 1-600 +1.9 +-2.6, time lost -2 +-2 pts, home +2 +-3;
    seeds 601-1200 +0.9 +-2.6, time lost -3 +-2 pts, home +2 +-3. robot-test (with the next fix) -0.0 +-0.9.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
    [Distance.cpp]
2026-10-04 EXECUTE_MOVE: reset the obstacle flag before each move, as RETURN does
    After an avoidance whose closing drive ended on black, BACKPEDAL goes straight back to planning, so
    the flag stayed set and the next normal move blocked an edge that had no obstacle. LOGIC BUG (rare).
    Sim, 600 comp fields: +0.0 +-0.0 (seeds 1-600) and +0.0 +-0.2 (601-1200).
    [main.cpp]
2026-10-05 CLAUDE.md: steering limit on robot-test, front-wall check held, ab.py --start
2026-10-05 Bench mode without the LCD or a USB cable: LED shows the state, results printed again at the end
    The LCD doesn't work, and a USB cable tugs on the robot during the turning and driving tests. The LED
    now blinks slowly while waiting for the switch, stays on during a test and blinks fast when done. All
    results are kept; after the last test each switch flip prints them again, so the tests can run
    unplugged. The test list is at the top of bench.cpp. Numbers are formatted without printf("%f").
    BENCH_MODE stays 0 by default (firmware unchanged).
    [bench.cpp]
2026-10-07 Physics sim fitted to the robot's bench mode; bench tests 2-4 report encoder counts
    Bench mode on the real robot (2026-10-06, 3 runs, battery 11.76 V):
    - lowest turnright() PWM that turns it 5 deg in 1 s: 25/30/25 (sim was 45)
    - turnright(150) for 1 s: 97/92/95 deg (sim was 70)
    - gyro at rest: 0.00 deg in 2 min (sim assumed 0.5 deg/min)
    - distance sensors read long: left+right +20 mm, front+back +13 mm over the CAD
    Sim: wheelMu 0.8 -> 0.2 and skidFactor 1.3 -> 1.1 (fitted: 25 and 95 deg), new tofOffsetMeanMm 8,
    gyroDriftSigmaDegPerMin 0.5 -> 0.03, batteryVoltage 11.76. --selftest repeats bench tests 2-4 with the
    same pass rules (BENCH lines). README table updated with the sources.
    bench.cp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
2026-10-07 NEXT_STEPS.md: what was done on 2026-10-06, PC setup, software checks left; analysis tools and bench logs
    - NEXT_STEPS.md: setup on another PC, today's bench and sim results, the software checks left
    (low-power stall, sensor offsets, re-check held experiments, exploring faster, robot-test to main),
    the in-person tests left and the obstacle to print.
    - tools/sim/physics: scoregap.py (where the missing points go), earlydone.py (why "maze fully explored"
    comes too early), timeprof.py (where the exploring time goes), hdgerr.py (heading error and wall re-sync).
    - tools/serial_log.py records the robot's Serial output (finds the GIGA on any port); robot_log.py now
    reads those files (time in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
    [earlydone.py, hdgerr.py, robot_log.py, scoregap.py, serial_log.py, timeprof.py]
2026-10-07 Bench test 11: each distance sensor against a wall at exactly 100 mm, SENSOR_OFFSET_MM ready to paste
    One switch flip per sensor: a flat wall 100 mm in front of it (a printed 100 mm spacer), square to it.
    calibrateSensor() averages 100 raw readings; the last line is the SENSOR_OFFSET_MM array for
    Main/Distance.cpp. Test 1 can't give single-sensor offsets (the robot is centred by hand, +-5-10 mm).
    BENCH_MODE stays 0 by default.
    [bench.cpp]
2026-10-07 Physics sim: weak motor A at low power, fitted to bench test 4
    Bench mode on the robot (2026-10-06): wheel A (left front) only turned forward from PWM 49-51 and then
    counted 42-56 against 250-340 for B and D, but counted like the others at PWM 150. New parameter
    motorAExtraFriction (0.16, fading to 0 at PWM 128); --selftest tests 2/3/4 = 30 / 93 deg / 51
    (robot 25-30 / 92-97 / 49-51). Off in --ideal. Sim, 600 comp: main 124.6 -> robot-test 144.8 (+20.1 +-4.4).
2026-10-07 NEXT_STEPS.md, CLAUDE.md: software items 1-3 done (weak motor A, bench test 11, held experiments re-checked)
    Minimum drive PWM 55 in fwd() tested (+7.2 / +5.5 vs robot-test) but not pushed: waiting for the steering log.
2026-10-07 Pause switch: use the GIGA's internal pull-down on pin 22 (LOGIC BUG)
    The switch connects pin 22 to 3.3 V for "pause" and leaves it open for "run". With pinMode INPUT the open
    pin floats. On 2026-10-07 the board's pull-down resistor had come loose: pin 22 read HIGH 483 of 485
    times whatever the switch position, so the robot sat paused or inched (resumed for a moment, paused
    again). Switch test: pause position pulldown/pullup/plain = 1/1/1, run position 0/1/1. INPUT_PULLDOWN
    holds the open pin low with or without the resistor. Not modelled in the sim (no change there).
    Also tools/sim/physics/stopcentre.py: where along the tile each move ends, before and after centreAlong().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
    [main.cpp, stopcentre.py]
2026-10-07 CLAUDE.md: 2026-10-07 robot findings (pause switch wiring, 4 s camera wait, stopping short of the middle)
2026-10-08 Physics sim: INPUT_PULLDOWN in the Arduino stand-in (the sim didn't build since eaa0af4)
2026-10-12 robot_log.py: where moves stop along the tile (over/undershoot) and no-progress stops
    Counts the "centring along: X mm off" lines (printed when a move stopped more than 10 mm from the middle):
    median, more than 30 mm short / past. Also counts "[FWD] no progress".
2026-10-13 Bench test 11 leaves side sensor offsets at 0 (correcting them loses points); ab.py reports the bad runs
    Sim: correcting the side sensors to exact readings moves the one-wall steering off its tuned
    position (robot-test -10.0 +-6.1, main -4.5 +-7.2 on 200 comp fields). Bias 4-20 mm is fine.
    ab.py: second line with worst-10% score, runs under 120, runs ever lost, runs restarted.
2026-10-13 CLAUDE.md: ramp exit stop, wrong home stop loop and side-sensor balance test (tested and held)
2026-10-17 Physics sim: weighed robot mass 1.955 kg, wheelMu refitted to 0.17; 2026-10-16 move test logs and notes
    The parts-list estimate was 1.15 kg. With wheelMu 0.17 the sim's bench tests 2/3/4 stay at 30 / 91.8 deg / 51
    (robot 25-30 / 92-97 / 49-51). main -> robot-test on 600 comp fields: +50.4 +-4.7 (was +47.4 at 1.15 kg).
2026-10-17 LCD status display: position line + last event, NO GYRO warning; LCD test (BENCH_MODE 3)
    Display only (Main/display.cpp). Line 1: tile from the start, floor, facing, run time. Line 2: the last event
    (CHECKPOINT, BLUE 5s, BLACK, RAMP UP/DOWN, EXPLORED, back to start, no path found, PAUSED, RUNNING, NO GYRO! check).
    The explored/home/no-path messages no longer pause 1 s (lcdPrint); "back to start" and "no path found" keep their
    text because the simulator ends runs on them. Victim messages are unchanged. Tested on the real robot's new LCD
    (2026-10-17) on robot-test; main builds (pio run) and the simulator compiles.
2026-10-17 LCD: the NO GYRO warning stays on screen (PAUSED replaced it at power-on)
2026-10-17 Power-on check of the gyro, colour sensor and 7 distance sensors; a problem stays on the LCD (TOF DEAD: LB, NO GYRO! check, ...)
2026-10-17 LCD: every start-up problem on one line (!GYRO COLR LB FR), READY at power-on instead of PAUSED
2026-10-18 LCD: never wait for the display (skip the update if the camera's victim message holds it)
2026-10-18 NEXT_STEPS.md 1b: camera wait option added to the simulator list
2026-10-18 NEXT_STEPS 1b item 1: the robot undershoots (stops short), not overshoots; measure first, then min PWM 60/65
2026-10-18 Physics sim: motor speed, skid steering and grip fitted to the robot's move tests (one tile 1.1 s, not 2.7); selftest repeats M3 and M1
    noLoadRpmAt12V 72 -> 170, skidFactor 1.1 -> 2.5, tractionMean 0.97 -> 1.0. Robot (logs/2026-10-16, 2026-10-17):
    one tile 1.08-1.13 s, 27-29 fwd() loops, 297-326 mm; turnright(150) 1 s 92-97 deg; 90 deg turn 0.77-1.01 s.
    Sim on robot-test now 1.16 s, 27-28 loops, 302 mm; 97.5 deg; 1.1 s. Bench tests 2/4 unchanged (30 / 51).
2026-10-18 Physics sim: replacement left-back sensor reads 30 mm long (as measured), motor torque and turning drag fitted to the robot's ramp and bench tests
    tofLeftBackExtraMm 30 (2026-10-17: the new left-back sensor reads 26-30 mm more; robot-test corrects it with
    SENSOR_OFFSET_MM[5] = 30, which in the sim made robot-test square up crooked on left walls: -50 points).
    stallKgcmAt12V 10 -> 4.2 (ramp up at PWM 180 as slow as down at PWM 120 on the robot), wheelMu 0.17 -> 0.071
    (bench test 2 stays 30). Fitted sim: main -> robot-test +70.4 +-5.6 / +58.8 +-5.7 (600 comp, both seed sets).
2026-10-18 NEXT_STEPS.md 1c, CLAUDE.md: simulator fitted to the robot, left-back sensor, robot-test vs main on the fitted sim
2026-10-18 Physics sim: distance sensors also see the floor and ramp slopes (cone reaches the ground), fitted to move test M0; selftest M0 lines
    tofFloorGain 3: on open floor the robot's back sensor (43 mm up) read 266-373 mm, front 685-702, sides 669-763; sim back
    ~340, front ~770, sides ~750. A wall one tile out still reads 342-364. NEXT_STEPS: what it showed (back-sensor centring).
2026-10-18 Physics sim selftest: move tests M6/M8 with a box 100-250 mm ahead; NEXT_STEPS: the 2n gap
2026-10-18 2026-10-18 move test logs (M7 motor RPM, M6/M8 box)
2026-10-18 Physics sim: motor-to-motor speed spread 12% as measured (M7); selftest repeats M7; SIM_WORKLIST A1 result
    M7 (wheels in the air) read 15-25% under the speed the moves and turns need (low battery?), so the speed fit stays;
    the 12% spread between wheels is kept (robot-test -15.3 +-6.3 with it).
2026-10-18 Physics sim: wheel spread back to 0.03 until checked (12% double-counted motor A); SIM_WORKLIST A1 corrections
2026-10-18 Physics sim: wheel spread 5% (B vs D in M7; motor A stays separate); SIM_WORKLIST A1: fw(150) fit check
2026-10-18 Physics sim: obstacle size as parameters (obstacleRMinMm/RMaxMm, default 25-45 as before: assumed); NEXT_STEPS/SIM_WORKLIST: results on sim 553492e, B11 steering
2026-10-18 CLAUDE.md rules: real robot beats the sim, keep guards from real failures, don't explain away measurements, no double-counted sim parameters, mirror robot calibrations in the sim
2026-10-19 Run clock starts at the first switch flip (run start), not at power-on (logic fix)
    A robot switched on minutes before its run thought those minutes were used and headed home early. LoP restarts via
    the pause switch keep the clock running; cutting the power resets it. Sim (robot-test, 300 comp): -1.1 +-2.3.
2026-10-19 Firmware prints its git commit at start-up (FW_VERSION via tools/fw_version.py); CLAUDE.md: unconfirmed-changes list, logs name the firmware and battery, reporting and freeze rules
2026-10-19 SIM_WORKLIST A1: M7 repeated at 11.98 V (same result: not the battery); 2026-10-18 robot logs
2026-10-19 serial_log.py: timestamps to the millisecond (speed within a move); robot_log.py reads both formats; SIM_WORKLIST A1: M7 conflict checked, open
2026-10-19 Physics sim: obstacles against a wall reach at most 10 cm in from the tile edge (rule 3.4.4b), bigger ones only in the open
    The comment said so but it wasn't checked: with obstacleRMinMm/RMaxMm above 45 mm the generator put 15-20 cm obstacles
    against walls. Default 5-9 cm fields are unchanged (2r <= 90 mm).
2026-10-19 Physics sim: grip for pushing a loose obstacle is its own parameter (pushGripMu 0.8, assumed), not wheelMu
    wheelMu became the turning drag (0.071) when it was fitted on 2026-10-18, which left the robot unable to push any loose
    obstacle (loose = fixed in every run). Default fields have no loose obstacles: unchanged.
2026-10-19 SIM_WORKLIST D1: robustness table for robot-test on the current sim
2026-10-19 SIM_WORKLIST A3: practice maze measured (20 mm walls, 295 mm between wall faces)
2026-10-19 Practice maze tiles are ~320 mm (RCJ: 300): explains the short stops and centring readings; noted in CLAUDE.md and SIM_WORKLIST A3
2026-10-19 Practice maze: bare tile 320 mm, with walls ~315 mm pitch
2026-10-19 Practice maze: pitch 320 mm (walls on the tile joints), path ~300 mm
2026-10-19 SIM_WORKLIST N1: down-ramp 180 mm: no score harm, but 10-18% of descents end 30+ mm past on 300 mm tiles
2026-10-19 Physics sim: tile size as a parameter (tileMm, default 300 per rule 3.1.2; 320 = the practice maze); trace header has it
2026-10-19 fwd(): a pitch over 35 deg isn't a ramp, and a ramp counts at most 3 tiles (logic fix, rules 3.1.5)
    2026-10-19 (logs/2026-10-19 ramp.txt): the robot picked up mid-run (pitch up to 55 deg) counted ~60 ramp sections in
    3 s and the map ran out. Sim (600 comp, both seed sets): robot-test -1.3 +-2.9 / +0.8 +-2.7, main +0.9 +-2.4 / +0.8 +-2.3.
2026-10-19 SIM_WORKLIST A1: the sim's moves match the robot's from the ms-stamped maze logs (1.03 vs 1.04 s, 346 vs 339 mm/s)
2026-10-19 SIM_WORKLIST A2: explained by the 320 mm practice tiles (N2)
2026-10-19 Physics sim: slopeDrag parameter (extra resistance on slopes; 0.8 fits the robot's ramp timing, default 0 for now)
2026-10-19 TEST_PRIORITY.md: robot test priority list (ramp guard, obstacle strategy, relocalize, cameras-on runs, move tests)
2026-10-19 Stairs: the robot drove up 2 cm steps by itself (user, 2026-10-19); SIM_WORKLIST B12 and CLAUDE.md
2026-10-20 Physics sim: tofExtraMm1..7, an extra offset for one distance sensor (analysis only, 0 by default)
2026-10-20 SIM_WORKLIST D1: robustness sweep (side sensor pairs and ramp detection are the weak spots), ramp detection options A-D
2026-10-20 Physics sim: the BNO055 output updates at 100 Hz (reads within 10 ms return the same sample)
    Before, every read had fresh noise, so averaging back-to-back reads looked useful in the sim but can't be on the robot.
    robot-test, 600 comp: score -0.7 +-3.3, home -1 +-4 pts, time lost +0; bench/turn numbers unchanged.
2026-10-20 Physics sim: a run starts with the pause switch flipped to run after 0.5 s, as on the robot (startPauseS)
    Without it the code's first PAUSE was a referee restart: since 68e0c47 that restarted its run clock mid-run (main's
    home rate dropped ~5 pts in the sim for that), and the white reference was taken on a checkpoint, not the start tile.
2026-10-20 SIM_WORKLIST 2026-10-20: regression check, sim fixes (100 Hz gyro, run start), ramp cap, avoidance P2/P3 written up for decision, 2p rework
2026-10-20 Avoidance: square to the tile direction before measuring the distance left (P3, logic fix)
    The closing drive's length came from two front readings, the second taken while the robot was still turned 10-15 deg
    (a corridor leaves no room to straighten): a turned sensor measures along its own ray, and in a corridor that ray hits a
    side wall, so the robot drove 0 mm and the code counted the tile (sim test 6, seeds 2/3). Sim, 600 comp, main:
    -0.6 +-3.3 / -0.3 +-3.4 (no harm); robot-test with P2: +3.1 +-1.9 / +4.0 +-2.5. pio builds.
2026-10-20 Display stands for the Waveshare 2inch screen (flat tray and 60 deg, cad/display_stand); 2026-10-17 start-up check log
2026-10-21 Display stand: flat tray with the wire slots in the left and right walls (DisplayStand_flat_sides.stl)
    Same tray as DisplayStand_flat (64 x 41 x 12.6 mm, posts, floor for glue), back wall solid, a 24 mm slot raised 3 mm
    in each side wall, centred on the board and clear of the posts. The two existing stands are unchanged.
2026-10-21 2026-10-21 logs: start-up check after the 12 V (all sensors present), dispenser test (8 drops), move tests (motors and turns as on 2026-10-16/18; M3 blocked by a cable)
2026-10-21 Backup of the left camera's drive as found 2026-10-21 (main.py = Baichen's colour-blob test from 2026-07-04, trained.tflite + labels.txt from 2026-02-20)
2026-10-21 Backup of the right camera's drive as found 2026-10-21 (main.py = Baichen's improved colour-blob test from 2026-07-04; same trained.tflite as the left)
2026-10-21 Rescue kits: 10.4 mm cubes with a closed hollow for a 6 mm steel ball (print pause at 8.4 mm); one kit and a plate of 10
    RCJ Rescue Maze 2026 rule 3.7.3: at least 1 cm in each dimension and 1 cm3. Generator cad/rescue_kit/make_kits.py.
2026-10-21 Rescue kits: walls 1.2 mm (was 2), hollow 8.0 mm (was 6.4); pause at 9.2 mm
2026-10-21 Rescue kits: 10.2 mm and 10.0 mm versions (was 10.4), pick after measuring a test print and checking the dispenser
2026-10-21 Rescue kit case: tray with 20 pockets (5 x 4, 10.6 mm) and a press-on lid with a pull tab
    Kits stick out 1.5 mm above the dividers to grab, sit 1.8 mm below the outer wall; the lid's lip fits inside the wall.
2026-10-21 Rescue kit case: sliding lid (grooves in both long walls, entry at the low end wall, stop at the other), tray and lid in one STL
2026-10-21 COMPETITION.md: checklist for calibration day, runs, freeze, cameras, packing
2026-10-22 Physics sim: real fields drawn as text (--scenario <file>.txt, fields/README.md) and greyCheckpoints
    A field file gives walls, tile colours, levels, one east-west ramp, start tile and facing, and optional obstacles and
    speed bumps; tile_mm and ramp_deg lines set the tile pitch and ramp angle. greyCheckpoints=1 makes checkpoint tiles
    read like the team's grey tile (red 304, blue 568), which read_color() takes for a plain tile.
    Generated fields unchanged: comp seeds 1-8 and t2 give identical results before and after.
2026-10-22 COMPETITION.md: values for the actual runs (firmware, camera files folder, venue camera calibration per camera)
